erichtang/mainboard/hardware/foras-promineo-revB-em/images/mainboard-brd-bot.jpg

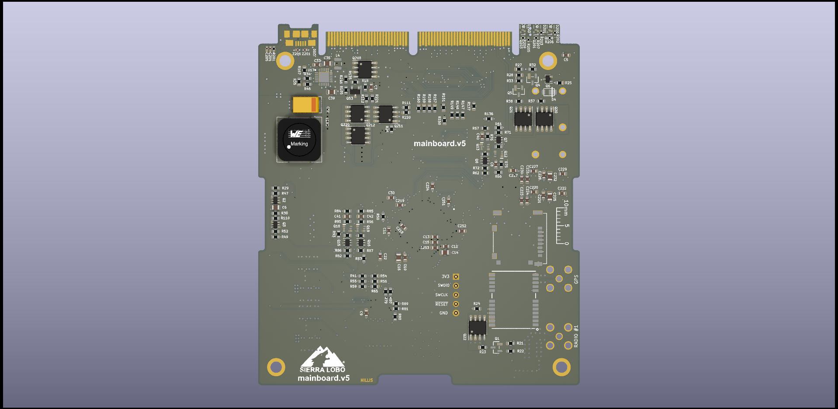
hardware/foras-promineo-revB-em/images/mainboard-brd-bot.jpg
