erichtang/mainboard/hardware/foras-promineo-revA-proto/images/mainboard.jpg

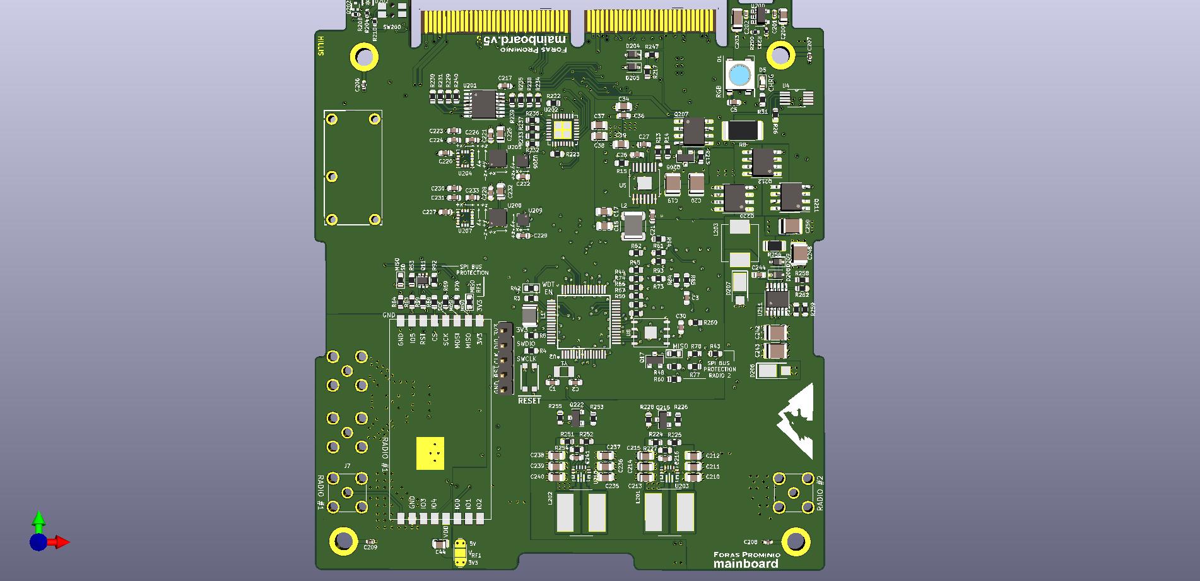
hardware/foras-promineo-revA-proto/images/mainboard.jpg
