erichtang/mainboard/software/foras-promineo/Foras Promineo Software Primer.pptx

## Foras Promineo Software

## Helpful References

- https://pycubed.org/
  - Site for all things pycubed. Very good Documentation by Max Holliday
- https://github.com/pycubed/forums/discussions
  - Forms where a lot of people have asked relevant questions

## Preferred IDE for Satellite Coding

- Visual Studio Code
  - With Python extension and PyLint extension
    - Pylint needs to be played with a little bit

## Using GitHub for code sharing

- Installing GitHub desktop
- Making a folder on your Z-drive
- Forking the repository
- Pushing changes to the master branch

## What is a Cubesat / Foras Promineo

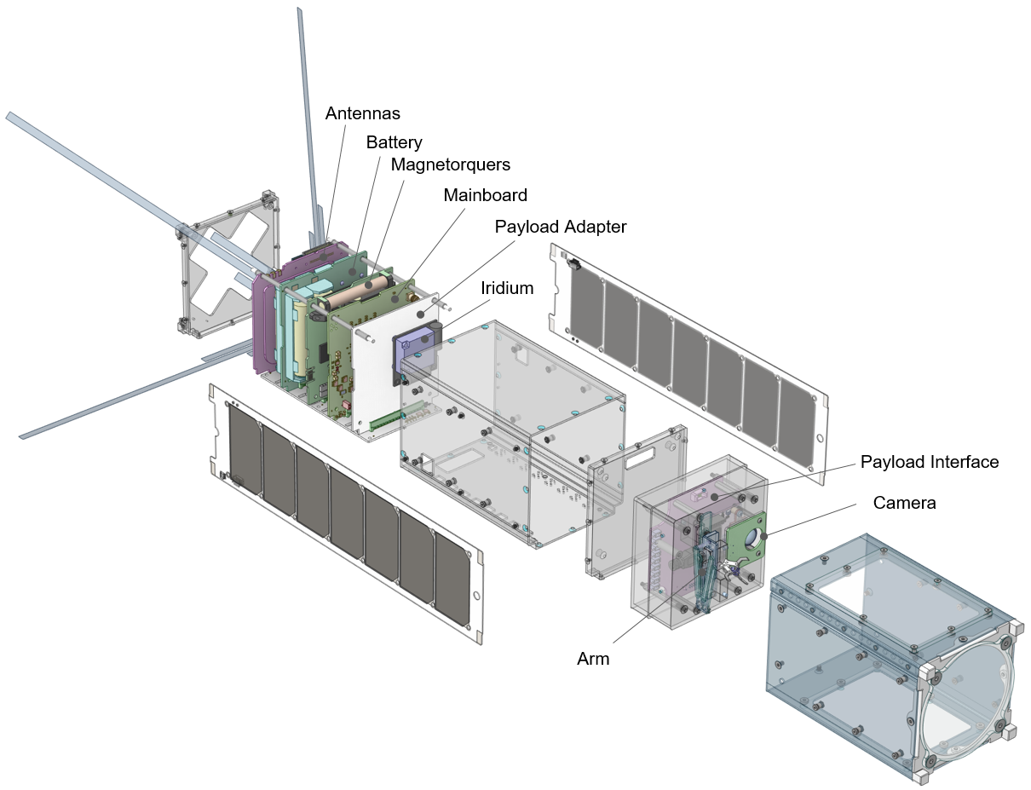
[picture p3: figure]

## Space Operation

Satellite Software
- Controls sat
- Manages radio comms
- Handles commands from Ground Station

LoRa Ground Station
- Sends and receives radio comms to/from satellite and ground station computer
- Points ground station antenna at sat during flyover

Website
- Shows “live” camera data
- Allows user keyboard inputs

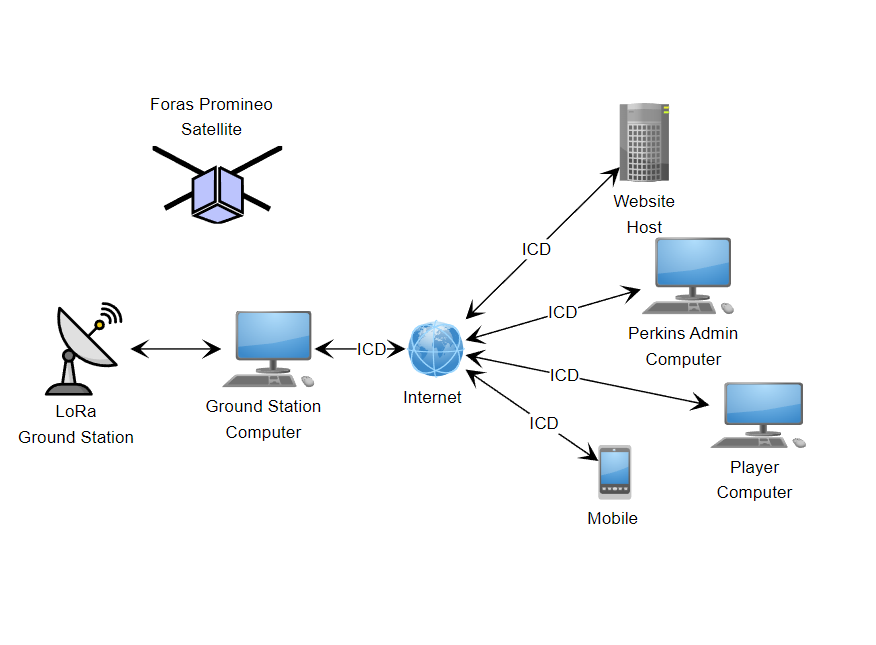
[picture p4: figure]

Ground Station Computer
- Send/Receive radio data from ground station
- Sends payload data to website
- Receives player input from Website

## Con-ops

- Host PC software (for debugging and testing on the ground)
- Ground Station PC Software
- Ground Station LoRa software
- Satellite Software
- Website

## Satellite Software Preface

- Satellite programming is mostly in CircuitPython. Firmware is written in C.
- Satellite programming is for a MICROCONTROLLER, so it is MUCH less powerful and fast than a PC!!
  - during normal execution there is <1MByte of RAM available for task execution.
  - Floating point is MUCH slower than integer operations
  - Data transactions over the radio are limited to 256 byte packets.
  - UART interface to payload is running at ~115600 baud
- Good practice is to just be mindful of what resources / typing your code is using.
  - Since python is dynamically typed, type casting in this application is quite important!
    - i.e. differences between a bool, int, float, char, and string object.
    - Also be aware of various decorations like the 0x (hex) or b’’ (binary) prefix, or @property.setters

## Satellite Software Preface (cont.)

- A lot of the background lower-level libs have been written by Max Alvarez (guy who developed PyCubed architecture) and Caden (me)

## Project File Structure

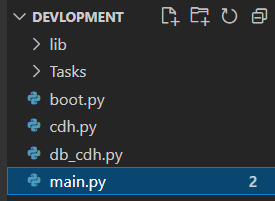
[picture p5: figure]

Top Level:
cdh, boot, and main files

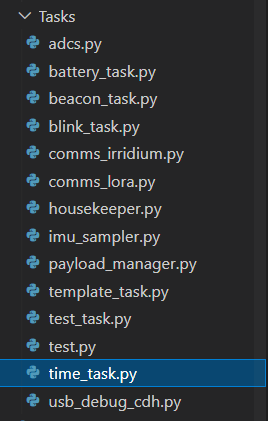
[picture p6: figure]

Task Directory:
Tasks

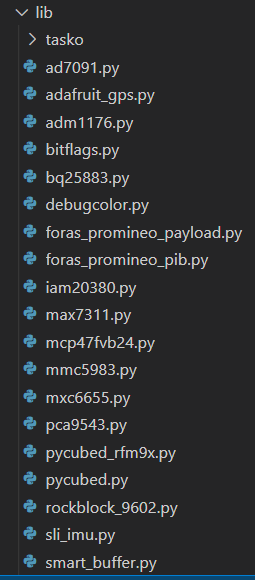
[picture p7: figure]

Lib Directory:
All lib files for usage.

## Slide 11

Master Library

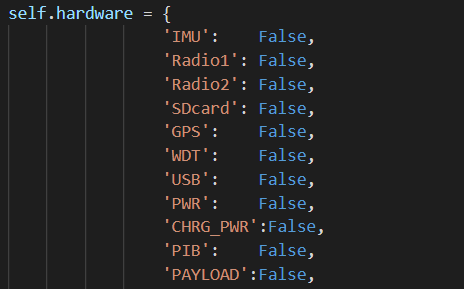
[picture p8: figure]

Hardware dictionary for each device in this library

Init routine initializes each device in self.hardware
Each initialization for the devices is within its own try – except clause.

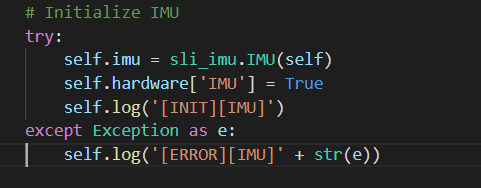
[picture p9: figure]

Example device init.

## Slide 12

Master Library (cont.)

Reinit (very important)

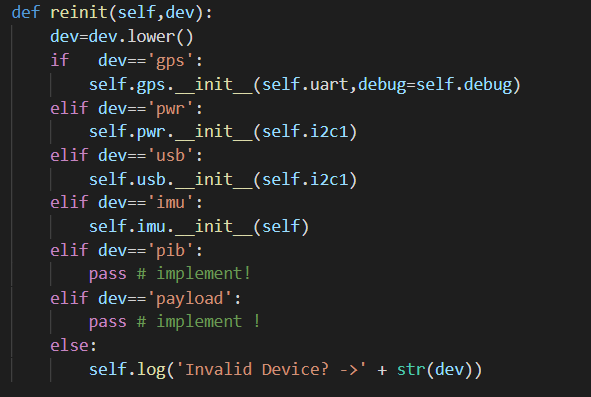
[picture p10: figure]

Example of a property, i.e. class variable

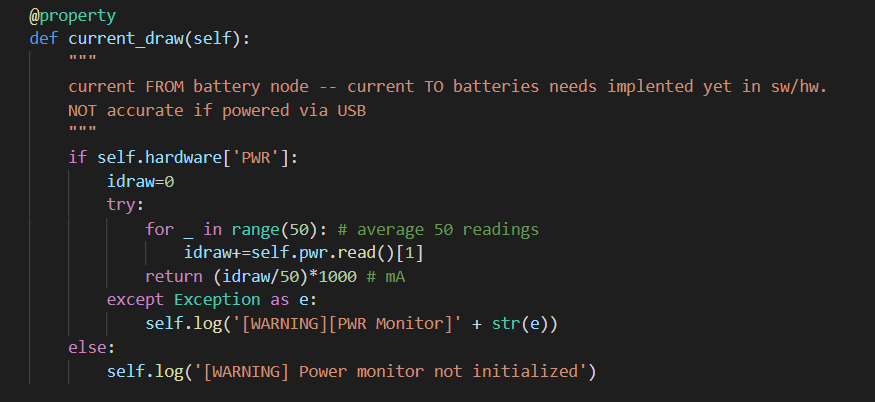
[picture p11: figure]

## Slide 13

Master Library

Power mode setting

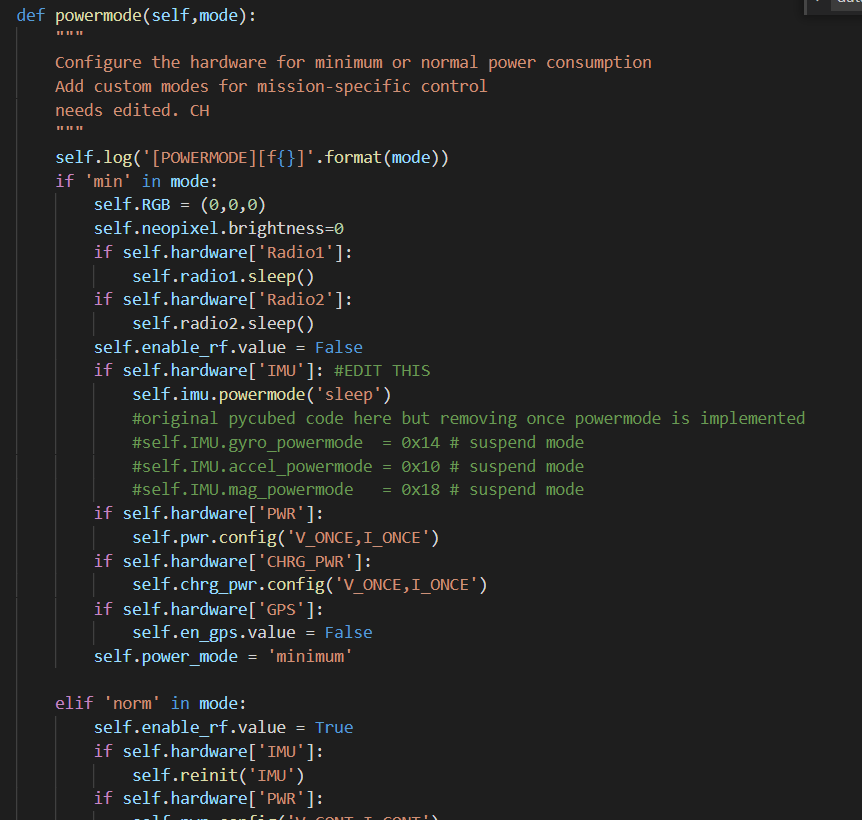
[picture p12: figure]

## Slide 14

Sub library example

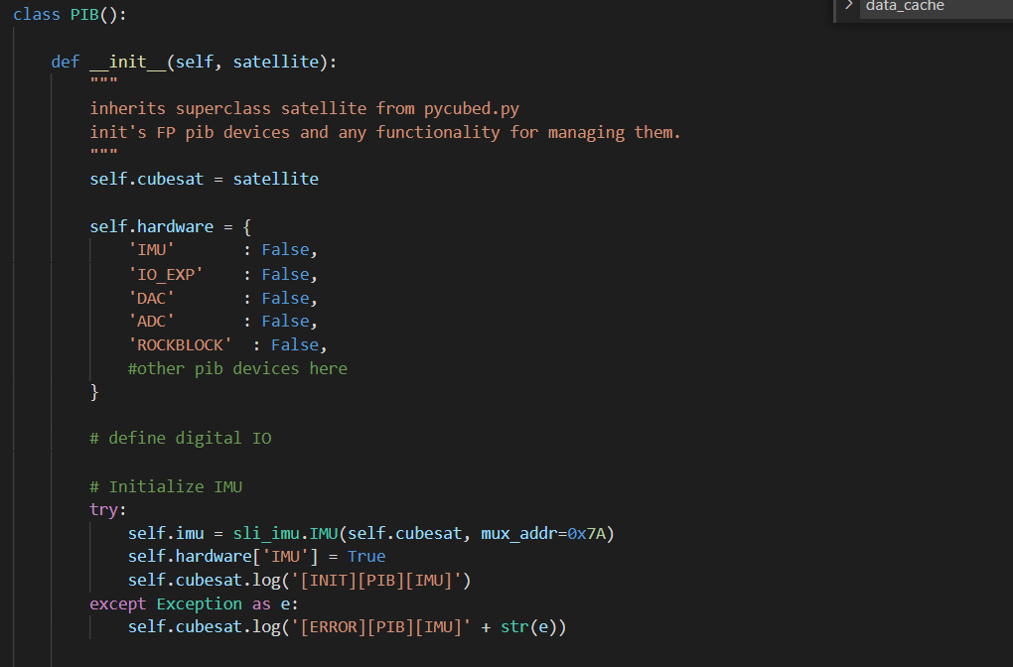
[picture p13: figure]

## Slide 15

Anatomy of a Task

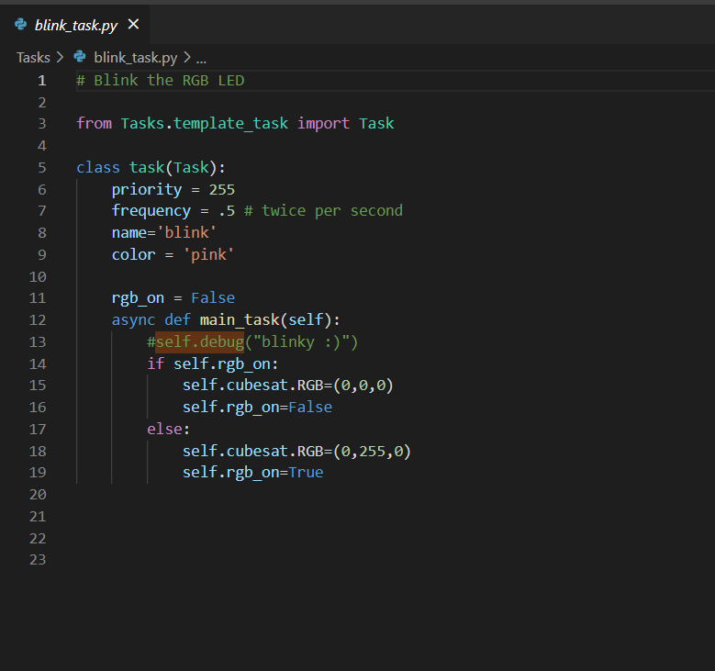
[picture p14: figure]

The mainboard executes tasks via a task scheduler

This is a task that blinks the led.
It is a subclass of task from template_task.py
When the task is executed, it runs the code within main_task.
Pycubed.py is self.cubesat
See priority and frequency for setting when a task will run.
To change priority and frequnency methods change_priority() and change_rate() must be called.

## template_task.py: the parent class to all tasks.

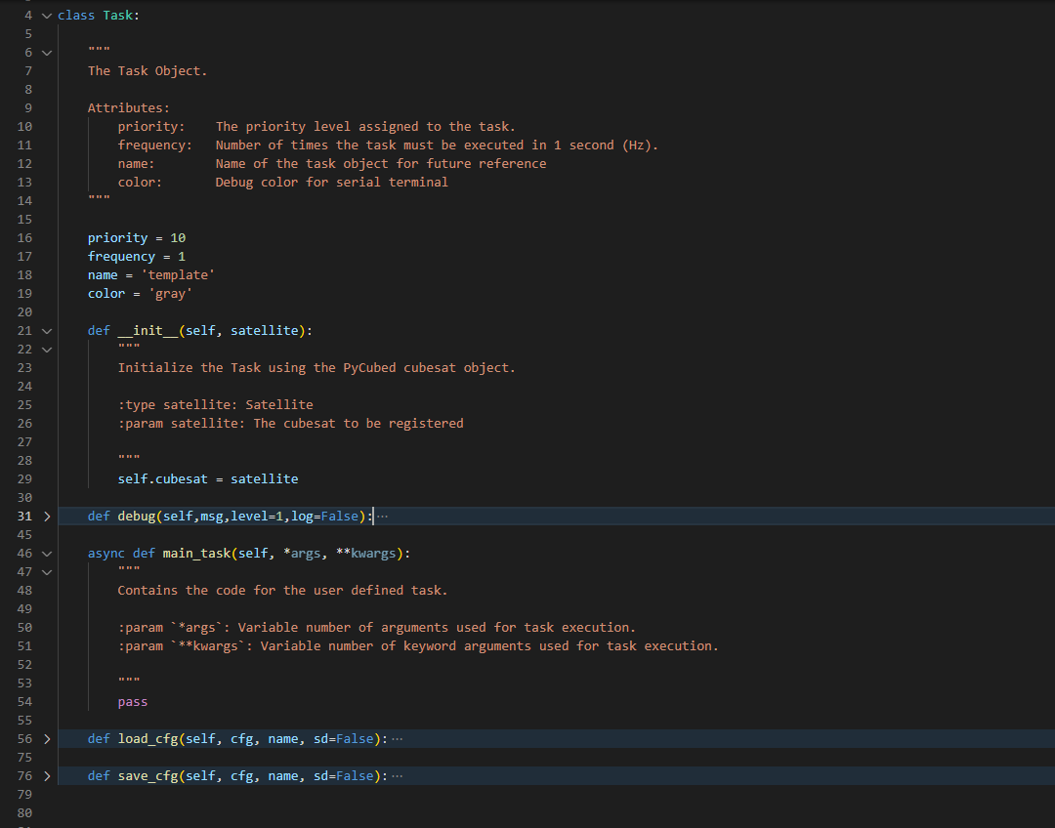
[picture p15: figure]

Some tasks may need a custom __init__ procedure
Every class can call debug() to print data to the terminal and optionally log it.
Load and save config are currently being tested. Not implemented for most tasks. These can be used for the cubesat to change task options mid-flight.

## Current Progress (as of 6/1/21)

- Mainboard is functional and all peripherals are coded in.
  - A new design revision will be made soon with some new features and some pinout changes.
- Payload interface board libraries in progress
  - ~90% complete, waiting on some parts and another design rev for the final design
- Tasks have been started, but nothing of true substance there just trying to get a good background set up
- Some PC/website software has been written.

## Things to Do:

- Define operating states and what tasks should run at what times
- Code high-level functionality
  - i.e. all the tasks, commands, data handling
- Define radio>mainboard>payload data exchange for target bitrate
- Test it for extended periods extensively
- Make sure all code written is executed successfully on ground
  - Fault handling is EXTREMELY important in this application
- Code pc host software to display live telemetry and simulate operations
- Code PC ground station software

## Phase 1 Plan

- Pair 1 will define and code simulation and data interface to host PC (main priority #2)
  - We image a python program with a gui and real-time telemetry data updating, Marek started something like this but it really only uploaded new code to the device
- Pair 2 will define and start to code the payload operation (main priority # 1)
  - Will be discussed in a moment
- Once host software is in a good state, it can start to be tested by Pair 1 Implementing the ADCS (main priority #3)
- Prioritize a minimum-functional implementation before coding in more sophisticated functionality:
  - For example, we would like to receive a stream of data from the openMV before there is error handling for dropped packets on the radio.

## USB Interface

Mainboard

Host PC

Circuitpython REPL
All debug data is also printed here

Circuitpython REPL terminal
Read debug data to display on GUI

USB

Usb_cdc.terminal

Usb_cdc.data

Db_cdh and simulation handling

Read/send cb_cdh and simulation commands

## Top Level Simulation / Debug Interface Flowchart

Phase 1 Goal

Usb connected?

Mainboard
Debug/ Host Interface

Send db_cdh commands to device from user GUI and/or terminal

Host PC

No

Yes

Set all simulation flags to 0

Look at usb_cdc.data port for new command

Execute command if detected

Value simulation flag True?

Query host for simulation data

Send queried simulation value over

Gather data from Debug data stream and display on GUI nicely

Mainboard
Simulation Interface

Debug Data Stream Output

## REPL terminal and data stream

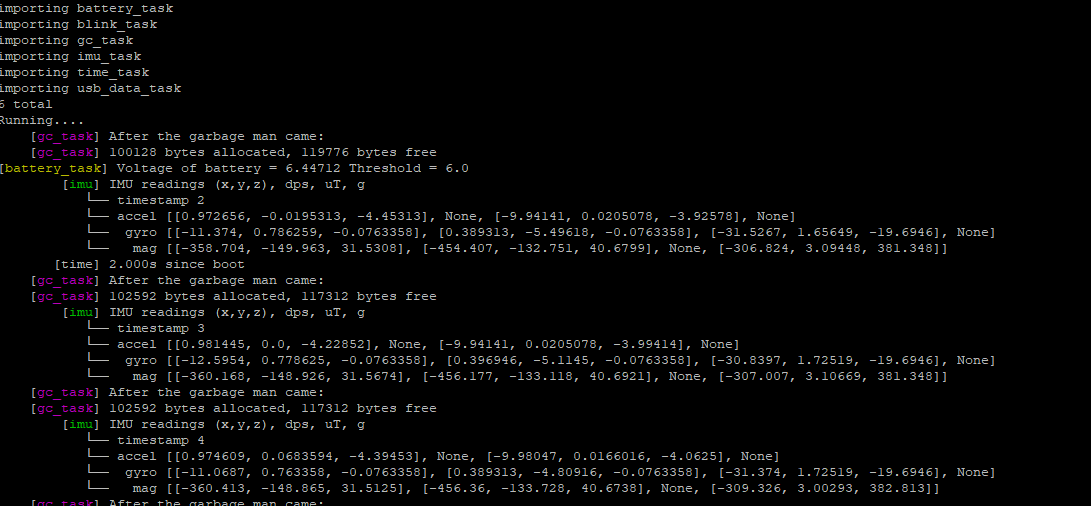
[picture p16: figure]

Regular circuitpython terminal.
Cubesat.debug prints data here
Print() command also prints here
Ctrl-C to end and ctrl-D to reload

## Debug command terminal

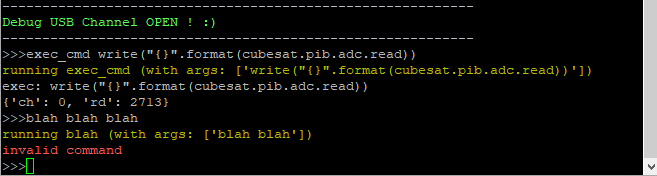
[picture p17: figure]

First asci encoded word “exec_cmd” is the keyphrase for the command to run
Then “ “ space for arguments passed
All arguments are separated by “arg0,arg1” comma right now, not “arg0, arg1“ comma space
Not implemented yet, but this is where the device will also ask for simulation data

## Main Operation Modes of Satellite

Each mode will have several substates.
Each mode/state will probably have specific tasks/ change task settings on the fly.

STARTUP MODE

- Runs once, x amount of time after initial deployment
- Deploys deployables
- Initial system checkout and startup
  - i.e. ADCS detumble,
  - ADCS calibrate,
  - ETC.

SAFE MODE

- Turns everything off, sleeps for x amount of time when it will re-check everything and try to re-enter idle mode.
- Probably will beacon once for help during this. An override function may be implemented

IDLE MODE

- Device in this mode most of time.
- Will beacon over LoRa looking for commands from ground.
- Payload will be powered off.
- ADCS in point mode

PAYLOAD MODE

- Initiated from idle mode to start payload experiment.
- Recieves data stream over LoRa for next arm/exec command
- Sends data stream down of payload camera, arm, and important telemetry.
- ADCS in payload_comp() mode, where it will hold and try to ignore arm torque exerted. (Low priority)
  - If time, implement where cubesat will point at ground for better data transmission and reception.
- I have a baseline experiment with a few free-running tasks right now, but this may need to be moved to a more discrete “frame”-like interface…

## STARTUP Mode

1. Wait x amount of time
2. Deploy antenna
3. Preform initial ADCS calibration
4. Do initial device checkout
5. Initiate first downlink

## Safe Mode

- Turns all non-critical devices off.
- Checks periodically for exit criteria to return to idle mode.
- Will beacon SOS as a last resort

## Idle Mode

- Will spend most time here.
- ADCS will be running
- Beaconing every so often to try to initiate contact with ground station

## Payload Mode

- Checks Rx port for latest command data.
  - Mostly user inputs from website
- Sends data to payload and executes commands
- When a photo is requested from GS, the sat will burst down a photo

## Over the Air (OTA)(Radio) Commands

- Separate packet structures for 2 modes, beacon and connected.
- RadioHead is the background library used by the GS and the sat. It does most of the handling for a header and ACK response.
- The Satellite will receive commands from the ground-station less than 240bytes.

## Default “Beacon Mode” Radio Mode

Satellite

Ground Station

Transmit Beacon

Recieve response?

Receive Data?

No

No

Yes

Yes

Send Command

Execute Command

Transmit Response

## Default “Beacon Mode” Radio Packet Structure

Transmit / Receive both sides

Super Secret Code
X bytes

RadioHead Header
4 Bytes

Our Header
2 bytes

Command / response code
2 bytes

Args

Command
2 bytes

…..

## High-Speed “Connected” Radio Mode

Runs at frequency passed by start connected mode cmd

Satellite

Connected Mode START

Burst Mode?

Listen

Heard? Some-thing?

Buffer Ready?

Yes

Yes

Send Buffer

Increment Timeout Counter

No

Last Byte?

Yes

End burst mode

No

Connected mode will often be terminated by a command.

Yes

Execute CMD

Timeout Trigger?

Yes

End Connected Mode

## “Connected Mode” Radio Packet Structure

Burst Transmit

RadioHead Header
4 Bytes

Super Secret Code
X bytes

Header
6 bytes

Data

Args

Command
2 bytes

…..

Receiver will not respond until the burst is over!

## Our Header Structure

- Bytes 1-2 : Flags (i.e. listen again, last transmission, etc…)
  - Idea: have a multi-packet flag for the radio to listen again and look for packet number bytes?
- Bytes 3-4 : packet number
- Bytes 5-6 : number of packets to send

## Minimum Functionality (Payload)

Phase 1 goal overview

Send Payload Init command

Tx control data at x freq

Yes

Rx image data

GS

Send response (yes/no)

Rx command/control data

Tx burst image data down

Sat

Rx done?

img cmd Rx?

No

No

Yes

## adcs_task.py

- Consult CryoCube code, Dr. Walker’s Dissertation, and Dr. Walker for details

## payload_task.py

- Initated by command payload_start:
- This only gets camera data from the openMV if the img_burst flag is true. Otherwise, it will do nothing.
  - Other payload management tasks can go here

Img burst flag?

Send_buf flag?

Place next chunk in buffer

Set send_buf flag

Start

Yes

No

## db_cdh.py / usb_data_task.py

- Debug commands sent via host PC
- implement ability to run regular flight cdh.py commands with normal output over radio and debug info via USB.

## cdh.py

- All of the “in flight” commands will go here.
- setting persistent settings, imitating payload, printing log, printing telemetry, etc.
- Some commands like exec, query, and hreset will probably have to be password-protected in addition?

## Radio tasks

- Radios beacon unless they are “connected”
  - Connection is a command sent where the GS specifies a frequency to check for new messages
  - During this, they will explicitly listen unless prompted to burst data down by GS

## Telemetry gathering tasks

- Imu_task.py
  - Reads IMU data and overwrites data in cubesat.data_buffer{“imu”}.
- GPS_task.py
  - Reads GPS data and overwrites data in cubesat.data_buffer{“gps"}
- Temperature_task.py
  - Reads various temperatures and overwrites data in cubesat.data_buffer{“temp”}
  - Turns overheating devices off.
- Time_task.py
  - Prints time data.
- Battery_task.py
  - Gathers battery information and power readings. Initiates safe mode if low battery is detected.

## Housekeeper task

- Detects errors on satellite and attempts to fix them.
- Preforms a daily hard reset to the satellite
- Other housekeeping tasks?
  - gc_collect is already its own thing running at 2Hz
- Maybe separate this into its own error handling tasks
- I’ve yet to decide if this should be one or many tasks…
