erichtang/mainboard/hardware/design/inhibit_sim/inhibit states.xlsx

INPUT |  |  |  |  |  |  | OUTPUT |  |  |  | SEP4 is not a sep sw, only used for gnd debug. Will be open during flight.
 | sep1 | sep2 | sep3 | sep4 | RBF | 5Vusb | low inhibit | high inhibits | vchrg_usb | vbus_usb | note
 | closed | closed | closed | open | open | x | closed | closed | open | open | flight
 | open | x | x | x | x | no | open | x | x | x | low side is closed when sep
 | x | open | x | x | x | x | x | open | x | x
 | x | x | open | x | x | x | x | open | x | x
 | x | x | x | closed | x | x | s | open | s | s
 |  |  |  |  | closed | x | s | open | s | s
 | x | x | x | open | low | yes | closed | open | closed | open | ground charge
 | x | x | x | low | low | yes | closed | open | closed | closed | debug w/ charge
 | x | x | x | low | open | yes | closed | open | open | closed | debug
