erichtang/mainboard/hardware/design/stackup/stackup.PNG

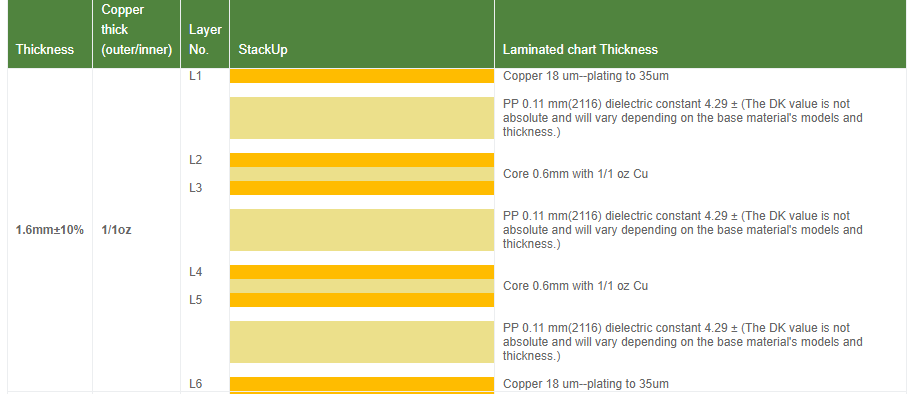
hardware/design/stackup/stackup.PNG
