erichtang/mainboard/hardware/foras-promineo-revA-proto/images/mainboard_original.jpg

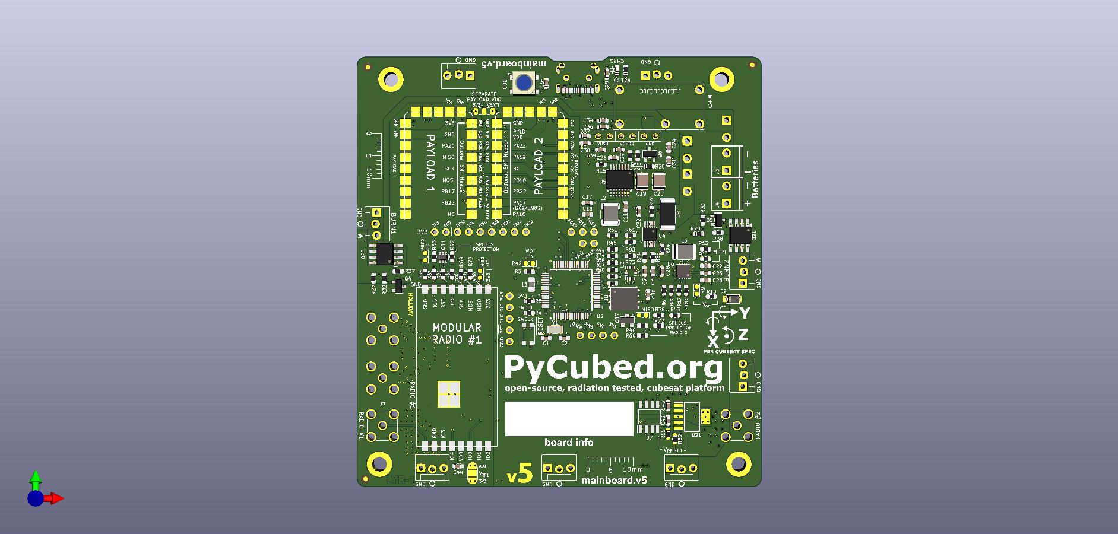
hardware/foras-promineo-revA-proto/images/mainboard_original.jpg
