erichtang/mainboard/hardware/foras-promineo-revB-em/images/mainboard-brd-top.jpg

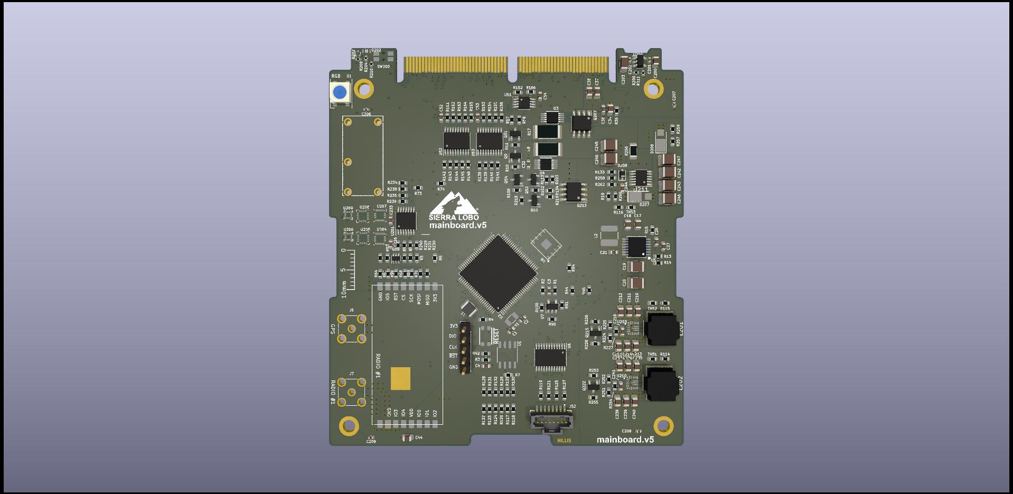
hardware/foras-promineo-revB-em/images/mainboard-brd-top.jpg
