erichtang/mainboard/hardware/foras-promineo-revB-em/bom/mainboard.xlsx

Item | Qty | Reference(s) | Value | Footprint | Mfr. P/N | DNI
1 | 2 | C1, C2 | 8pF | Capacitor_SMD:C_0603_1608Metric | ~
2 | 21 | C3, C5, C9, C10, C11, C21, C22, C30, C52, C53, C216, C217, C218, C219, C224, C231, C234, C241, C251, C252, C253 | 0.1uF | Capacitor_SMD:C_0603_1608Metric | ~
3 | 11 | C4, C12, C13, C15, C27, C33, C221, C222, C228, C229, C244 | 1uF | Capacitor_SMD:C_0603_1608Metric | ~
4 | 4 | C6, C35, C44, C46 | 10uF | Capacitor_SMD:C_0805_2012Metric | ~
5 | 3 | C7, C26, C32 | 3.3nF | Capacitor_SMD:C_0603_1608Metric | ~
6 | 6 | C8, C40, C41, C42, C220, C227 | 10nF | Capacitor_SMD:C_0603_1608Metric | ~
7 | 12 | C14, C16, C39, C200, C210, C211, C212, C225, C232, C235, C236, C237 | 10uF | Capacitor_SMD:C_0805_2012Metric | ~
8 | 10 | C17, C18, C37, C38, C213, C214, C215, C238, C239, C240 | 22uF | Capacitor_SMD:C_0805_2012Metric | ~
9 | 2 | C19, C20 | 100uF | Capacitor_SMD:C_1210_3225Metric | ~
11 | 1 | C34 | 4.7uF | Capacitor_SMD:C_0805_2012Metric | ~
12 | 1 | C36 | 47nF | Capacitor_SMD:C_0603_1608Metric | ~
13 | 1 | C51 | 100uF | Capacitor_Tantalum_SMD:CP_EIA-7343-43_Kemet-X | T498X107K016ATE075
14 | 1 | C54 | 0.01uF | Capacitor_SMD:C_0603_1608Metric | ~
15 | 7 | C201, C202, C204, C206, C207, C208, C209 | 0.1uF | Capacitor_SMD:C_0402_1005Metric | ~
16 | 1 | C203 | 47uF | Capacitor_SMD:C_1206_3216Metric | GRT31CR61A476KE13L
17 | 1 | C205 | 1nF | Capacitor_SMD:C_0402_1005Metric | ~
18 | 2 | C223, C230 | 2.2uF | Capacitor_SMD:C_0603_1608Metric | ~
19 | 2 | C226, C233 | 0.47uF | Capacitor_SMD:C_0603_1608Metric | ~
20 | 6 | C242, C243, C245, C246, C247, C248 | 10uF | Capacitor_SMD:C_1210_3225Metric | CNA6P1X7R1H106K250AE
21 | 1 | D1 | WS2812B | LED_SMD:LED_WS2812B_PLCC4_5.0x5.0mm_P3.2mm | WS2812B-B
22 | 1 | D4 | DFLS130L | mainboard:PWRDI-123 | DFLS130L-7
23 | 1 | D200 | RED | SLI-Blank-Card:APA2107x | APA2107LSECK/J3-PRV
24 | 1 | D201 | YELLOW | SLI-Blank-Card:APA2107x | APA2107SYCK/J3-PRV
25 | 1 | D202 | GREEN | SLI-Blank-Card:APA2107x | APA2107CGCK
26 | 1 | D203 | ORANGE | SLI-Blank-Card:APA2107x | APA2107SECK/J4-PRV
27 | 2 | D206, D207 | V4PAL45HM3_A/I | mainboard-SLI:SMPA | V4PAL45HM3_A/I
28 | 1 | D208 | 1N4148WSTR | Diode_SMD:D_SOD-323 | 1N4148WSTR
31 | 1 | J1 | 503182-1852 | mainboard:MOLEX_503182-1852 | 5031821852
32 | 1 | J2 | Conn_01x05 | Connector_PinHeader_2.54mm:PinHeader_1x05_P2.54mm_Vertical
33 | 3 | J5, J7, J12 | Amphenol_901-144 | Connector_Coaxial:SMA_Amphenol_901-144_Vertical | 901-144
34 | 1 | J52 | T1M-08-F-SV-L | mainboard-SLI:SAMTEC_T1M-08-F-SV-L | T1M-08-F-SV-L
35 | 1 | J200 | ZX62-AB-5PA(31) | SLI-Backplane-Blank-Card-KiCad:ZX62-AB-5PA(31) | ZX62-AB-5PA(31)
36 | 1 | L1 | 10uH | Inductor_SMD:L_1210_3225Metric | BCL322520RT-100M-D
37 | 1 | L2 | 3.3uH | mainboard:L_2141 | SPM5030T-3R3M-HZ
38 | 1 | L4 | 1uH | mainboard:L_2510 | DFE252012F-1R0M
39 | 2 | L201, L202 | 1.5uH | mainboard-SLI:L_Bourns_SRN8040TA | SRN8040TA-1R5Y
40 | 1 | L203 | 22uH | mainboard-SLI:L_Wuerth_WE-PD-1260 | 7447709220
42 | 3 | Q1, Q4, Q5 | DMN100-7-F | mainboard:SOT-23 | DMN100-7-F
43 | 6 | Q2, Q3, Q7, Q8, Q15, Q16 | MMDT5551-7-F | Package_TO_SOT_SMD:SOT-363_SC-70-6 | MMDT5551-7-F
44 | 1 | Q6 | SMMBT2222AWT1G | Package_TO_SOT_SMD:SOT-323_SC-70
45 | 8 | Q9, Q10, Q17, Q52, Q53, Q54, Q215, Q222 | MMBT3906-7-F | Package_TO_SOT_SMD:SOT-23 | MMBT3906-7-F
46 | 1 | Q11 | MMDT2907AQ-7-F | Package_TO_SOT_SMD:SOT-363_SC-70-6 | BSS138DWQ-7 or MMDT2907AQ-7-F
47 | 4 | Q12, Q13, Q18, Q19 | BSS138DWQ-7 | mainboard:BSS138DWQ-7 | FJV992FMTF
49 | 8 | Q20, Q21, Q22, Q207, Q211, Q212, Q213, Q220 | IRF7404TRPBF | Package_SO:SOIC-8_3.9x4.9mm_P1.27mm | IRF7404TRPBF
50 | 1 | Q51 | MMBT4401-7-F | Package_TO_SOT_SMD:SOT-23 | MMBT4401-7-F
51 | 4 | Q200, Q201, Q202, Q203 | BC847BM3T5G | Package_TO_SOT_SMD:SOT-723
53 | 1 | Q208 | IRF7458 | Package_SO:SOIC-8_3.9x4.9mm_P1.27mm | IRF7458
54 | 1 | R1 | 316k | Resistor_SMD:R_0603_1608Metric | ~
55 | 1 | R2 | 110k | Resistor_SMD:R_0603_1608Metric | ~
56 | 40 | R3, R4, R5, R7, R21, R24, R25, R27, R28, R42, R43, R44, R45, R46, R50, R51, R52, R57, R61, R62, R65, R66, R67, R82, R83, R84, R85, R105, R114, R115, R116, R119, R121, R125, R127, R218, R230, R231, R235, R238 | 10k | Resistor_SMD:R_0603_1608Metric | ~
57 | 40 | R6, R10, R15, R19, R30, R37, R38, R41, R49, R54, R55, R56, R59, R73, R74, R90, R91, R93, R94, R102, R106, R117, R118, R123, R124, R129, R130, R131, R132, R167, R225, R227, R229, R234, R239, R240, R252, R254, R259, R260 | 100k | Resistor_SMD:R_0603_1608Metric | ~
58 | 2 | R8, R17 | 0.1 | Resistor_SMD:R_2512_6332Metric | ~
59 | 6 | R11, R103, R216, R219, R220, R221 | 1Meg | Resistor_SMD:R_0603_1608Metric | ~
60 | 2 | R13, R29 | 73.2k | Resistor_SMD:R_0603_1608Metric | ~
61 | 1 | R14 | 22.1k | Resistor_SMD:R_0603_1608Metric | ~
62 | 12 | R18, R26, R63, R64, R69, R70, R77, R78, R120, R122, R126, R128 | 1k | Resistor_SMD:R_0603_1608Metric | ~
63 | 6 | R22, R32, R33, R60, R68, R92 | 4.7k | Resistor_SMD:R_0603_1608Metric | ~
64 | 3 | R23, R226, R253 | 3.3k | Resistor_SMD:R_0603_1608Metric | ~
65 | 1 | R34 | 5.23k | Resistor_SMD:R_0603_1608Metric | ~
66 | 1 | R35 | 30.1k | Resistor_SMD:R_0603_1608Metric | ~
67 | 1 | R36 | 3.16k | Resistor_SMD:R_0603_1608Metric | ~
68 | 5 | R47, R75, R76, R95, R96 | 200k | Resistor_SMD:R_0603_1608Metric | ~
69 | 10 | R48, R53, R97, R98, R99, R101, R104, R107, R108, R109 | 0 | Resistor_SMD:R_0603_1608Metric | ~
70 | 12 | R58, R79, R80, R81, R88, R89, R100, R111, R112, R113, R134, R135 | 100 | Resistor_SMD:R_0603_1608Metric | ~
71 | 4 | R71, R72, R86, R87 | 680 | Resistor_SMD:R_0603_1608Metric | ~
72 | 1 | R110 | 20k | Resistor_SMD:R_0603_1608Metric | ~
73 | 2 | R133, R262 | 412k | Resistor_SMD:R_0603_1608Metric | ~
74 | 29 | R136, R137, R138, R139, R140, R141, R142, R143, R144, R145, R146, R147, R148, R149, R150, R151, R153, R154, R155, R156, R157, R158, R159, R160, R161, R162, R163, R164, R165 | 330 | Resistor_SMD:R_0603_1608Metric | ~
75 | 2 | R152, R166 | 2.7k | Resistor_SMD:R_0603_1608Metric | ~
76 | 2 | R200, R211 | 10k | Resistor_SMD:R_0402_1005Metric | ~
77 | 1 | R201 | 1Meg | Resistor_SMD:R_0402_1005Metric | ~
78 | 8 | R202, R203, R204, R205, R206, R207, R208, R209 | 1.5k | Resistor_SMD:R_0402_1005Metric | ~
79 | 1 | R210 | DNP | Resistor_SMD:R_0402_1005Metric | ~
80 | 2 | R224, R251 | 523k | Resistor_SMD:R_0603_1608Metric | ~
81 | 2 | R228, R255 | 330k | Resistor_SMD:R_0603_1608Metric | ~
82 | 1 | R256 | 0.05 | Resistor_SMD:R_1206_3216Metric | WSLP1206R0500DEA
83 | 1 | R257 | 121k | Resistor_SMD:R_0603_1608Metric | ~
84 | 1 | R258 | 634k | Resistor_SMD:R_0603_1608Metric | ~
85 | 1 | SW1 | KMR231NG LFS | mainboard:BTN_KMR2_4.6X2.8 | KMR231NG LFS
86 | 1 | SW200 | SW_Push_SPST | SLI-Blank-Card:EVQP7C01P | EVQP7C01P
87 | 3 | TH51, TH52, TH53 | 10k | Resistor_SMD:R_0603_1608Metric | ~
88 | 1 | U1 | MAX706RESA | Package_SO:SO-8_3.9x4.9mm_P1.27mm | MAX706RESA
89 | 1 | U2 | ATSAMD51N20A-AUT | Package_QFP:TQFP-100_14x14mm_P0.5mm | ATSAMD51N20A-AUT
90 | 2 | U3, U4 | ADM1176-1ARMZ-R7 | mainboard:ADM1176-1ARMZ-R7 | ADM1176-1ARMZ-R7
91 | 1 | U5 | TPS54226PWPRPWP14_2P31X2P46-L | mainboard:PWP14_2P31X2P46-L | TPS54226PWPR
92 | 1 | U6 | 74HC4067PW,118 | Package_SO:TSSOP-24_4.4x7.8mm_P0.65mm | 74HC4067PW,118
93 | 1 | U7 | OPA340MDBVTEP | Package_TO_SOT_SMD:SOT-23-5 | OPA340MDBVTEP
94 | 1 | U8 | MR25H40MDF | mainboard:SON127P600X500X90-9N | MR25H40MDF
95 | 1 | U14 | Orion GPS | mainboard:S1216_24PIN_PACKAGE | S1216V8 | DNI
97 | 1 | U16 | PE014006 | mainboard:RELAY_PE014006 | PE014006 TE
98 | 1 | U17 | BQ25883RGER | mainboard:QFN50P400X400X100-25N-D | BQ25883RGER
99 | 2 | U23, U24 | RFM98PW | mainboard:RFM95PW | RFM98PW | DNI
100 | 1 | U51 | LTC4307 | Package_SO:MSOP-8_3x3mm_P0.65mm | LTC4307IMS8#TRPBF
101 | 2 | U52, U53 | SN74LVCH245APWR | Package_SO:TSSOP-20_4.4x6.5mm_P0.65mm | SN74LVCH245APWR
102 | 1 | U200 | AP2161W | Package_TO_SOT_SMD:SOT-23-5 | AP2161W
103 | 1 | U201 | PCA9543APW,118 | Package_SO:TSSOP-14_4.4x5mm_P0.65mm | PCA9543APW,118
104 | 2 | U203, U210 | TPS63070 | mainboard-SLI:TPS63070RNMR | TPS63070
105 | 2 | U204, U207 | IAM-20380 | mainboard-SLI:IAM-20380 | IAM-20380
106 | 2 | U205, U208 | MMC5983MA | mainboard-SLI:MMC5983MA | MMC5983MA
107 | 2 | U206, U209 | MXC6655XA | mainboard-SLI:MXC6655XA | MXC6655XA
108 | 1 | U211 | ‎LT3652HVEMSE#TRPBF‎ | mainboard-SLI:MSOP-12-1EP_3x4mm_P0.65mm_EP1.65x2.85mm_ThermalVias | ‎LT3652HVEMSE#TRPBF‎
109 | 1 | Y1 | 32.768kHz | Crystal:Crystal_SMD_3215-2Pin_3.2x1.5mm | ABS07-32.768KHZ-T
110 | 2 | Z200, Z201 | CG0402MLU-05G | Capacitor_SMD:C_0402_1005Metric | CG0402MLU-05G
