erichtang/mainboard/hardware/foras-promineo-revA-proto/fabrication-data/mainboard_log.xlsx

Sheet: Design Changes
Make manufacturer put no solder on unused pads
Make manufacturer assemble all parts even if we have to cosign them, these boards are challenging to assemble

Sheet: FP-P-01
Board Location: | SLI TDEC in Foras Promineo ESD tote
Date | Action | Comment | Date | Todo | Comment
2022-02-16 | Received |  | 2022-02-17 | Place C201 C202 C204 C206 C207 C208 C209, They were accidently labeled as 0603 parts in the BOM. p/n rom backplane
2022-02-17 | Removed all unused pads’ solder |  | 2022-02-17 | Place R8
2022-02-17 | Placed U4, U5, U8, U203, U210, U211, | U210 looked a little sketchy | 2022-02-17 | Verify R13, 29 are placed
 |  |  | 2022-02-17 | Verify Q221 and Q209
 |  |  | 2022-02-17 | Place L1
 |  |  | 2022-02-17 | Verify C242, C243, C245, C246, C247, C248 placement
 |  |  | 2022-02-17 | Place U2
 |  |  | 2022-02-17 | Place U4
 |  |  | 2022-02-17 | Place U5
 |  |  | 2022-02-17 | Place U8
 |  |  | 2022-02-17 | Place U13 ?
 |  |  | 2022-02-17 | Place U14 ?
 |  |  | 2022-02-17 | Place U16
 |  |  | 2022-02-17 | Place U17
 |  |  | 2022-02-17 | Place U23, 24 ?
 |  |  | 2022-02-17 | Place U203, U210
 |  |  | 2022-02-17 | Place U204, U207
 |  |  | 2022-02-17 | Place U211
 |  |  | 2022-02-17 | L1, R8 buy | done

Sheet: FP-P-02
Board Location: | Caden
Date | Action | Comment | Date | Todo | Comment
2022-02-16 | Received |  | 2022-02-17 | Place C201 C202 C204 C206 C207 C208 C209, They were accidently labeled as 0603 parts in the BOM. p/n rom backplane
2022-02-17 | Removed all unused pads’ solder |  | 2021-02-27 | buy rf connectors
2022-02-17 | Placed U2, U4, U5, U8, U203, U204, U207, U210, U211, |  |  | load test regulators to rated maximums
2021-02-27 | Placed all 0.1uF 0603 caps |  |  | test burn wire circuit
2021-02-27 | Placed L1, R8 |  |  | add rf connectors
2021-02-27 | Verified no shorts to ground exist on any power rails |  |  | replace leds w neopixels
2021-02-27 | verified no shorts to ground exist on any output lines |  |  | replace debug inibit ckt
3/?/21 | firmware loaded successfully
2021-03-13 | board runs basic_eval program, not all systems interfaced but no noticeable errors found.
2021-03-13 | verified comms I2C devices(besides USB battery charger)
2021-03-14 | added ground GPS and LoRa units
2021-03-14 | USB Battery charger IC is wrong P/N, needs changed, replacement ordered from alibaba
2021-03-15 | 5V_debug current draw when idle = 82mA
2021-03-15 | V_RF and V_PYLD measured at 5.04V @ no load
2021-03-15 | 7V applied to VBATT +/-'s and idle draw was 22mA, V_RF and V_PYLD at 5.04V
2021-03-15 | breakout +y solar pwr LEF fet caused malfunction of solar charge regulator, fixed
2021-03-16 | verified / debugged / editied inhibit ckt, need to edit these for FM, notes made in BP and MB files
2021-03-16 | debug inhibit circuits should b replaced with jumpers, removed this circuit on EM
