erichtang/mainboard/hardware/foras-promineo-revA-proto/fabrication-data/pcbway-run-2112/hands-on fab that needs to be done.xlsx

Sheet: Export Summary
This document was exported from Numbers. Each table was converted to an Excel worksheet. All other objects on each Numbers sheet were placed on separate worksheets. Please be aware that formula calculations may differ in Excel.
Numbers Sheet Name | Numbers Table Name | Excel Worksheet Name
Sheet1
 | Table 1 | Sheet1
Changes
 | Table 1 | Changes
FP-P-01
 | Table 1 | FP-P-01
FP-P-02
 | Table 1 | FP-P-02

Sheet: Sheet1
No. | Action | Complete?
1 | Place C201 C202 C204 C206 C207 C208 C209, They were accidently labeled as 0603 parts in the BOM. p/n rom backplane
2 | Place R8
3 | Verify R13, 29 are placed
4 | Verify Q221 and Q209
5 | Place L1
6 | Verify C242, C243, C245, C246, C247, C248 placement
7 | Place U2
8 | Place U4
9 | Place U5
10 | Place U8
11 | Place U13 ?
12 | Place U14 ?
13 | Place U16
14 | Place U17
15 | Place U23, 24 ?
16 | Place U203, U210
17 | Place U204, U207
18 | Place U211

Sheet: Changes
Table 1
Make manufacturer put

Sheet: FP-P-01
Table 1

Sheet: FP-P-02
Table 1
