erichtang/mainboard/hardware/design/WBDesign15.pdf

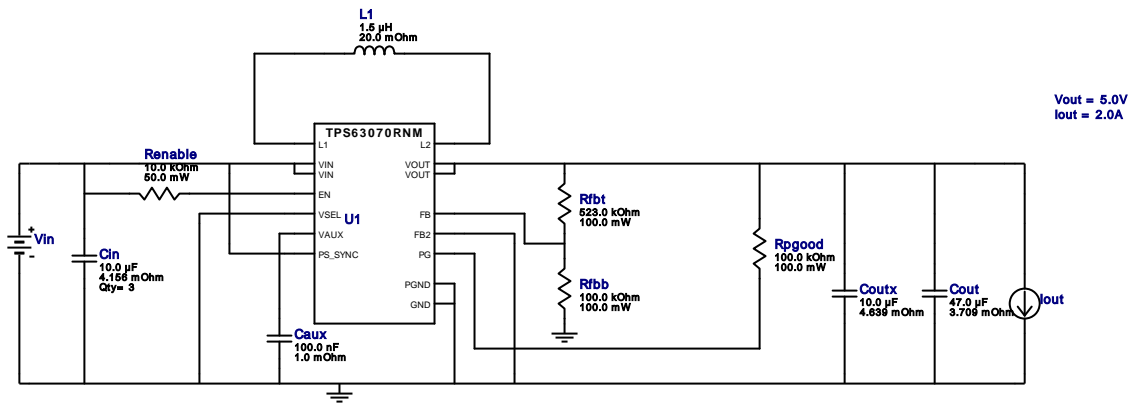
[picture p23: figure]
Rfbt 523.0 kOhm 100.0 m W; Cout 47.0 µF 3.709 m Ohm; L1 1.5 µH 20.0 m Ohm; Cin 10.0 µF 4.156 m Ohm Qty= 3; TPS6 3 0 7 0 RNM; PS_SYNC; VAUX; GND; VOUT; PGND; VIN VIN; VSEL U1; Caux 100.0 nF 1.0 m Ohm; Rfbb 100.0 kOhm 100.0 m W; Renable 10.0 kOhm 50.0 m W; Vout = 5.0V Iout = 2.0A; Rpgood 100.0 kOhm 100.0 m W; Coutx 10.0 µF 4.639 m Ohm; Vin; Iout

Copyright © 2021, Texas Instruments Incorporated | 1 | ti.com/webench

WEBENCH®
Design Report TPS63070RNMR : TPS63070RNMR 5V-10V to 5.00V @ 2A December 9, 2021 11:47:06 GMT-06:00

## WEBENCH ® Design Report

Design : 15 TPS63070RNMR
TPS63070RNMR 5V-10V to 5.00V @ 2A

VinMin = 5.0V
VinMax = 10.0V
Vout = 5.0V
Iout = 2.0A

Device = TPS63070RNMR
Topology = Buck_Boost
Created = 2021-12-09 11:46:40.713 BOM Cost = $2.75
BOM Count = 12
Total Pd = 0.61W

## Electrical BOM

Name | Manufacturer | Part Number | Properties | Qty Price | Footprint
Caux | MuRata | GRM155R71C104KA88D (http://search.murata.co.jp/Ceramy/PnsearchViewAction.do) Series= X7R | Cap= 100.0 nF ESR= 1.0 mOhm VDC= 16.0 V IRMS= 0.0 A
1 | $0.01
| | | | | 0402 3 mm²
Cin | MuRata | GRM31CR71C106KAC7L (http://psearch.en.murata.com/capacitor/result/smd/?status%3Dall%26pid%3DGRM31CR71C106KAC7L) Series= X7R

Cap= 10.0 uF
ESR= 4.156 mOhm
VDC= 16.0 V
IRMS= 2.59073 A

3 $0.35
1206_190 11 mm²
Cout | MuRata | GRM31CR61A476KE15L (http://psearch.en.murata.com/capacitor/result/smd/?status%3Dall%26pid%3DGRM31CR61A476KE15L) Series= X5R

Cap= 47.0 uF
ESR= 3.709 mOhm
VDC= 10.0 V
IRMS= 4.2862 A

1 $0.26
1206_190 11 mm²
Coutx | TDK | C1608X5R1A106K080AC (https://product.tdk.com/en/search/capacitor/ceramic/mlcc/info?part%5Fno%3DC1608X5R1A106K080AC) Series= X5R

Cap= 10.0 uF
ESR= 4.639 mOhm
VDC= 10.0 V
IRMS= 2.4141 A

1 $0.11
0603 5 mm²
L1 | Bourns | SDR0805-1R5ML (http://www.bourns.com/data/global/pdfs/SDR0805.pdf) | L= 1.5 µH 20.0 mOhm
1 | $0.27

SDR0805 96 mm²
Renable | Yageo | RC0201FR-0710KL (http://www.yageo.com/exep/pages/download/literatures/PYu%2DR%5FMarking%5F2.pdf) Series= ? | Res= 10.0 kOhm Power= 50.0 mW Tolerance= 1.0% | 1 | $0.01
0201 2 mm²
Rfbb | Vishay-Dale | CRCW0603100KFKEA (http://www.vishay.com/docs/20035/dcrcwe3.pdf) Series= CRCW..e3 | Res= 100.0 kOhm Power= 100.0 mW Tolerance= 1.0% | 1 | $0.01
0603 5 mm²
Rfbt | Yageo | RC0603FR-07523KL (http://www.yageo.com/documents/recent/PYu%2DRC0603%5F51%5FRoHS%5FL%5F7.pdf) Series= ? | Res= 523.0 kOhm Power= 100.0 mW Tolerance= 1.0% | 1 | $0.01
0603 5 mm²
Rpgood | Vishay-Dale | CRCW0603100KFKEA (http://www.vishay.com/docs/20035/dcrcwe3.pdf) Series= CRCW..e3 | Res= 100.0 kOhm Power= 100.0 mW Tolerance= 1.0% | 1 | $0.01
0603 5 mm²
U1 | Texas Instruments | TPS63070RNMR (http://www.ti.com/product/TPS63070) | Switcher | 1 | $1.01

RNM0015A 14 mm²

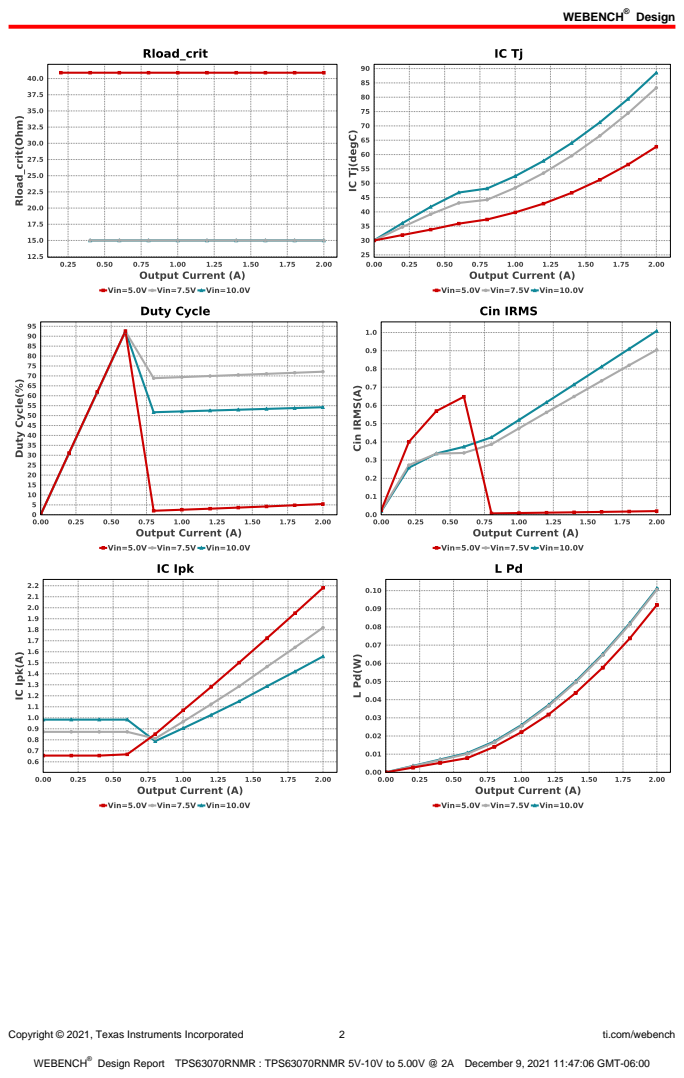
[picture p24: page 2]
Design; Copyright © 2021, Texas Instruments Incorporated; ti.com/webench

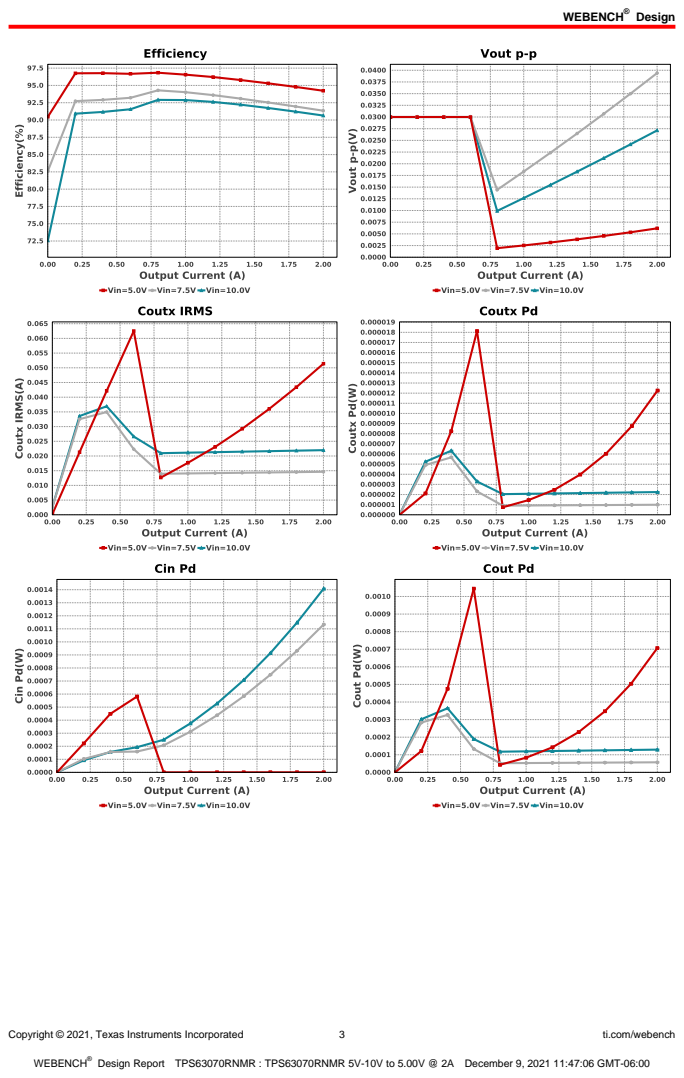
[picture p25: page 3]
Copyright © 2021, Texas Instruments Incorporated; ti.com/webench

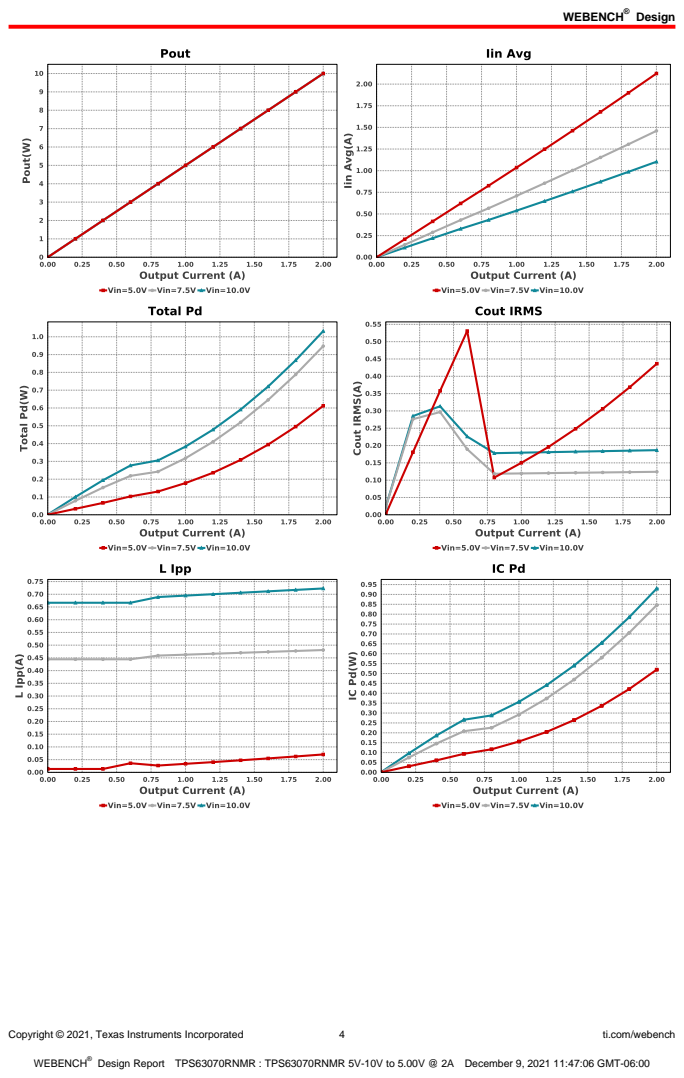
[picture p26: page 4]
Copyright © 2021, Texas Instruments Incorporated; ti.com/webench

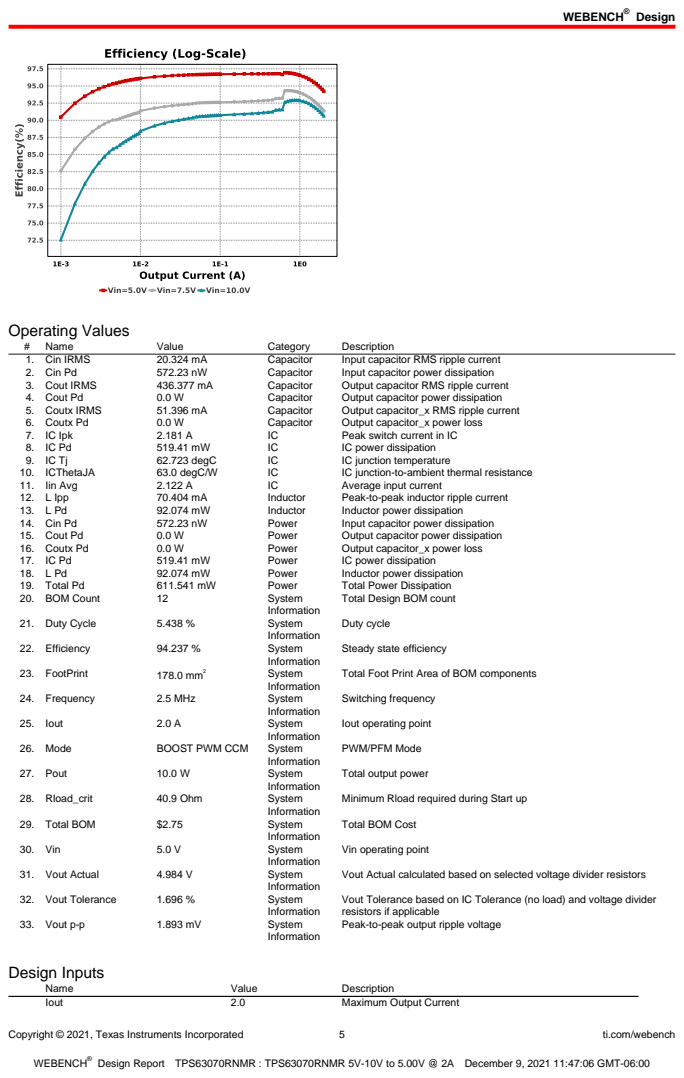
[picture p27: page 5]
Copyright © 2021, Texas Instruments Incorporated; ti.com/webench; Operating Values; Name; Value; Category; Description; 1. Cin IRMS; Capacitor; Input capacitor RMS ripple current; 2. Cin Pd; Input capacitor power dissipation; 3. Cout IRMS; Output capacitor RMS ripple current; 4. Cout Pd; Output capacitor power dissipation; 5. Coutx IRMS; Output capacitor_x RMS ripple current; 6. Coutx Pd; Output capacitor_x power loss; 7. IC Ipk; Peak switch current in IC; IC power dissipation; 62.723 degC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

Total Design BOM count

Steady state efficiency

Total Foot Print Area of BOM components

Iout operating point

PWM/PFM Mode

Total output power

Minimum Rload required during Start up

Total BOM Cost

Vin operating point

Vout Actual calculated based on selected voltage divider resistors

Vout Tolerance based on IC Tolerance (no load) and voltage divider
resistors if applicable
Peak-to-peak output ripple voltage

Copyright © 2021, Texas Instruments Incorporated | 6 | ti.com/webench
Name | Value | Description
VinMax | 10.0 | Maximum input voltage
VinMin | 5.0 | Minimum input voltage
Vout | 5.0 | Output Voltage
base_pn | TPS63070 | Base Product Number
source | DC | Input Source Type
Ta | 30.0 | Ambient temperature


Copyright © 2021, Texas Instruments Incorporated | 7 | ti.com/webench

## Assembly

## Component Testing

Some published data on components in datasheets such as Capacitor ESR and Inductor DC resistance is based on conservative values that will guarantee that the components always exceed the specification. For design purposes it is usually better to work with typical values. Since this data is not always available it is a good practice to measure the Capacitance and ESR values of Cin and Cout, and the inductance and DC resistance of L1 before assembly of the board. Any large discrepancies in values should be electrically simulated in WEBENCH to check for instabilities and thermally simulated in WebTHERM to make sure critical temperatures are not exceeded.

## Soldering Component to Board

If board assembly is done in house it is best to tack down one terminal of a component on the board then solder the other terminal. For surface mount parts with large tabs, such as the DPAK, the tab on the back of the package should be pre-tinned with solder, then tacked into place by one of the pins. To solder the tab town to the board place the iron down on the board while resting against the tab, heating both surfaces simultaneously. Apply light pressure to the top of the plastic case until the solder flows around the part and the part is flush with the PCB. If the solder is not flowing around the board you may need a higher wattage iron (generally 25W to 30W is enough).

## Initial Startup of Circuit

It is best to initially power up the board by setting the input supply voltage to the lowest operating input voltage 5.0V and set the input supply's current limit to zero. With the input supply off connect up the input supply to Vin and GND. Connect a digital volt meter and a load if needed to set the minimum Iout of the design from Vout and GND. Turn on the input supply and slowly turn up the current limit on the input supply. If the voltage starts to rise on the input supply continue increasing the input supply current limit while watching the output voltage. If the current increases on the input supply, but the voltage remains near zero, then there may be a short or a component misplaced on the board. Power down the board and visually inspect for solder bridges and recheck the diode and capacitor polarities. Once the power supply circuit is operational then more extensive testing may include full load testing, transient load and line tests to compare with simulation results.

## Load Testing

The setup is the same as the initial startup, except that an additional digital voltmeter is connected between Vin and GND, a load is connected between Vout and GND and a current meter is connected in series between Vout and the load. The load must be able to handle at least rated output power + 50% ( 7.5 watts for this design). Ideally the load is supplied in the form of a variable load test unit. It can also be done in the form of suitably large power resistors. When using an oscilloscope to measure waveforms on the prototype board, the ground leads of the oscilloscope probes should be as short as possible and the area of the loop formed by the ground lead should be kept to a minimum. This will help reduce ground lead inductance and eliminate EMI noise that is not actually present in the circuit.

## Design Assistance

1. Master key : 060754C25E2895A9[v1]
2. TPS63070 Product Folder : http://www.ti.com/product/TPS63070 : contains the data sheet and other resources.

Copyright © 2021, Texas Instruments Incorporated | 8 | ti.com/webench

Important Notice and Disclaimer

TI provides technical and reliability data (including datasheets), design resources (including reference designs), application or other design advice, web tools, safety information, and other resources AS IS and with all faults, and disclaims all warranties. These resources are intended for skilled developers designing with TI products. You are solely responsible for (1) selecting the appropriate TI products for your application, (2) designing, validating and testing your application, and (3) ensuring your application meets applicable standards, and any other safety, security, or other requirements.

These resources are subject to change without notice. TI grants you permission to use these resources only for development of an application that uses the TI products described in the resource. Other reproduction and display of these resources is prohibited. No license is granted to any other TI intellectual property right or to any third party intellectual property right. TI disclaims responsibility for, and you will fully indemnify TI and its representatives against, any claims, damages, costs, losses, and liabilities arising out of your use of these resources.

Providing these resources does not expand or otherwise alter TI's applicable Terms of Sale or other applicable terms available either on ti.com or provided in conjunction with TI products.
