erichtang/mainboard/hardware/foras-promineo-revB-em/pdf/mainboard-brd.pdf

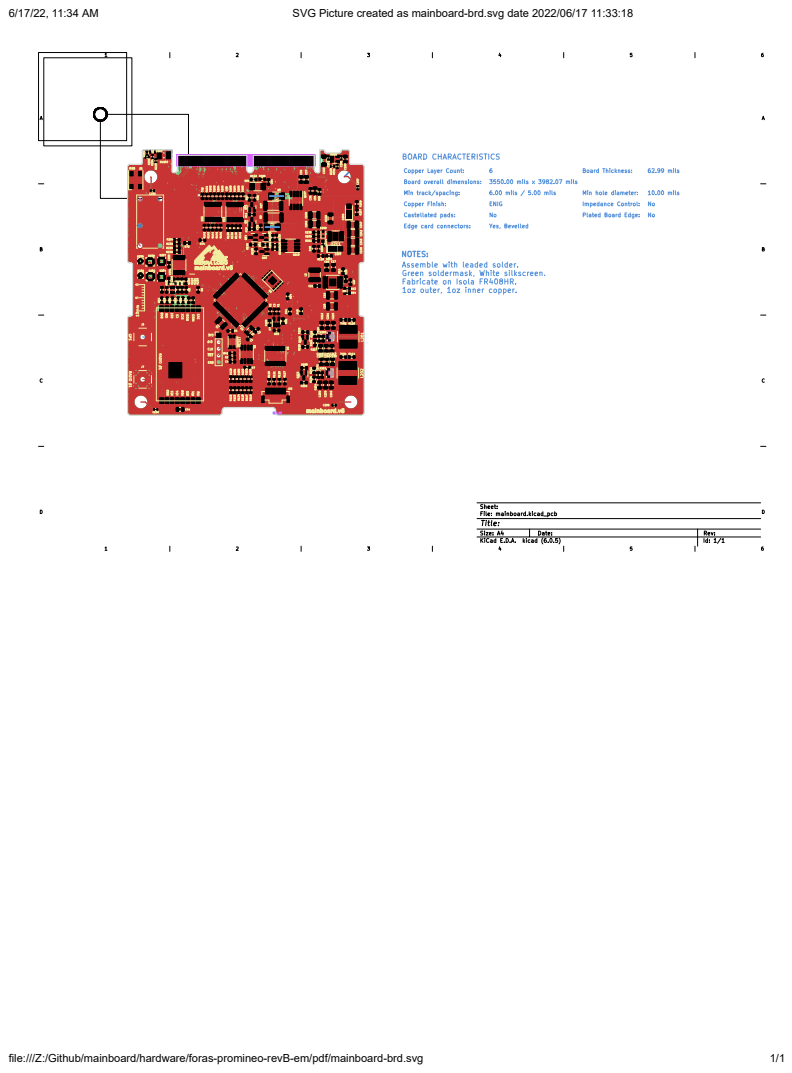
[picture p29: page 1]
SVG Picture created as mainboard-brd.svg date 2022/06/17 11:33:18; file:///Z:/Github/mainboard/hardware/foras-promineo-revB-em/pdf/mainboard-brd.svg
