erichtang/mainboard/hardware/design/inhibit_sim/inhibits.asc

C1: cap; 100µF
M1: nmos; IRFH3702
M2: pmos; IRF7404
M3: pmos; IRF7404
M4: pmos; IRF7404
M5: pmos; IRF7404
M6: pmos; IRF7404
M7: nmos; IRFH3702
Q1: pnp; 2N3906
Q2: pnp; 2N3906
Q3: npn; 2N3904
Q4: pnp; 2N3906
Q5: npn; 2N3904
Q6: npn; 2N3904
R1: res; 100
R2: res; 1Meg
R3: res; 1Meg
R4: res; 1Meg
R5: res; 100k
R6: res; 1Meg
R7: res; 100k
R8: res; {sep1_R}
R9: res; {sep23_R}
R10: res; {sep23_R}
R11: res; {RBF_R}
R12: res; 10k
R13: res; 10k
R14: res; 10k
R15: res; 10k
R16: res; 1Meg
R17: res; 1Meg
R18: res; 100k
R19: res; 100k
R20: res; 10k
R21: res; 50
R22: res; .1
R23: res; 10k
V1: voltage; 5V
V2: voltage; 8.2V
V3: voltage; 7.2V
Named nets: 0, vbus_inhibit, sep2, sep3, vbus_ret, RBF, sep1, vbus, 5vusb, vchrg, vbus_usb, vchrg_usb
Not IRF7458exact but this is really just a sim for PMOS preformance
vbus_ret is GND in the kicad sch
this is GNDREF in the kicad sch
low = on
low = on
highZ = on
low = on
.param sep1_R=1 sep23_R=1 RBF_R=1
.tran .1s uic
