erichtang/mainboard/hardware/foras-promineo-revB-em/5V_regulator.kicad_sch

## KiCad design hardware/foras-promineo-revB-em/5V_regulator.kicad_sch (2022-06-21)

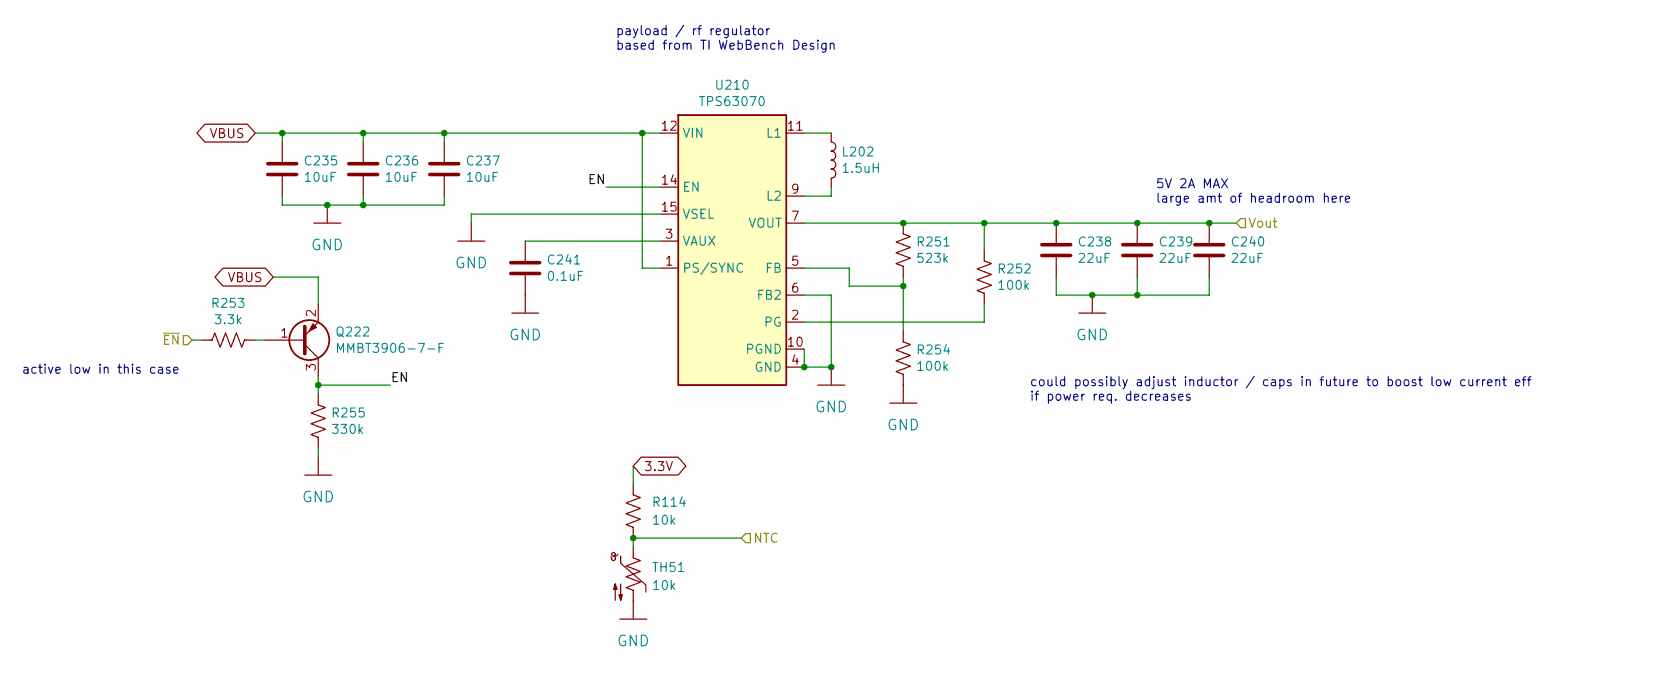
[picture p30: schematic 5V_regulator.kicad_sch]

Parts:
C235, C236, C237: 10uF; C_0805_2012Metric
C238, C239, C240: 22uF; C_0805_2012Metric
C241: 0.1uF; C_0603_1608Metric
L202: 1.5uH; L_Bourns_SRN8040TA
Q222: MMBT3906-7-F; SOT-23
R114: 10k; R_0603_1608Metric
R251: 523k; R_0603_1608Metric
R252, R254: 100k; R_0603_1608Metric
R253: 3.3k; R_0603_1608Metric
R255: 330k; R_0603_1608Metric
TH51: 10k; R_0603_1608Metric
U210: TPS63070; TPS63070RNMR

Connections:
3.3V: R114.1
EN: Q222.3 (C), R255.1, U210.14 (EN)
GND: C235.2, C236.2, C237.2, C238.2, C239.2, C240.2, C241.1, R254.2, R255.2, TH51.2, U210.4 (GND), U210.6 (FB2), U210.10 (PGND), U210.15 (VSEL)
NTC: R114.2, TH51.1
unnamed: C241.2, U210.3 (VAUX)
unnamed: L202.1, U210.11 (L1)
unnamed: L202.2, U210.9 (L2)
unnamed: Q222.1 (B), R253.1
unnamed: R251.2, R254.1, U210.5 (FB)
unnamed: R252.2, U210.2 (PG)
VBUS: C235.1, C236.1, C237.1, Q222.2 (E), U210.1 (PS/SYNC), U210.12 (VIN)
Vout: C238.1, C239.1, C240.1, R251.1, R252.1, U210.7 (VOUT)
~EN: R253.2

Notes on the sheet:
active low in this case
payload / rf regulator based from TI WebBench Design
5V 2A MAX large amt of headroom here
could possibly adjust inductor / caps in future to boost low current eff if power req. decreases
