erichtang/mainboard/hardware/foras-promineo-revB-em/Avionics.kicad_sch

## KiCad design hardware/foras-promineo-revB-em/Avionics.kicad_sch (2022-06-21)

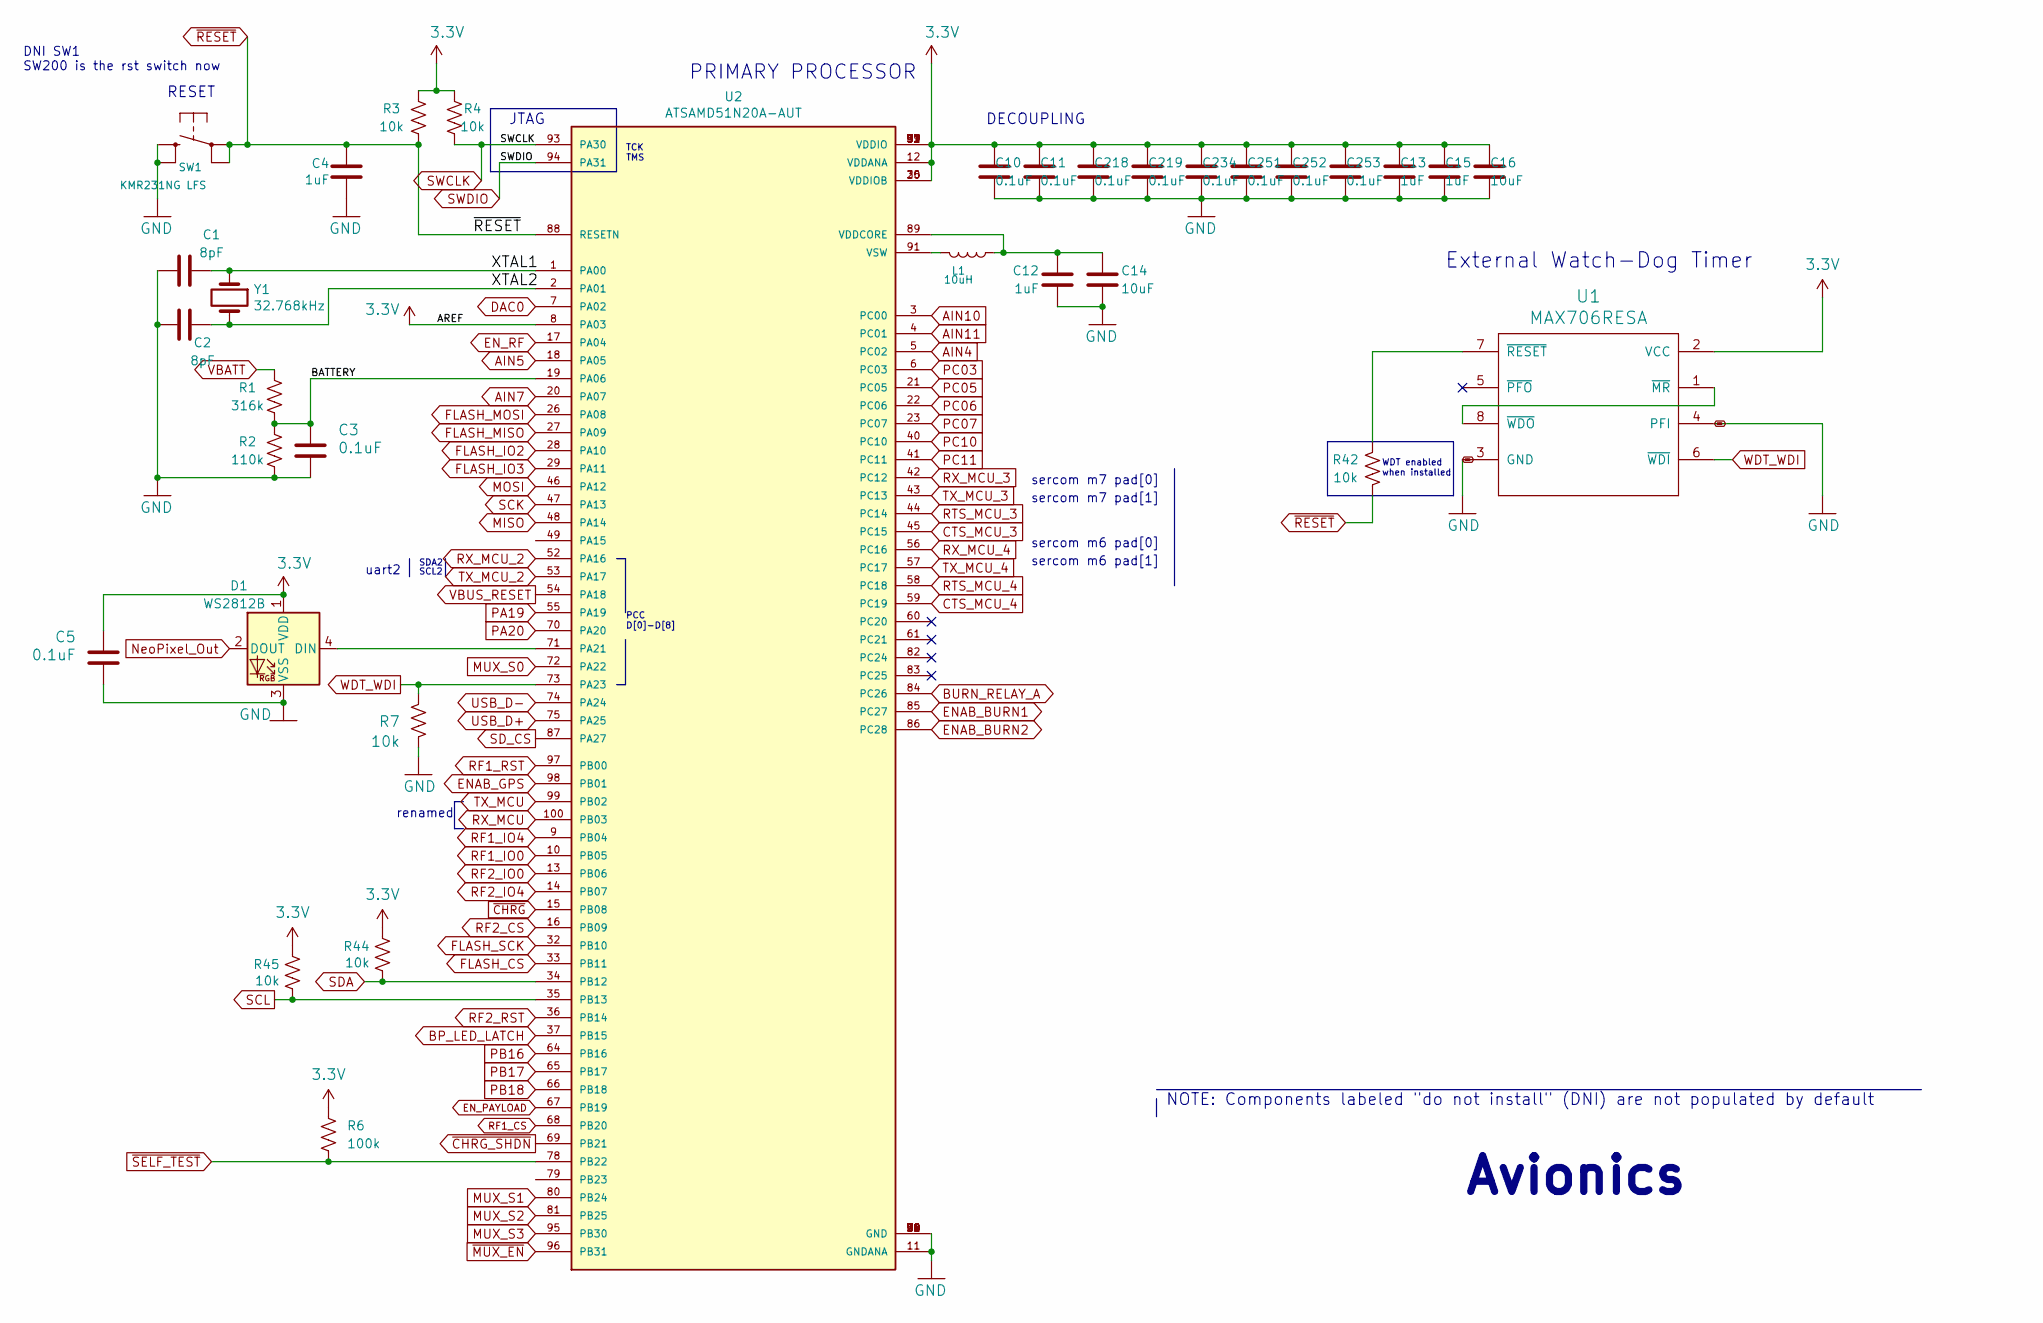
[picture p31: schematic Avionics.kicad_sch]

Parts:
C1, C2: 8pF; C_0603_1608Metric
C3, C5, C10, C11, C218, C219, C234, C251, C252, C253: 0.1uF; C_0603_1608Metric
C4, C12, C13, C15: 1uF; C_0603_1608Metric
C14, C16: 10uF; C_0805_2012Metric
D1: WS2812B; LED_WS2812B_PLCC4_5.0x5.0mm_P3.2mm; Manufacturer_Part_Number WS2812B-B
L1: 10uH; L_1210_3225Metric
R1: 316k; R_0603_1608Metric
R2: 110k; R_0603_1608Metric
R3, R4, R7, R42, R44, R45: 10k; R_0603_1608Metric
R6: 100k; R_0603_1608Metric
SW1: KMR231NG LFS; BTN_KMR2_4.6X2.8; Manufacturer_Part_Number KMR231NG LFS
U1: MAX706RESA; SO-8_3.9x4.9mm_P1.27mm; Manufacturer_Part_Number MAX706RESA
U2: ATSAMD51N20A-AUT; TQFP-100_14x14mm_P0.5mm
Y1: 32.768kHz; Crystal_SMD_3215-2Pin_3.2x1.5mm; Manufacturer_Part_Number SC-32S32.768kHz20PPM7pF

Connections:
3.3V: C5.1, C10.1, C11.1, C13.1, C15.1, C16.1, C218.1, C219.1, C234.1, C251.1, C252.1, C253.1, D1.1 (VDD), R3.1, R4.1, R6.1, R44.1, R45.1, U1.2 (VCC), U2.8 (PA03), U2.12 (VDDANA), U2.25 (VDDIOB), U2.30 (VDDIOB), U2.39 (VDDIO), U2.51 (VDDIO), U2.63 (VDDIO), U2.77 (VDDIO), U2.92 (VDDIO)
AIN4: U2.5 (PC02)
AIN5: U2.18 (PA05)
AIN7: U2.20 (PA07)
AIN10: U2.3 (PC00)
AIN11: U2.4 (PC01)
BATTERY: C3.1, R1.2, R2.2, U2.19 (PA06)
BP_LED_LATCH: U2.37 (PB15)
BURN_RELAY_A: U2.84 (PC26)
CTS_MCU_3: U2.45 (PC15)
CTS_MCU_4: U2.59 (PC19)
DAC0: U2.7 (PA02)
ENAB_BURN1: U2.85 (PC27)
ENAB_BURN2: U2.86 (PC28)
ENAB_GPS: U2.98 (PB01)
EN_PAYLOAD: U2.67 (PB19)
EN_RF: U2.17 (PA04)
FLASH_CS: U2.33 (PB11)
FLASH_IO2: U2.28 (PA10)
FLASH_IO3: U2.29 (PA11)
FLASH_MISO: U2.27 (PA09)
FLASH_MOSI: U2.26 (PA08)
FLASH_SCK: U2.32 (PB10)
GND: C1.2, C2.2, C3.2, C4.1, C5.2, C10.2, C11.2, C12.1, C13.2, C14.2, C15.2, C16.2, C218.2, C219.2, C234.2, C251.2, C252.2, C253.2, D1.3 (VSS), R2.1, R7.2, SW1.B (S), SW1.B' (S1), U1.3 (GND), U1.4 (PFI), U2.11 (GNDANA), U2.24 (GND), U2.31 (GND), U2.38 (GND), U2.50 (GND), U2.62 (GND), U2.76 (GND), U2.90 (GND)
MISO: U2.48 (PA14)
MOSI: U2.46 (PA12)
MUX_S0: U2.72 (PA22)
MUX_S1: U2.80 (PB24)
MUX_S2: U2.81 (PB25)
MUX_S3: U2.95 (PB30)
NeoPixel_Out: D1.2 (DOUT)
unnamed: C12.2, C14.1, L1.2, U2.89 (VDDCORE)
unnamed: D1.4 (DIN), U2.71 (PA21)
unnamed: L1.1, U2.91 (VSW)
unnamed: R42.2, U1.7 (~RESET)
unnamed: U1.1 (~MR), U1.8 (~WDO)
PA19: U2.55 (PA19)
PA20: U2.70 (PA20)
PB16: U2.64 (PB16)
PB17: U2.65 (PB17)
PB18: U2.66 (PB18)
PC03: U2.6 (PC03)
PC05: U2.21 (PC05)
PC06: U2.22 (PC06)
PC07: U2.23 (PC07)
PC10: U2.40 (PC10)
PC11: U2.41 (PC11)
RF1_CS: U2.68 (PB20)
RF1_IO0: U2.10 (PB05)
RF1_IO4: U2.9 (PB04)
RF1_RST: U2.97 (PB00)
RF2_CS: U2.16 (PB09)
RF2_IO0: U2.13 (PB06)
RF2_IO4: U2.14 (PB07)
RF2_RST: U2.36 (PB14)
RTS_MCU_3: U2.44 (PC14)
RTS_MCU_4: U2.58 (PC18)
RX_MCU: U2.100 (PB03)
RX_MCU_2: U2.52 (PA16)
RX_MCU_3: U2.42 (PC12)
RX_MCU_4: U2.56 (PC16)
SCK: U2.47 (PA13)
SCL: R45.2, U2.35 (PB13)
SDA: R44.2, U2.34 (PB12)
SD_CS: U2.87 (PA27)
SWCLK: R4.2, U2.93 (PA30)
SWDIO: U2.94 (PA31)
TX_MCU: U2.99 (PB02)
TX_MCU_2: U2.53 (PA17)
TX_MCU_3: U2.43 (PC13)
TX_MCU_4: U2.57 (PC17)
USB_D+: U2.75 (PA25)
USB_D-: U2.74 (PA24)
VBATT: R1.1
VBUS_RESET: U2.54 (PA18)
WDT_WDI: R7.1, U1.6 (~WDI), U2.73 (PA23)
XTAL1: C1.1, U2.1 (PA00), Y1.1
XTAL2: C2.1, U2.2 (PA01), Y1.2
~CHRG_SHDN: U2.69 (PB21)
~CHRG: U2.15 (PB08)
~MUX_EN: U2.96 (PB31)
~RESET: C4.2, R3.2, R42.1, SW1.A, SW1.A' (P1), U2.88 (RESETN)
~SELF_TEST: R6.2, U2.78 (PB22)

Notes on the sheet:
sercom m7 pad[1]
uart2
SDA2
DNI SW1 SW200 is the rst switch now
sercom m6 pad[0]
TCK TMS
NOTE: Components labeled "do not install" (DNI) are not populated by default
SCL2
DECOUPLING
renamed
Avionics
WDT enabled when installed
JTAG
External Watch-Dog Timer
PRIMARY PROCESSOR
sercom m7 pad[0]
RESET
sercom m6 pad[1]
PCC D[0]-D[8]
