erichtang/mainboard/hardware/foras-promineo-revB-em/Blank-Card-Default.kicad_sch

## KiCad design hardware/foras-promineo-revB-em/Blank-Card-Default.kicad_sch (2022-06-06)

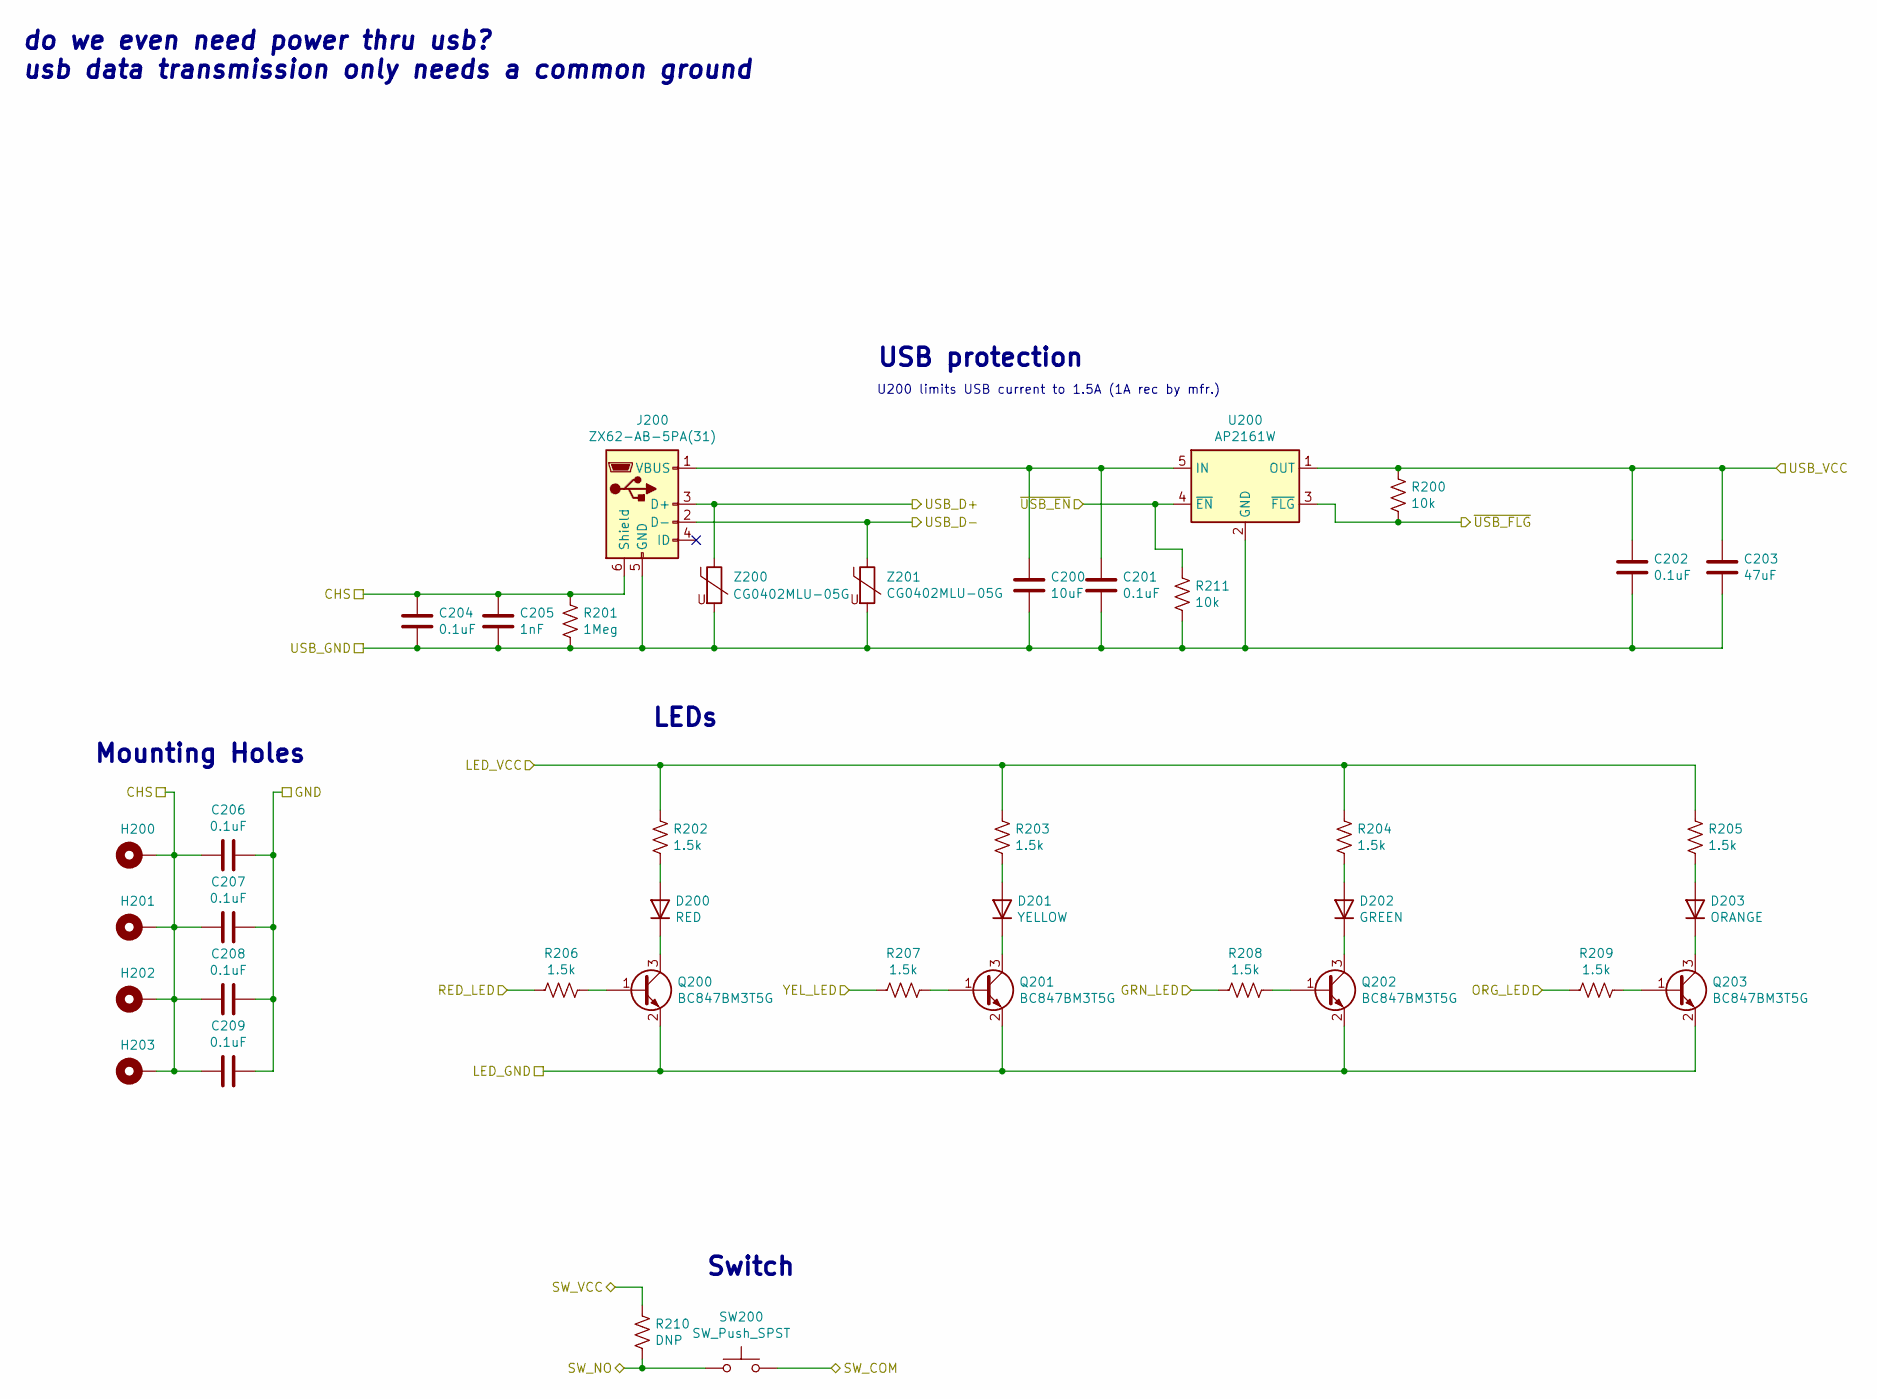
[picture p32: schematic Blank-Card-Default.kicad_sch]

Parts:
C200: 10uF; C_0805_2012Metric
C201, C202, C204, C206, C207, C208, C209: 0.1uF; C_0402_1005Metric
C203: 47uF; C_1206_3216Metric
C205: 1nF; C_0402_1005Metric
D200: RED; APA2107x
D201: YELLOW; APA2107x
D202: GREEN; APA2107x
D203: ORANGE; APA2107x
H200: MountingHole_Pad; 125mil_hole
H201, H202, H203: SLI-Backplane-Blank-Card-KiCad:125mil_hole; 125mil_hole
J200: ZX62-AB-5PA(31)
Q200, Q201, Q202, Q203: BC847BM3T5G; SOT-723
R200, R211: 10k; R_0402_1005Metric
R201: 1Meg; R_0402_1005Metric
R202, R203, R204, R205, R206, R207, R208, R209: 1.5k; R_0402_1005Metric
R210: DNP; R_0402_1005Metric
SW200: SW_Push_SPST; EVQP7C01P
U200: AP2161W; SOT-23-5
Z200, Z201: CG0402MLU-05G; C_0402_1005Metric

Connections:
CHS: C204.1, C205.1, C206.2, C207.2, C208.2, C209.2, H200.1, H201.1, H202.1, H203.1, J200.6 (Shield), R201.1
GND: C206.1, C207.1, C208.1, C209.1
GRN_LED: R208.2
LED_GND: Q200.2 (E), Q201.2 (E), Q202.2 (E), Q203.2 (E)
LED_VCC: R202.1, R203.1, R204.1, R205.1
unnamed: C200.1, C201.1, J200.1 (VBUS), U200.5 (IN)
unnamed: D200.1 (K), Q200.3 (C)
unnamed: D200.2 (A), R202.2
unnamed: D201.1 (K), Q201.3 (C)
unnamed: D201.2 (A), R203.2
unnamed: D202.1 (K), Q202.3 (C)
unnamed: D202.2 (A), R204.2
unnamed: D203.1 (K), Q203.3 (C)
unnamed: D203.2 (A), R205.2
unnamed: Q200.1 (B), R206.1
unnamed: Q201.1 (B), R207.1
unnamed: Q202.1 (B), R208.1
unnamed: Q203.1 (B), R209.1
ORG_LED: R209.2
RED_LED: R206.2
SW_COM: SW200.2
SW_NO: R210.2, SW200.1
SW_VCC: R210.1
USB_D+: J200.3 (D+), Z200.1
USB_D-: J200.2 (D-), Z201.1
USB_GND: C200.2, C201.2, C202.2, C203.2, C204.2, C205.2, J200.5 (GND), R201.2, R211.2, U200.2 (GND), Z200.2, Z201.2
USB_VCC: C202.1, C203.1, R200.1, U200.1 (OUT)
YEL_LED: R207.2
~USB_EN: R211.1, U200.4 (~EN)
~USB_FLG: R200.2, U200.3 (~FLG)

Notes on the sheet:
do we even need power thru usb? usb data transmission only needs a common ground
LEDs
Switch
Mounting Holes
U200 limits USB current to 1.5A (1A rec by mfr.)
USB protection
