erichtang/mainboard/hardware/foras-promineo-revB-em/Burn_Wires.kicad_sch

## KiCad design hardware/foras-promineo-revB-em/Burn_Wires.kicad_sch (2022-06-06)

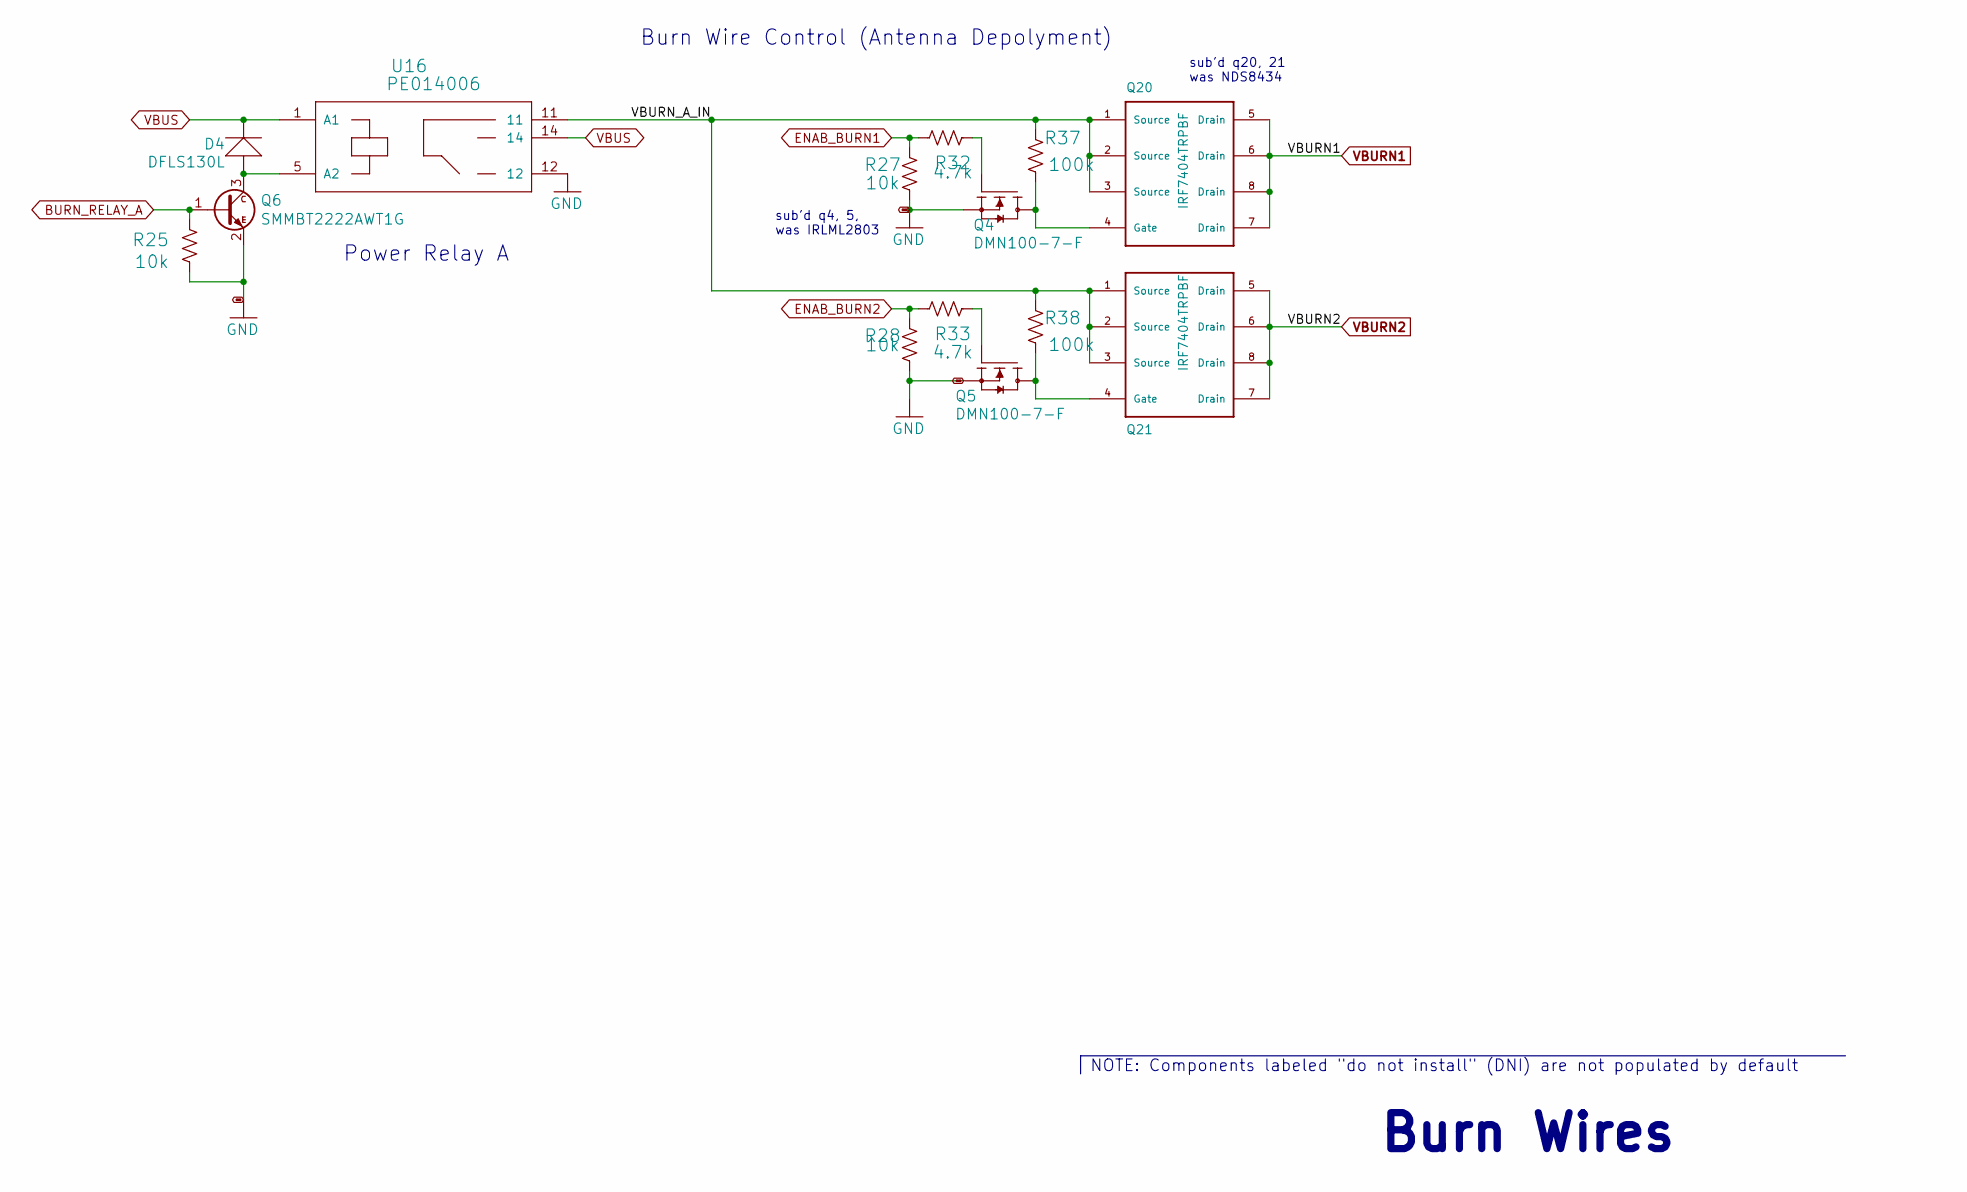
[picture p33: schematic Burn_Wires.kicad_sch]

Parts:
D4: DFLS130L; PWRDI-123; Manufacturer_Part_Number DFLS130L-7
Q4, Q5: DMN100-7-F; SOT-23
Q6: SMMBT2222AWT1G; SOT-323_SC-70
Q20, Q21: IRF7404TRPBF; SOIC-8_3.9x4.9mm_P1.27mm
R25, R27, R28: 10k; R_0603_1608Metric
R32, R33: 4.7k; R_0603_1608Metric
R37, R38: 100k; R_0603_1608Metric
U16: PE014006; RELAY_PE014006; Manufacturer_Part_Number PE014006 TE

Connections:
BURN_RELAY_A: Q6.1 (B), R25.1
ENAB_BURN1: R27.1, R32.2
ENAB_BURN2: R28.1, R33.2
GND: Q4.2 (S), Q5.2 (S), Q6.2 (E), R25.2, R27.2, R28.2, U16.12
unnamed: D4.A, Q6.3 (C), U16.5 (A2)
unnamed: Q4.1 (G), R32.1
unnamed: Q5.1 (G), R33.1
unnamed: Q4.3 (D), Q20.4 (Gate), R37.1
unnamed: Q5.3 (D), Q21.4 (Gate), R38.1
VBURN1: Q20.5 (Drain), Q20.6 (Drain), Q20.7 (Drain), Q20.8 (Drain)
VBURN2: Q21.5 (Drain), Q21.6 (Drain), Q21.7 (Drain), Q21.8 (Drain)
VBURN_A_IN: Q20.1 (Source), Q20.2 (Source), Q20.3 (Source), Q21.1 (Source), Q21.2 (Source), Q21.3 (Source), R37.2, R38.2, U16.11
VBUS: D4.C, U16.1 (A1), U16.14

Notes on the sheet:
Burn Wire Control (Antenna Depolyment)
sub'd q4, 5, was IRLML2803
sub'd q20, 21 was NDS8434
NOTE: Components labeled "do not install" (DNI) are not populated by default
Burn Wires
Power Relay A
