erichtang/mainboard/hardware/foras-promineo-revB-em/Bus_Protection.kicad_sch

## KiCad design hardware/foras-promineo-revB-em/Bus_Protection.kicad_sch (2022-06-24)

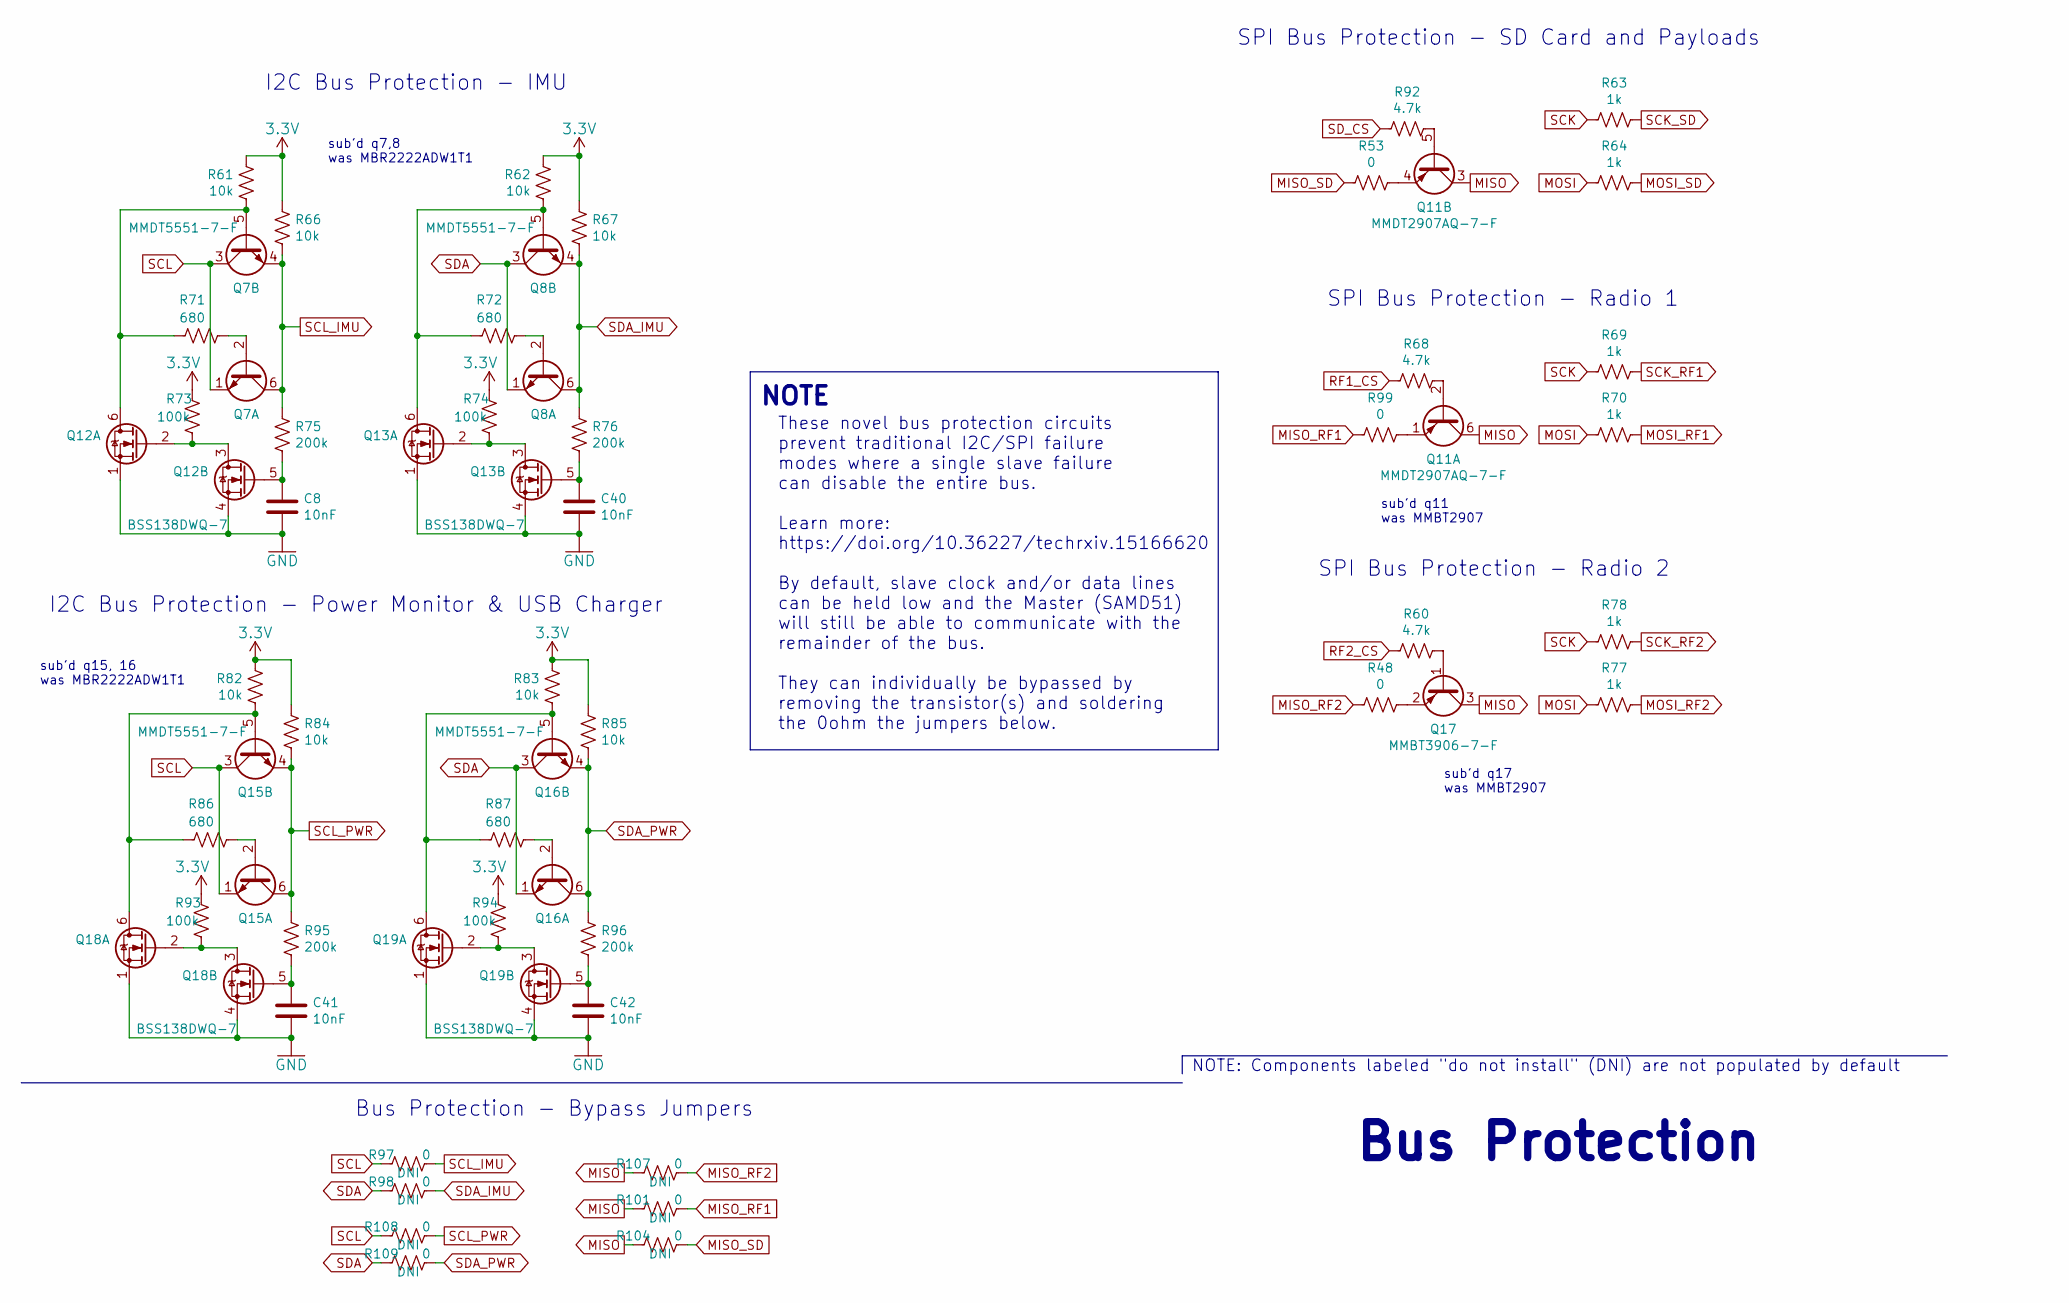
[picture p34: schematic Bus_Protection.kicad_sch]

Parts:
C8, C40, C41, C42: 10nF; C_0603_1608Metric
Q7, Q15, Q16: MMDT5551-7-F; SOT-363_SC-70-6
Q8: MMDT5551-7-F; SOT-363_SC-70-6; Manufacturer_Part_Number MBT2222ADW1T1G
Q11: MMDT2907AQ-7-F; SOT-363_SC-70-6; Manufacturer_Part_Number MMDT2907AQ-7-F
Q12, Q13, Q18, Q19: BSS138DWQ-7; Manufacturer_Part_Number BSS138DWQ-7
Q17: MMBT3906-7-F; SOT-23; Manufacturer_Part_Number MMBT2907ALT1G
R48, R53, R97, R98, R99, R101, R104, R107, R108, R109: 0; R_0603_1608Metric
R60, R68, R92: 4.7k; R_0603_1608Metric
R61, R62, R66, R67, R82, R83, R84, R85: 10k; R_0603_1608Metric
R63, R64, R69, R70, R77, R78: 1k; R_0603_1608Metric
R71, R72, R86, R87: 680; R_0603_1608Metric
R73, R74, R93, R94: 100k; R_0603_1608Metric
R75, R76, R95, R96: 200k; R_0603_1608Metric

Connections:
3.3V: R61.1, R62.1, R66.1, R67.1, R73.1, R74.1, R82.1, R83.1, R84.1, R85.1, R93.1, R94.1
GND: C8.2, C40.2, C41.2, C42.2, Q12.1 (S2), Q12.4 (S1), Q13.1 (S2), Q13.4 (S1), Q18.1 (S2), Q18.4 (S1), Q19.1 (S2), Q19.4 (S1)
MISO: Q11.3 (C2), Q11.6 (C1), Q17.3 (C), R101.2, R104.2, R107.2
MISO_RF1: R99.2, R101.1
MISO_RF2: R48.2, R107.1
MISO_SD: R53.2, R104.1
MOSI: R64.2, R70.1, R77.2
MOSI_RF1: R70.2
MOSI_RF2: R77.1
MOSI_SD: R64.1
unnamed: C8.1, Q12.5 (G1), R75.2
unnamed: C40.1, Q13.5 (G1), R76.2
unnamed: C41.1, Q18.5 (G1), R95.2
unnamed: C42.1, Q19.5 (G1), R96.2
unnamed: Q7.2 (B1), R71.1
unnamed: Q8.2 (B1), R72.1
unnamed: Q11.1 (E1), R99.1
unnamed: Q11.2 (B1), R68.1
unnamed: Q11.4 (E2), R53.1
unnamed: Q11.5 (B2), R92.1
unnamed: Q12.2 (G2), Q12.3 (D2), R73.2
unnamed: Q7.5 (B2), Q12.6 (D1), R61.2, R71.2
unnamed: Q13.2 (G2), Q13.3 (D2), R74.2
unnamed: Q8.5 (B2), Q13.6 (D1), R62.2, R72.2
unnamed: Q15.2 (B1), R86.1
unnamed: Q15.5 (B2), Q18.6 (D1), R82.2, R86.2
unnamed: Q16.2 (B1), R87.1
unnamed: Q16.5 (B2), Q19.6 (D1), R83.2, R87.2
unnamed: Q17.1 (B), R60.1
unnamed: Q17.2 (E), R48.1
unnamed: Q18.2 (G2), Q18.3 (D2), R93.2
unnamed: Q19.2 (G2), Q19.3 (D2), R94.2
RF1_CS: R68.2
RF2_CS: R60.2
SCK: R63.2, R69.2, R78.2
SCK_RF1: R69.1
SCK_RF2: R78.1
SCK_SD: R63.1
SCL: Q7.1 (E1), Q7.3 (C2), Q15.1 (E1), Q15.3 (C2), R97.2, R108.2
SCL_IMU: Q7.4 (E2), Q7.6 (C1), R66.2, R75.1, R97.1
SCL_PWR: Q15.4 (E2), Q15.6 (C1), R84.2, R95.1, R108.1
SDA: Q8.1 (E1), Q8.3 (C2), Q16.1 (E1), Q16.3 (C2), R98.2, R109.2
SDA_IMU: Q8.4 (E2), Q8.6 (C1), R67.2, R76.1, R98.1
SDA_PWR: Q16.4 (E2), Q16.6 (C1), R85.2, R96.1, R109.1
SD_CS: R92.2

Notes on the sheet:
sub'd q17 was MMBT2907
Bus Protection - Bypass Jumpers
SPI Bus Protection - SD Card and Payloads
sub'd q7,8 was MBR2222ADW1T1
SPI Bus Protection - Radio 2
These novel bus protection circuits prevent traditional I2C/SPI failure modes where a single slave failure can disable the entire bus. Learn more: https://doi.org/10.36227/techrxiv.15166620 By default, slave clock and/or data lines can be held low and the Master (SAMD51) will still be able to commu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
Bus Protection
NOTE
I2C Bus Protection - Power Monitor & USB Charger
SPI Bus Protection - Radio 1
NOTE: Components labeled "do not install" (DNI) are not populated by default
sub'd q15, 16 was MBR2222ADW1T1
sub'd q11 was MMBT2907
I2C Bus Protection - IMU
