erichtang/mainboard/hardware/foras-promineo-revB-em/Connectors.kicad_sch

## KiCad design hardware/foras-promineo-revB-em/Connectors.kicad_sch (2022-06-06)

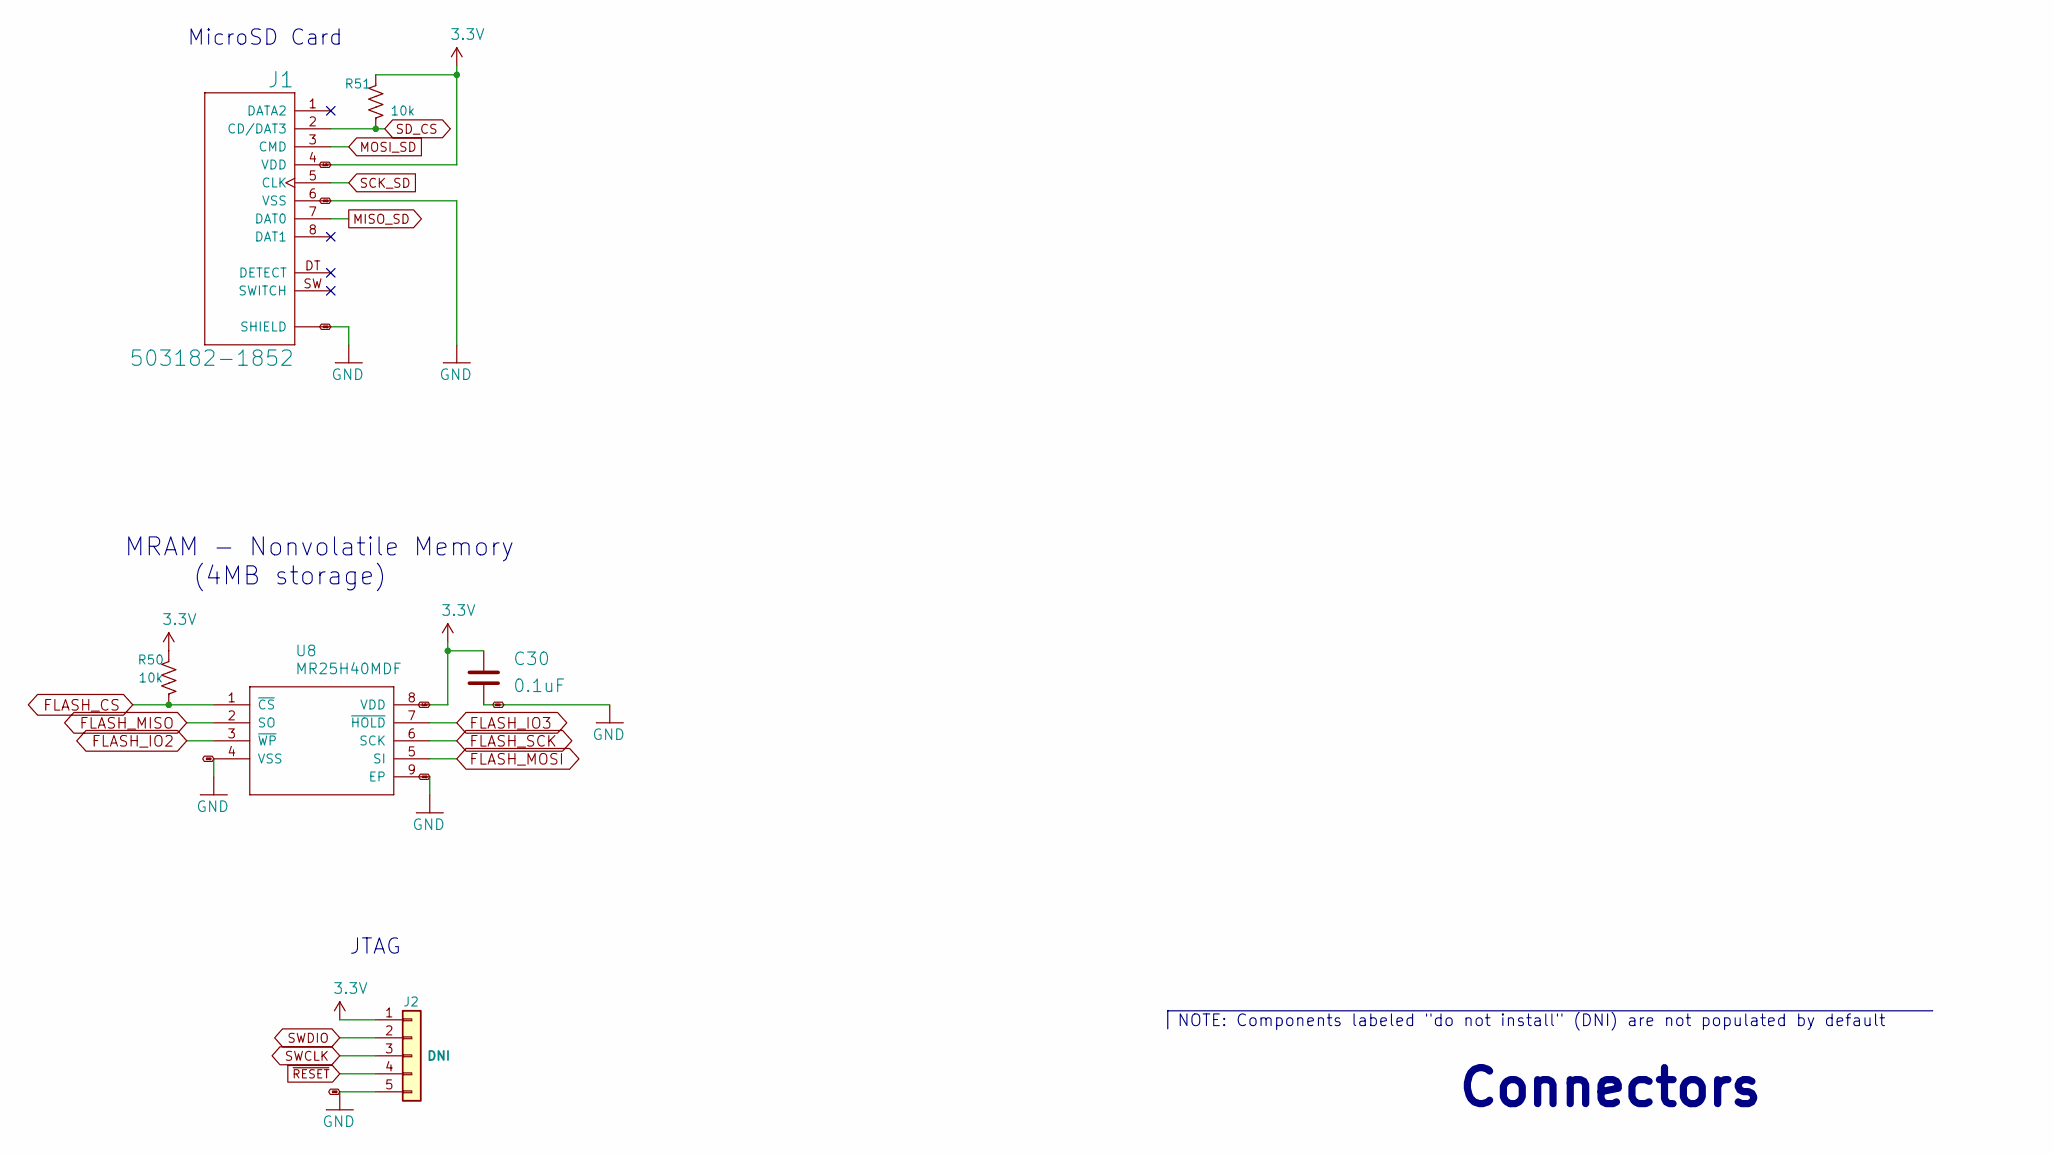
[picture p35: schematic Connectors.kicad_sch]

Parts:
C30: 0.1uF; C_0603_1608Metric
J1: 503182-1852; MOLEX_503182-1852; Manufacturer_Part_Number 5031821852
J2: Conn_01x05; PinHeader_1x05_P2.54mm_Vertical
R50, R51: 10k; R_0603_1608Metric
U8: MR25H40MDF; SON127P600X500X90-9N; Manufacturer_Part_Number W25Q80DVSNIG

Connections:
3.3V: C30.1, J1.4 (VDD), J2.1, R50.2, R51.2, U8.8 (VDD)
FLASH_CS: R50.1, U8.1 (~CS)
FLASH_IO2: U8.3 (~WP)
FLASH_IO3: U8.7 (~HOLD)
FLASH_MISO: U8.2 (SO)
FLASH_MOSI: U8.5 (SI)
FLASH_SCK: U8.6 (SCK)
GND: C30.2, J1.6 (VSS), J1.P1 (SHIELD), J1.P2 (SHIELD), J1.P3 (SHIELD), J1.P4 (SHIELD), J1.P5 (SHIELD), J2.5, U8.4 (VSS), U8.9 (EP)
MISO_SD: J1.7 (DAT0)
MOSI_SD: J1.3 (CMD)
SCK_SD: J1.5 (CLK)
SD_CS: J1.2 (CD/DAT3), R51.1
SWCLK: J2.3
SWDIO: J2.2
~RESET: J2.4

Notes on the sheet:
MicroSD Card
MRAM - Nonvolatile Memory (4MB storage)
NOTE: Components labeled "do not install" (DNI) are not populated by default
JTAG
Connectors
