erichtang/mainboard/hardware/foras-promineo-revB-em/IMU.kicad_sch

## KiCad design hardware/foras-promineo-revB-em/IMU.kicad_sch (2022-06-06)

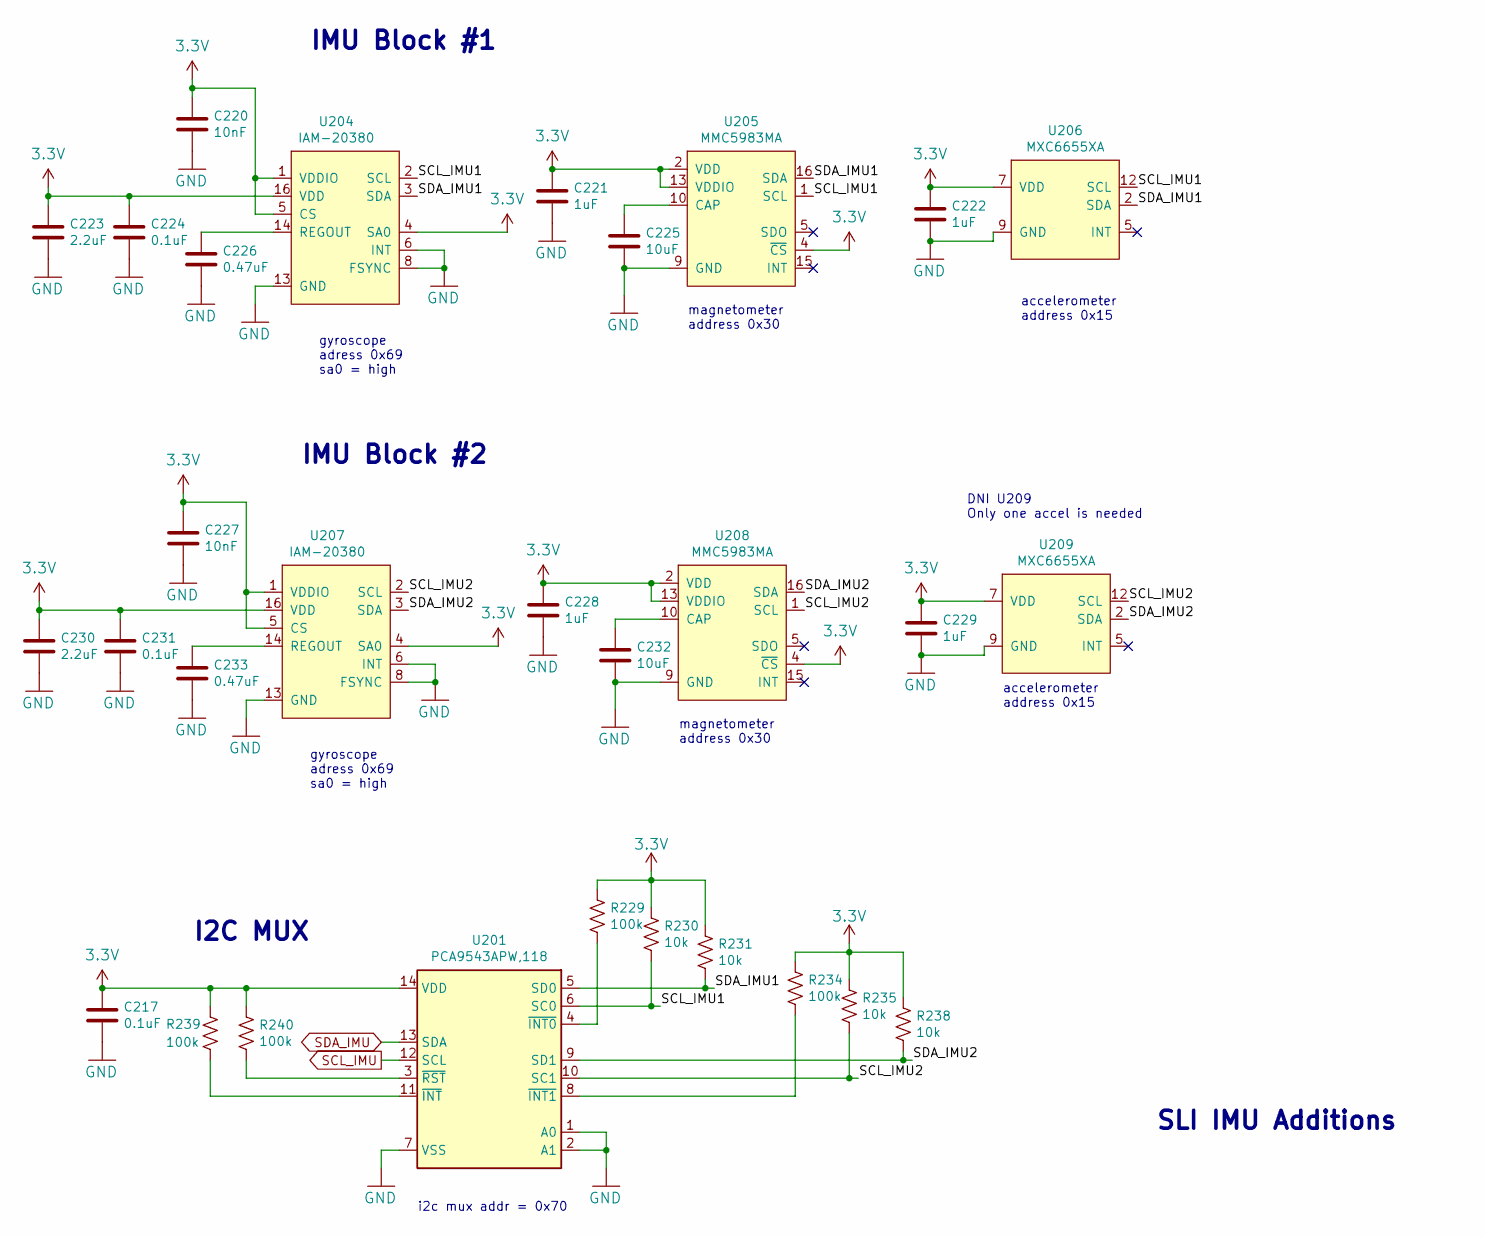
[picture p36: schematic IMU.kicad_sch]

Parts:
C217, C224, C231: 0.1uF; C_0603_1608Metric
C220, C227: 10nF; C_0603_1608Metric
C221, C222, C228, C229: 1uF; C_0603_1608Metric
C223, C230: 2.2uF; C_0603_1608Metric
C225, C232: 10uF; C_0805_2012Metric
C226, C233: 0.47uF; C_0603_1608Metric
R229, R234, R239, R240: 100k; R_0603_1608Metric
R230, R231, R235, R238: 10k; R_0603_1608Metric
U201: PCA9543APW,118; TSSOP-14_4.4x5mm_P0.65mm
U204, U207: IAM-20380
U205, U208: MMC5983MA
U206, U209: MXC6655XA

Connections:
3.3V: C217.1, C220.1, C221.1, C222.1, C223.1, C224.1, C227.1, C228.1, C229.1, C230.1, C231.1, R229.1, R230.1, R231.1, R234.1, R235.1, R238.1, R239.1, R240.1, U201.14 (VDD), U204.1 (VDDIO), U204.4 (SA0), U204.5 (CS), U204.16 (VDD), U205.2 (VDD), U205.4 (~CS), U205.13 (VDDIO), U206.7 (VDD), U207.1 (VDDIO), U207.4 (SA0), U207.5 (CS), U207.16 (VDD), U208.2 (VDD), U208.4 (~CS), U208.13 (VDDIO), U209.7 (VDD)
GND: C217.2, C220.2, C221.2, C222.2, C223.2, C224.2, C225.2, C226.2, C227.2, C228.2, C229.2, C230.2, C231.2, C232.2, C233.2, U201.1 (A0), U201.2 (A1), U201.7 (VSS), U204.6 (INT), U204.8 (FSYNC), U204.9 (RESV_GND), U204.10 (RESV_GND), U204.11 (RESV_GND), U204.12 (RESV_GND), U204.13 (GND), U204.15 (RESV_GND), U205.9 (GND), U205.11 (GND), U206.9 (GND), U207.6 (INT), U207.8 (FSYNC), U207.9 (RESV_GND), U207.10 (RESV_GND), U207.11 (RESV_GND), U207.12 (RESV_GND), U207.13 (GND), U207.15 (RESV_GND), U208.9 (GND), U208.11 (GND), U209.9 (GND)
unnamed: C225.1, U205.10 (CAP)
unnamed: C226.1, U204.14 (REGOUT)
unnamed: C232.1, U208.10 (CAP)
unnamed: C233.1, U207.14 (REGOUT)
unnamed: R229.2, U201.4 (~INT0)
unnamed: R234.2, U201.8 (~INT1)
unnamed: R239.2, U201.11 (~INT)
unnamed: R240.2, U201.3 (~RST)
SCL_IMU: U201.12 (SCL)
SCL_IMU1: R230.2, U201.6 (SC0), U204.2 (SCL), U205.1 (SCL), U206.12 (SCL)
SCL_IMU2: R235.2, U201.10 (SC1), U207.2 (SCL), U208.1 (SCL), U209.12 (SCL)
SDA_IMU: U201.13 (SDA)
SDA_IMU1: R231.2, U201.5 (SD0), U204.3 (SDA), U205.16 (SDA), U206.2 (SDA)
SDA_IMU2: R238.2, U201.9 (SD1), U207.3 (SDA), U208.16 (SDA), U209.2 (SDA)

Notes on the sheet:
i2c mux addr = 0x70
IMU Block #2
IMU Block #1
accelerometer address 0x15
magnetometer address 0x30
SLI IMU Additions
DNI U209 Only one accel is needed
gyroscope adress 0x69 sa0 = high
I2C MUX
