erichtang/mainboard/hardware/foras-promineo-revB-em/Power.kicad_sch

## KiCad design hardware/foras-promineo-revB-em/Power.kicad_sch (2022-06-21)

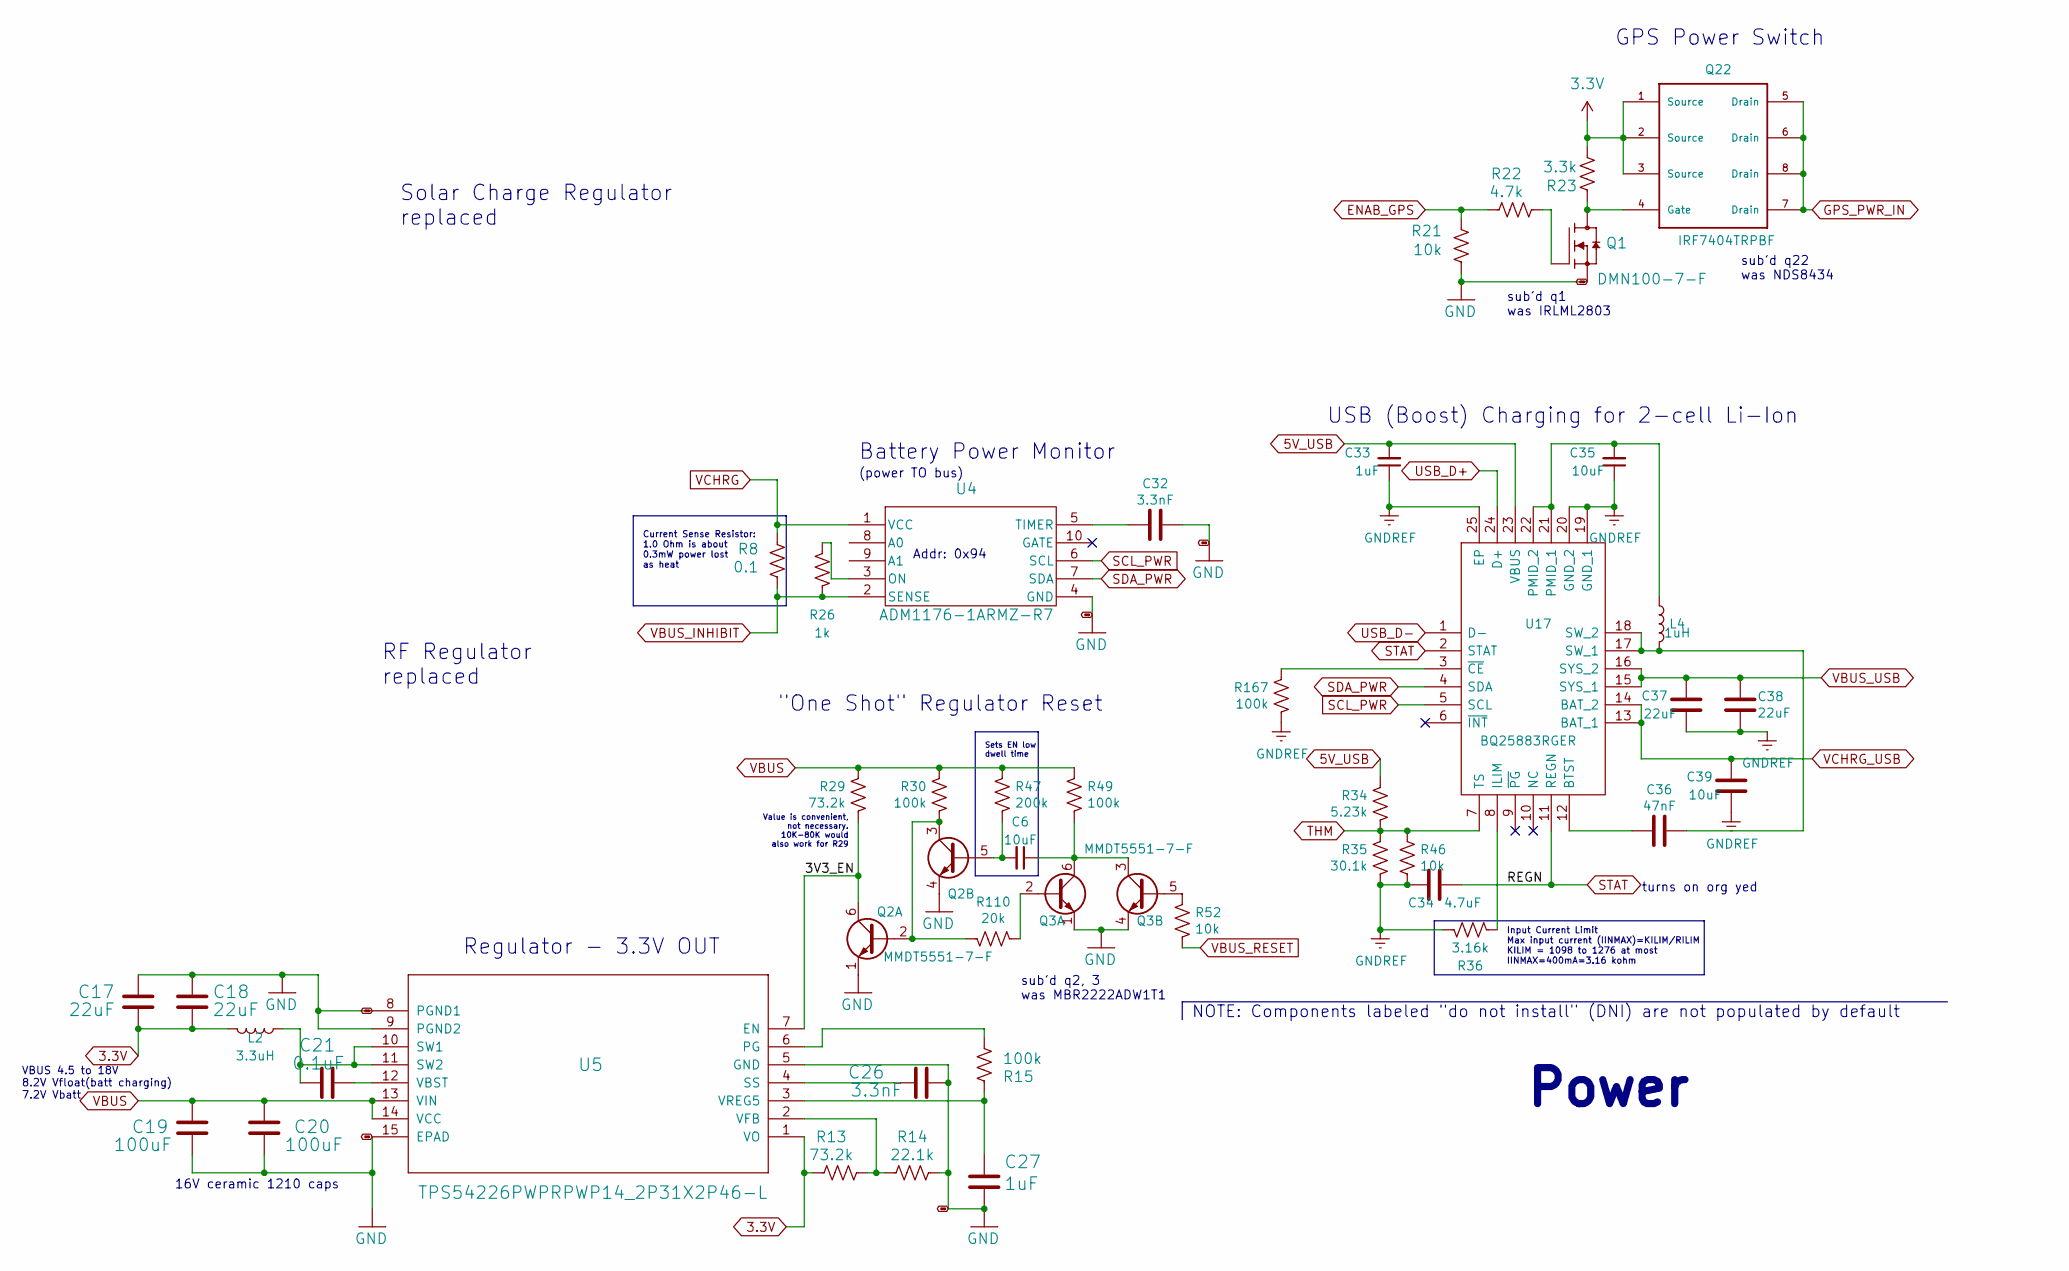
[picture p37: schematic Power.kicad_sch]

Parts:
C6, C35, C39: 10uF; C_0805_2012Metric
C17, C18, C37, C38: 22uF; C_0805_2012Metric
C19, C20: 100uF; C_1210_3225Metric
C21: 0.1uF; C_0603_1608Metric
C26, C32: 3.3nF; C_0603_1608Metric
C27, C33: 1uF; C_0603_1608Metric
C34: 4.7uF; C_0805_2012Metric
C36: 47nF; C_0603_1608Metric
L2: 3.3uH; L_2141; Manufacturer_Part_Number HPC5040NF-3R3MTH
L4: 1uH; L_2510; Manufacturer_Part_Number MCS25GD-1R0MMP
Q1: DMN100-7-F; SOT-23
Q2: MMDT5551-7-F; SOT-363_SC-70-6; Manufacturer_Part_Number MBT2222ADW1T1G
Q3: MMDT5551-7-F; SOT-363_SC-70-6
Q22: IRF7404TRPBF; SOIC-8_3.9x4.9mm_P1.27mm
R8: 0.1; R_2512_6332Metric
R13, R29: 73.2k; R_0603_1608Metric
R14: 22.1k; R_0603_1608Metric
R15, R30, R49, R167: 100k; R_0603_1608Metric
R21, R46, R52: 10k; R_0603_1608Metric
R22: 4.7k; R_0603_1608Metric
R23: 3.3k; R_0603_1608Metric
R26: 1k; R_0603_1608Metric
R34: 5.23k; R_0603_1608Metric
R35: 30.1k; R_0603_1608Metric
R36: 3.16k; R_0603_1608Metric
R47: 200k; R_0603_1608Metric
R110: 20k; R_0603_1608Metric
U4: ADM1176-1ARMZ-R7; Manufacturer_Part_Number ADM1176-1ARMZ-R7
U5: TPS54226PWPRPWP14_2P31X2P46-L; PWP14_2P31X2P46-L; Manufacturer_Part_Number TPS54226PWPR
U17: BQ25883RGER; QFN50P400X400X100-25N-D; Manufacturer_Part_Number BQ25883RGER

Connections:
3.3V: C17.2, C18.2, L2.2, Q22.1 (Source), Q22.2 (Source), Q22.3 (Source), R13.2, R23.1, U5.1 (VO)
3V3_EN: Q2.6 (C1), R29.2, U5.7 (EN)
5V_USB: C33.2, R34.1, U17.23 (VBUS)
ENAB_GPS: R21.1, R22.1
GND: C17.1, C18.1, C19.2, C20.2, C26.2, C27.2, C32.1, Q1.2 (S), Q2.1 (E1), Q2.4 (E2), Q3.1 (E1), Q3.4 (E2), R14.1, R21.2, U4.4 (GND), U5.5 (GND), U5.8 (PGND1), U5.9 (PGND2), U5.15 (EPAD)
GNDREF: C33.1, C34.2, C35.1, C37.1, C38.1, C39.1, R35.1, R36.1, R46.1, R167.2, U17.19 (GND_1), U17.20 (GND_2), U17.25 (EP)
GPS_PWR_IN: Q22.5 (Drain), Q22.6 (Drain), Q22.7 (Drain), Q22.8 (Drain)
unnamed: C6.1, Q3.3 (C2), Q3.6 (C1), R49.2
unnamed: C6.2, Q2.5 (B2), R47.2
unnamed: C21.1, L2.1, U5.10 (SW1), U5.11 (SW2)
unnamed: C21.2, U5.12 (VBST)
unnamed: C26.1, U5.4 (SS)
unnamed: C27.1, R15.2, U5.3 (VREG5)
unnamed: C32.2, U4.5 (TIMER)
unnamed: C35.2, L4.1, U17.21 (PMID_1), U17.22 (PMID_2)
unnamed: C36.1, L4.2, U17.17 (SW_1), U17.18 (SW_2)
unnamed: C36.2, U17.12 (BTST)
unnamed: Q1.1 (G), R22.2
unnamed: Q1.3 (D), Q22.4 (Gate), R23.2
unnamed: Q2.2 (B1), Q2.3 (C2), R30.2, R110.2
unnamed: Q3.2 (B1), R110.1
unnamed: Q3.5 (B2), R52.1
unnamed: R13.1, R14.2, U5.2 (VFB)
unnamed: R15.1, U5.6 (PG)
unnamed: R26.2, U4.3 (ON)
unnamed: R36.2, U17.8 (ILIM)
unnamed: R167.1, U17.3 (~CE)
SCL_PWR: U4.6 (SCL), U17.5 (SCL)
SDA_PWR: U4.7 (SDA), U17.4 (SDA)
STAT: C34.1, U17.2 (STAT), U17.11 (REGN)
THM: R34.2, R35.2, R46.2, U17.7 (TS)
USB_D+: U17.24 (D+)
USB_D-: U17.1 (D-)
VBUS: C19.1, C20.1, R29.1, R30.1, R47.1, R49.1, U5.13 (VIN), U5.14 (VCC)
VBUS_INHIBIT: R8.1, R26.1, U4.2 (SENSE)
VBUS_RESET: R52.2
VBUS_USB: C37.2, C38.2, U17.15 (SYS_1), U17.16 (SYS_2)
VCHRG: R8.2, U4.1 (VCC)
VCHRG_USB: C39.2, U17.13 (BAT_1), U17.14 (BAT_2)

Notes on the sheet:
(power TO bus)
Value is convenient, not necessary. 10K-80K would also work for R29
Input Current Limit Max input current (IINMAX)=KILIM/RILIM KILIM = 1098 to 1276 at most IINMAX=400mA=3.16 kohm
USB (Boost) Charging for 2-cell Li-Ion
Battery Power Monitor
Addr: 0x94
sub'd q2, 3 was MBR2222ADW1T1
"One Shot" Regulator Reset
GPS Power Switch
sub'd q22 was NDS8434
Power
16V ceramic 1210 caps
Sets EN low dwell time
turns on org yed
sub'd q1 was IRLML2803
NOTE: Components labeled "do not install" (DNI) are not populated by default
Current Sense Resistor: 1.0 Ohm is about 0.3mW power lost as heat
VBUS 4.5 to 18V 8.2V Vfloat(batt charging) 7.2V Vbatt
Regulator - 3.3V OUT
Solar Charge Regulator replaced
RF Regulator replaced
