erichtang/mainboard/hardware/foras-promineo-revB-em/RF_and_GPS.kicad_sch

## KiCad design hardware/foras-promineo-revB-em/RF_and_GPS.kicad_sch (2022-06-06)

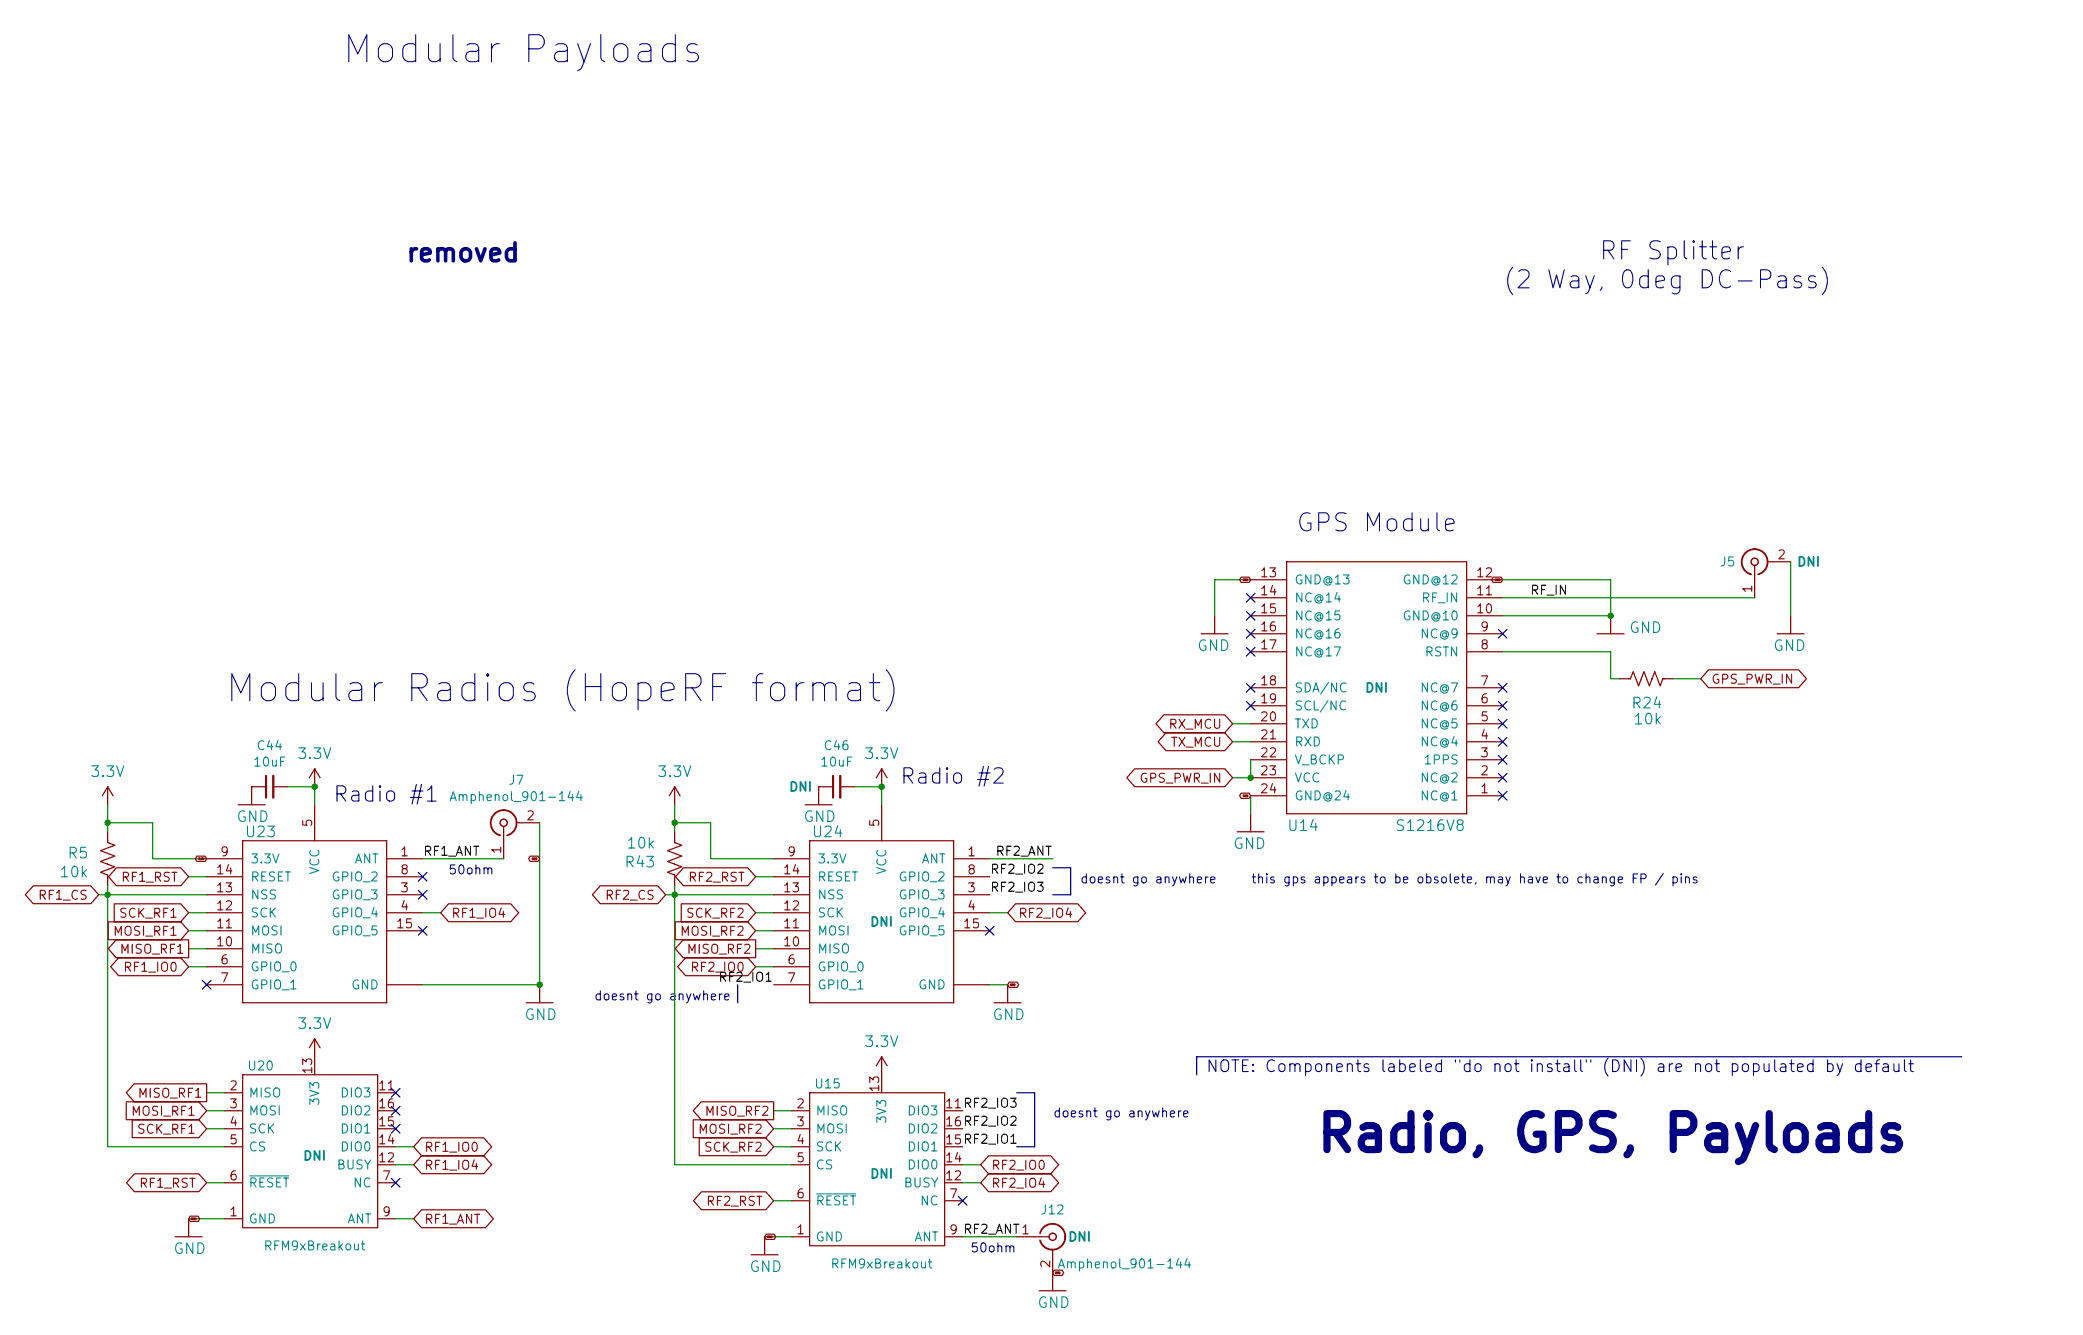
[picture p38: schematic RF_and_GPS.kicad_sch]

Parts:
C44, C46: 10uF; C_0805_2012Metric
J5, J7, J12: Amphenol_901-144; SMA_Amphenol_901-144_Vertical; Manufacturer_Part_Number 901-144
R5, R24, R43: 10k; R_0603_1608Metric
U14: S1216V8; S1216_24PIN_PACKAGE
U15, U20: RFM9xBreakout; HOPERF_RFM9XW_SMD
U23: RFM98PW; RFM95PW; Manufacturer_Part_Number RFM98PW
U24: RFM98PW; RFM95PW

Connections:
3.3V: C44.2, C46.2, R5.1, R43.1, U15.13 (3V3), U20.13 (3V3), U23.5 (VCC), U23.9 (3.3V), U24.5 (VCC), U24.9 (3.3V)
GND: C44.1, C46.1, J5.2 (Ext), J7.2 (Ext), J12.2 (Ext), U14.10 (GND@10), U14.12 (GND@12), U14.13 (GND@13), U14.24 (GND@24), U15.1 (GND), U15.8 (GND), U15.10 (GND), U20.1 (GND), U20.8 (GND), U20.10 (GND), U23.2 (GND), U23.16 (GND), U23.17 (GND), U24.2 (GND), U24.16 (GND), U24.17 (GND)
GPS_PWR_IN: R24.2, U14.22 (V_BCKP), U14.23 (VCC)
MISO_RF1: U20.2 (MISO), U23.10 (MISO)
MISO_RF2: U15.2 (MISO), U24.10 (MISO)
MOSI_RF1: U20.3 (MOSI), U23.11 (MOSI)
MOSI_RF2: U15.3 (MOSI), U24.11 (MOSI)
unnamed: R24.1, U14.8 (RSTN)
RF1_ANT: J7.1 (In), U20.9 (ANT), U23.1 (ANT)
RF1_CS: R5.2, U20.5 (CS), U23.13 (NSS)
RF1_IO0: U20.14 (DIO0), U23.6 (GPIO_0)
RF1_IO4: U20.12 (BUSY), U23.4 (GPIO_4)
RF1_RST: U20.6 (~RESET), U23.14 (RESET)
RF2_ANT: J12.1 (In), U15.9 (ANT), U24.1 (ANT)
RF2_CS: R43.2, U15.5 (CS), U24.13 (NSS)
RF2_IO0: U15.14 (DIO0), U24.6 (GPIO_0)
RF2_IO1: U15.15 (DIO1), U24.7 (GPIO_1)
RF2_IO2: U15.16 (DIO2), U24.8 (GPIO_2)
RF2_IO3: U15.11 (DIO3), U24.3 (GPIO_3)
RF2_IO4: U15.12 (BUSY), U24.4 (GPIO_4)
RF2_RST: U15.6 (~RESET), U24.14 (RESET)
RF_IN: J5.1 (In), U14.11 (RF_IN)
RX_MCU: U14.20 (TXD)
SCK_RF1: U20.4 (SCK), U23.12 (SCK)
SCK_RF2: U15.4 (SCK), U24.12 (SCK)
TX_MCU: U14.21 (RXD)

Notes on the sheet:
Radio #1
Modular Radios (HopeRF format)
50ohm
doesnt go anywhere
Radio #2
this gps appears to be obsolete, may have to change FP / pins
Radio, GPS, Payloads
NOTE: Components labeled "do not install" (DNI) are not populated by default
RF Splitter (2 Way, 0deg DC-Pass)
Modular Payloads
GPS Module
removed
