erichtang/mainboard/hardware/foras-promineo-revB-em/SLI-Backplane-Blank-Card-KiCad.kicad_sch

## KiCad design hardware/foras-promineo-revB-em/SLI-Backplane-Blank-Card-KiCad.kicad_sch (2022-06-21)

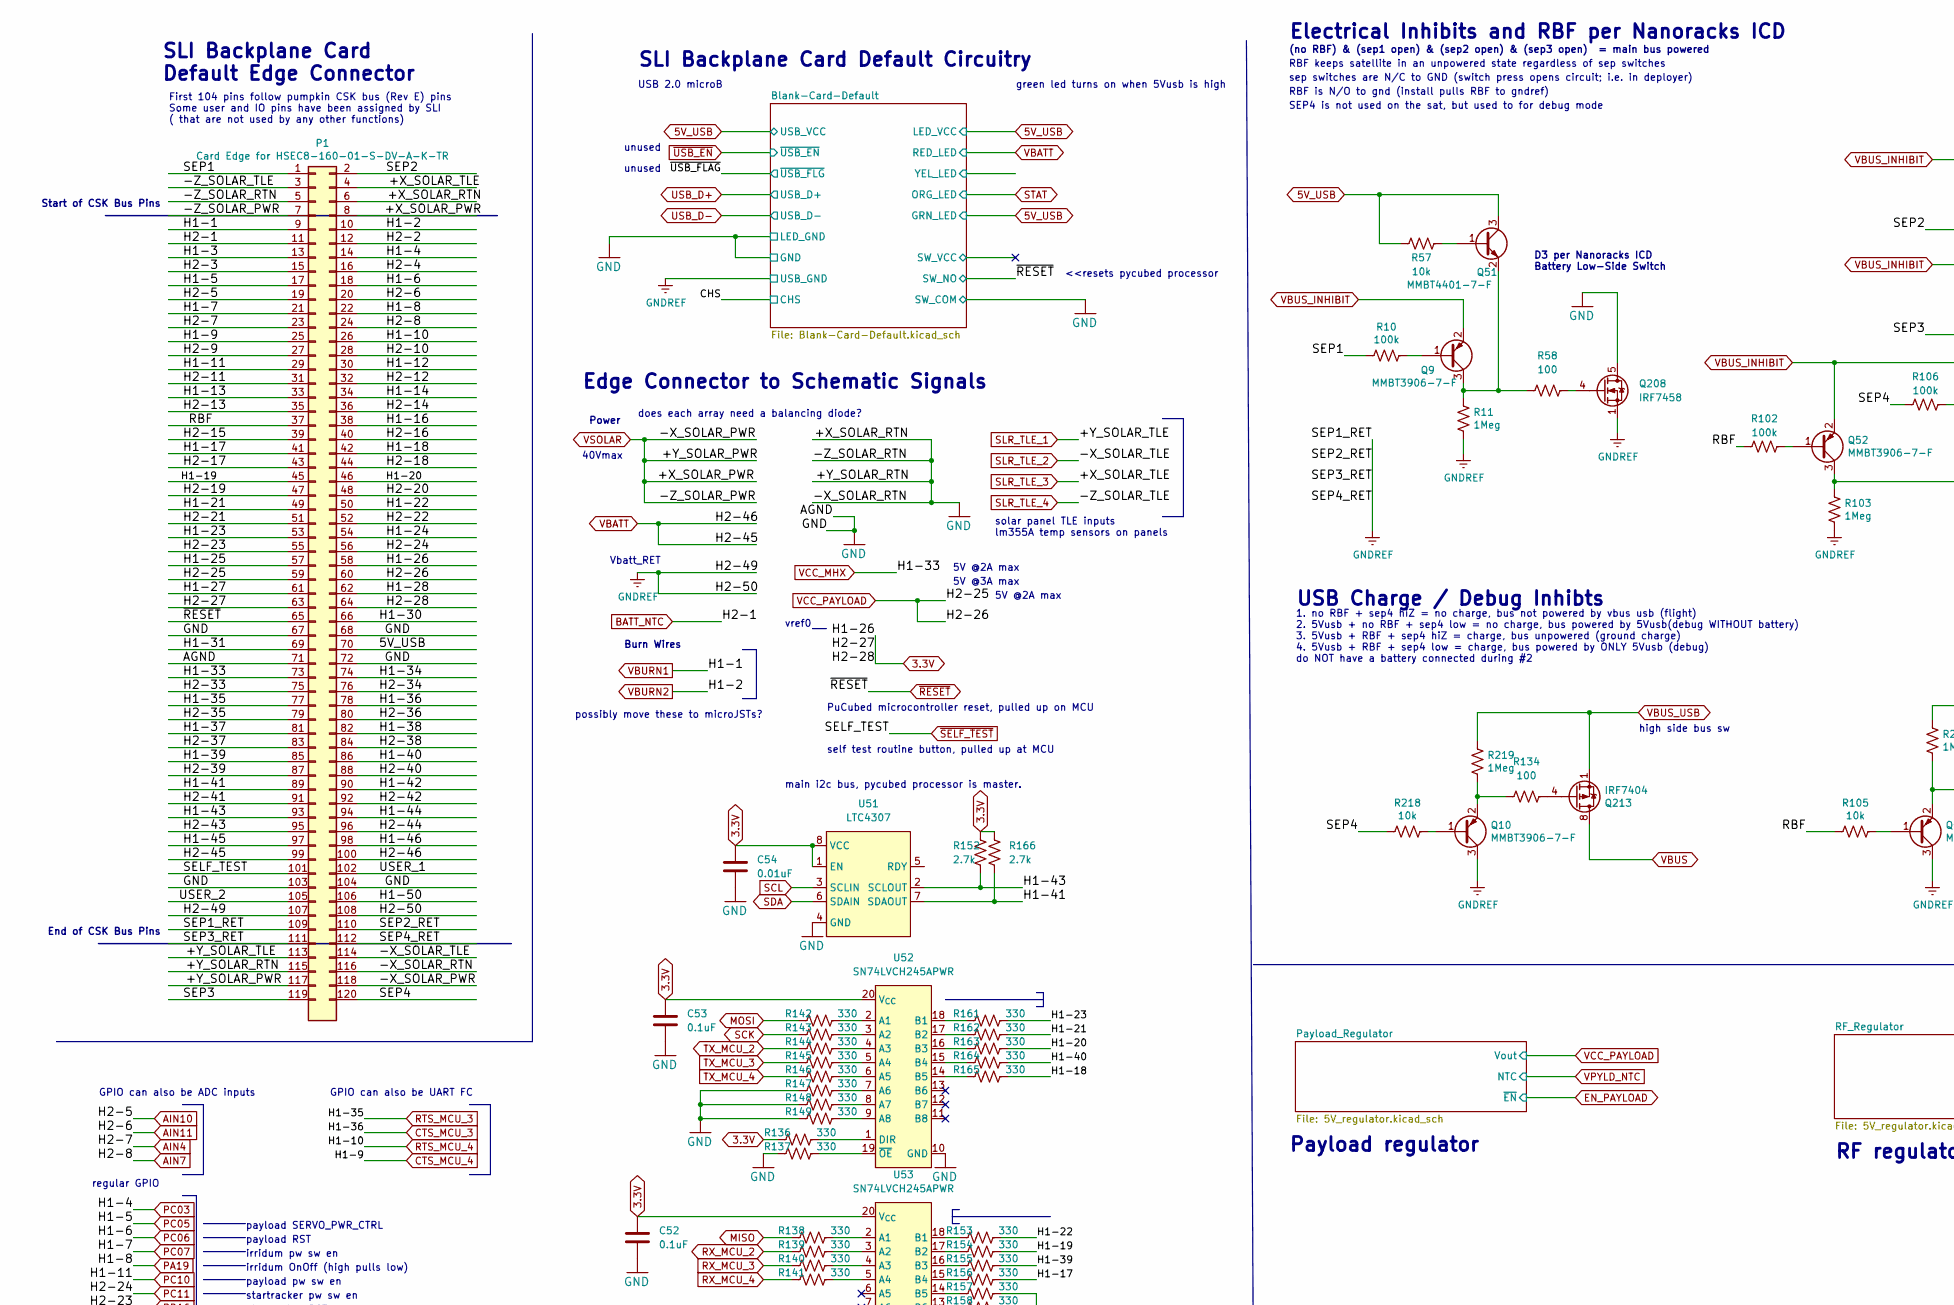
[picture p39: schematic SLI-Backplane-Blank-Card-KiCad.kicad_sch, part in row 1, column 1]

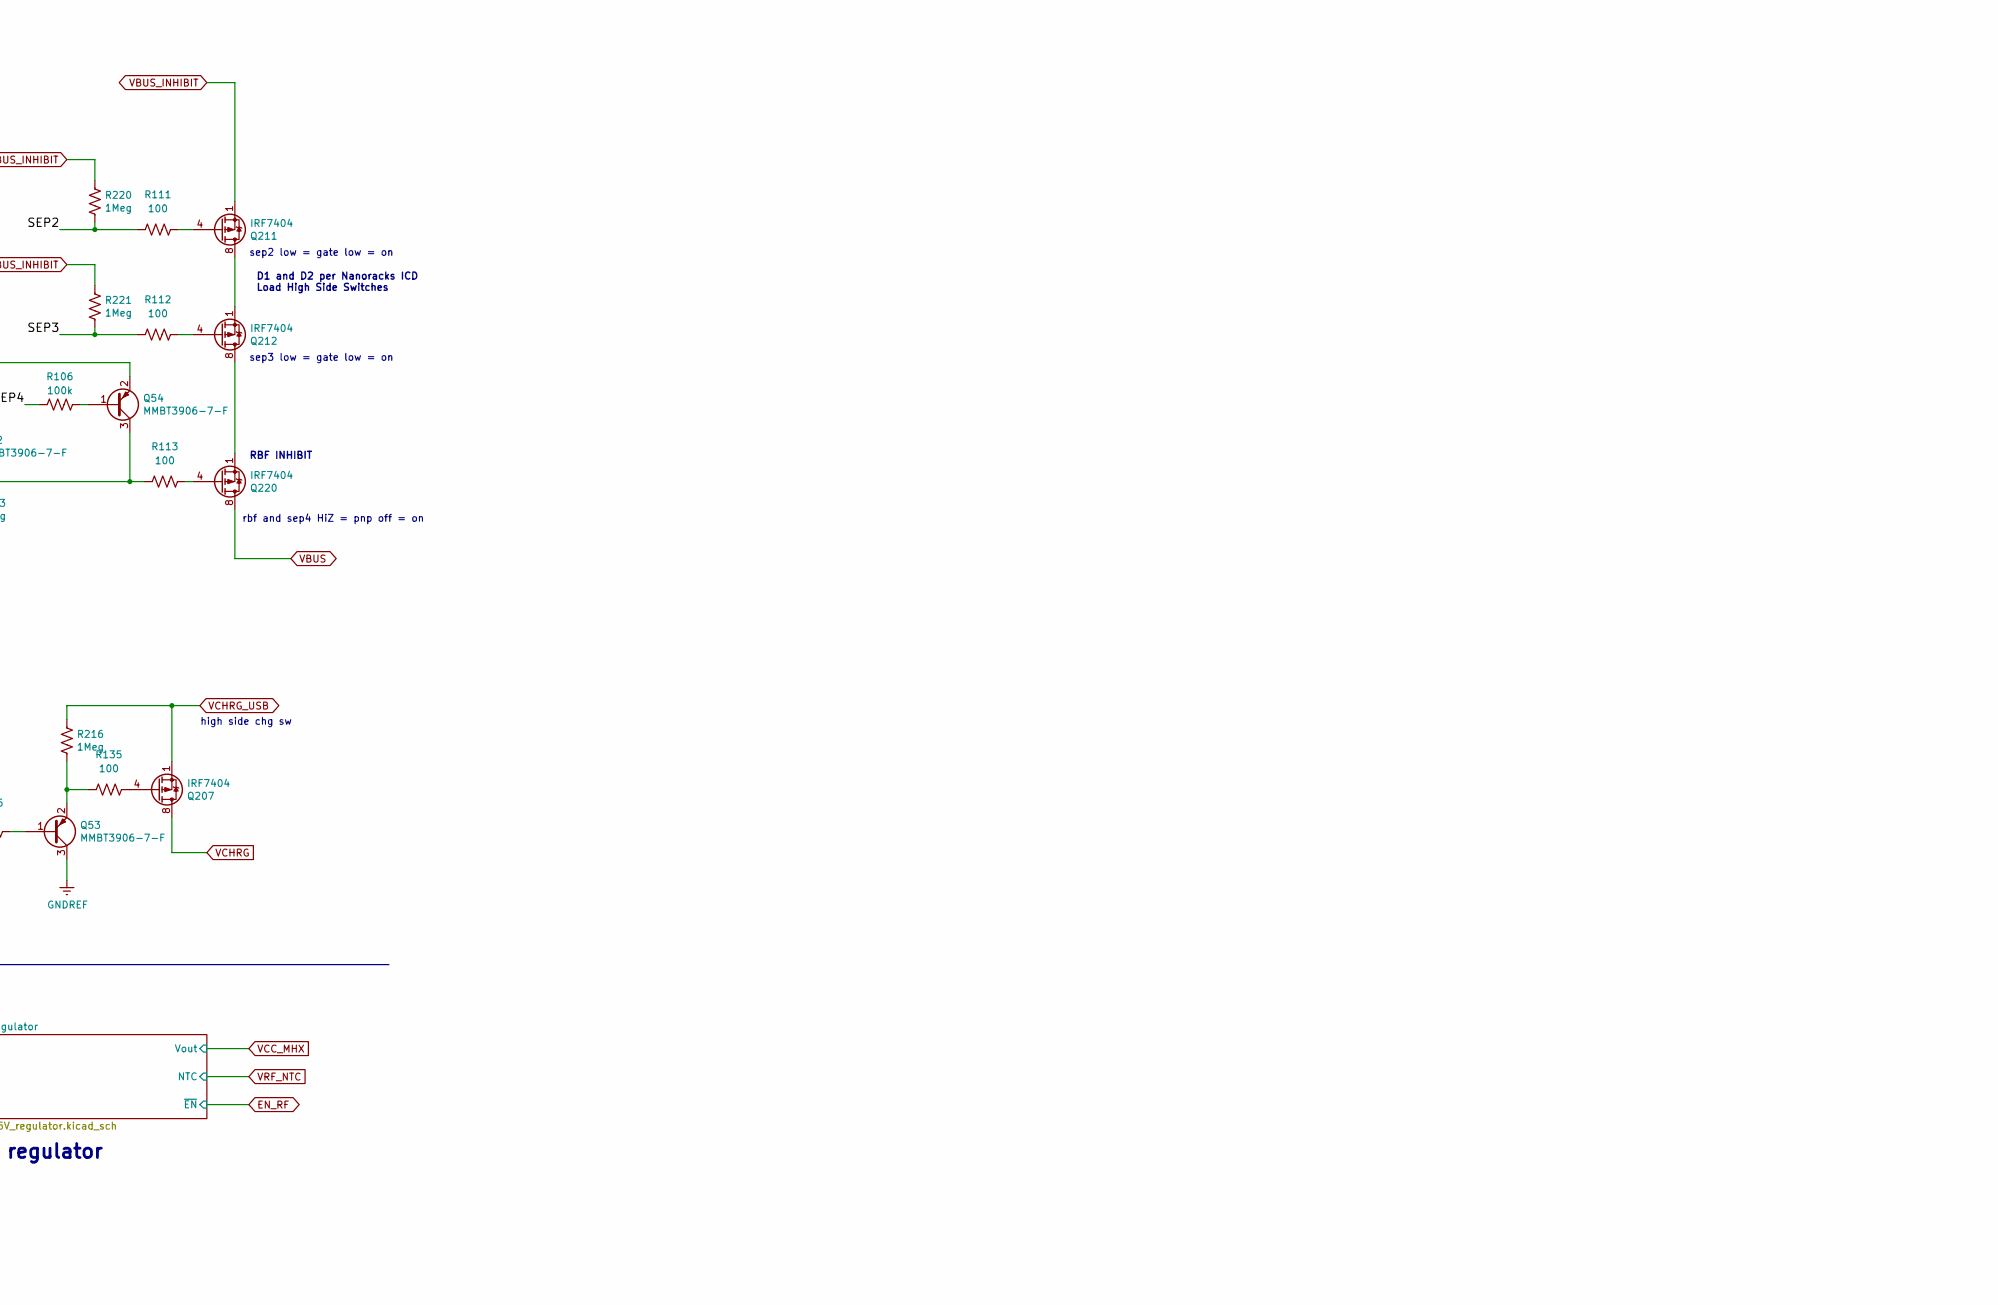
[picture p40: schematic SLI-Backplane-Blank-Card-KiCad.kicad_sch, part in row 1, column 2]

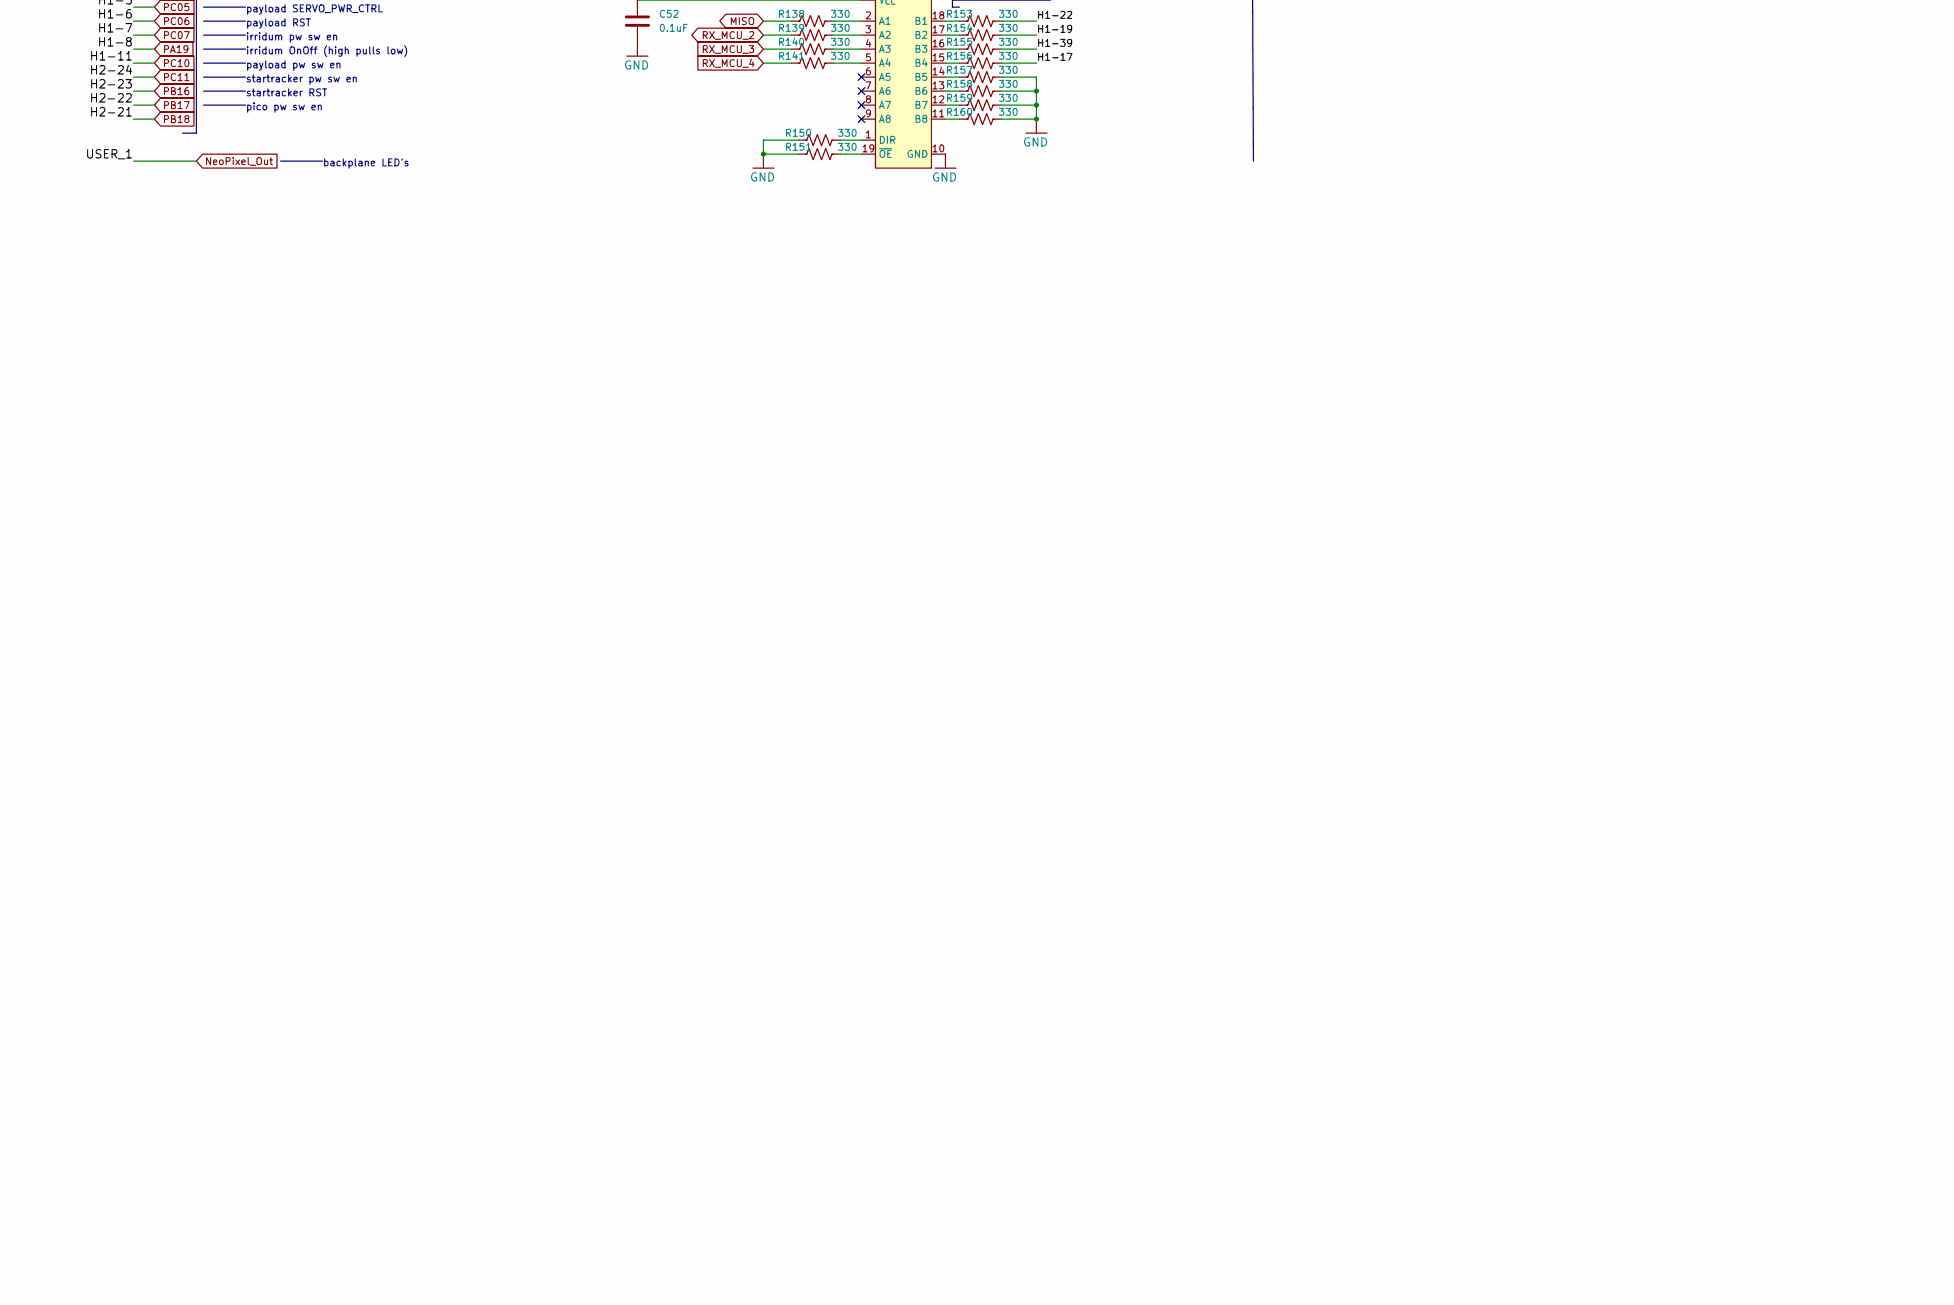
[picture p41: schematic SLI-Backplane-Blank-Card-KiCad.kicad_sch, part in row 2, column 1]

Parts:
C52, C53: 0.1uF; C_0603_1608Metric
C54: 0.01uF; C_0603_1608Metric
P1: Card Edge for HSEC8-160-01-S-DV-A-K-TR; HSEC8-160-CARD-EDGE
Q9, Q10, Q52, Q53, Q54: MMBT3906-7-F; SOT-23
Q51: MMBT4401-7-F; SOT-23
Q207, Q211, Q212, Q213, Q220: IRF7404; SOIC-8_3.9x4.9mm_P1.27mm
Q208: IRF7458; SOIC-8_3.9x4.9mm_P1.27mm
R10, R102, R106: 100k; R_0603_1608Metric
R11, R103, R216, R219, R220, R221: 1Meg; R_0603_1608Metric
R57, R105, R218: 10k; R_0603_1608Metric
R58, R111, R112, R113, R134, R135: 100; R_0603_1608Metric
R136, R137, R138, R139, R140, R141, R142, R143, R144, R145, R146, R147, R148, R149, R150, R151, R153, R154, R155, R156, R157, R158, R159, R160, R161, R162, R163, R164, R165: 330; R_0603_1608Metric
R152, R166: 2.7k; R_0603_1608Metric
U51: LTC4307; MSOP-8_3x3mm_P0.65mm
U52, U53: SN74LVCH245APWR; TSSOP-20_4.4x6.5mm_P0.65mm

Connections:
3.3V: C52.1, C53.1, C54.1, P1.58, P1.63, P1.64, R136.1, R152.1, R166.1, U51.1 (EN), U51.8 (VCC), U52.20 (V_{CC}), U53.20 (V_{CC})
5V_USB: P1.70, Q51.3 (C), R57.2
AIN4: P1.23
AIN7: P1.24
AIN10: P1.19
AIN11: P1.20
BATT_NTC: P1.11
CTS_MCU_3: P1.78
CTS_MCU_4: P1.25
GND: C52.2, C53.2, C54.2, P1.5, P1.6, P1.67, P1.68, P1.71, P1.72, P1.103, P1.104, P1.115, P1.116, Q208.5 (D), Q208.6 (D), Q208.7 (D), Q208.8 (D), R137.1, R147.1, R148.1, R149.1, R150.1, R151.1, R157.2, R158.2, R159.2, R160.2, U51.4 (GND), U52.10 (GND), U53.10 (GND)
GNDREF: P1.107, P1.108, P1.109, P1.110, P1.111, P1.112, Q10.3 (C), Q53.3 (C), Q208.1 (S), Q208.2 (S), Q208.3 (S), R11.2, R103.2
H1-3: P1.13
H1-12: P1.30
H1-13: P1.33
H1-14: P1.34
H1-16: P1.38
H1-17: P1.41, R156.2
H1-18: P1.42, R165.2
H1-19: P1.45, R154.2
H1-20: P1.46, R163.2
H1-21: P1.49, R162.2
H1-22: P1.50, R153.2
H1-23: P1.53, R161.2
H1-24: P1.54
H1-25: P1.57
H1-27: P1.61
H1-28: P1.62
H1-30: P1.66
H1-31: P1.69
H1-34: P1.74
H1-37: P1.81
H1-38: P1.82
H1-39: P1.85, R155.2
H1-40: P1.86, R164.2
H1-41: P1.89, R166.2, U51.7 (SDAOUT)
H1-42: P1.90
H1-43: P1.93 (Pin93), R152.2, U51.2 (SCLOUT)
H1-44: P1.94
H1-45: P1.97
H1-46: P1.98
H1-50: P1.106
H2-2: P1.12
H2-3: P1.15
H2-4: P1.16
H2-9: P1.27
H2-10: P1.28
H2-11: P1.31
H2-12: P1.32
H2-13: P1.35
H2-14: P1.36
H2-15: P1.39
H2-16: P1.40
H2-17: P1.43
H2-18: P1.44
H2-19: P1.47
H2-20: P1.48
H2-33: P1.75
H2-34: P1.76
H2-35: P1.79
H2-36: P1.80
H2-37: P1.83
H2-38: P1.84
H2-39: P1.87
H2-40: P1.88
H2-41: P1.91
H2-42: P1.92
H2-43: P1.95
H2-44: P1.96
MISO: R138.1
MOSI: R142.1
NeoPixel_Out: P1.102
unnamed: Q9.1 (B), R10.1
unnamed: Q10.1 (B), R218.1
unnamed: Q10.2 (E), R134.1, R219.2
unnamed: Q51.1 (B), R57.1
unnamed: Q9.3 (C), Q51.2 (E), R11.1, R58.1
unnamed: Q52.1 (B), R102.1
unnamed: Q52.3 (C), Q54.3 (C), R103.1, R113.1
unnamed: Q53.1 (B), R105.1
unnamed: Q53.2 (E), R135.1, R216.2
unnamed: Q54.1 (B), R106.1
unnamed: Q207.4 (G), R135.2
unnamed: Q208.4 (G), R58.2
unnamed: Q211.4 (G), R111.2
unnamed: Q211.5 (D), Q211.6 (D), Q211.7 (D), Q211.8 (D), Q212.1 (S), Q212.2 (S), Q212.3 (S)
unnamed: Q212.4 (G), R112.2
unnamed: Q212.5 (D), Q212.6 (D), Q212.7 (D), Q212.8 (D), Q220.1 (S), Q220.2 (S), Q220.3 (S)
unnamed: Q213.4 (G), R134.2
unnamed: Q220.4 (G), R113.2
unnamed: R136.2, U52.1 (DIR)
unnamed: R137.2, U52.19 (~OE)
unnamed: R138.2, U53.2 (A1)
unnamed: R139.2, U53.3 (A2)
unnamed: R140.2, U53.4 (A3)
unnamed: R141.2, U53.5 (A4)
unnamed: R142.2, U52.2 (A1)
unnamed: R143.2, U52.3 (A2)
unnamed: R144.2, U52.4 (A3)
unnamed: R145.2, U52.5 (A4)
unnamed: R146.2, U52.6 (A5)
unnamed: R147.2, U52.7 (A6)
unnamed: R148.2, U52.8 (A7)
unnamed: R149.2, U52.9 (A8)
unnamed: R150.2, U53.1 (DIR)
unnamed: R151.2, U53.19 (~OE)
unnamed: R153.1, U53.18 (B1)
unnamed: R154.1, U53.17 (B2)
unnamed: R155.1, U53.16 (B3)
unnamed: R156.1, U53.15 (B4)
unnamed: R157.1, U53.14 (B5)
unnamed: R158.1, U53.13 (B6)
unnamed: R159.1, U53.12 (B7)
unnamed: R160.1, U53.11 (B8)
unnamed: R161.1, U52.18 (B1)
unnamed: R162.1, U52.17 (B2)
unnamed: R163.1, U52.16 (B3)
unnamed: R164.1, U52.15 (B4)
unnamed: R165.1, U52.14 (B5)
PA19: P1.22
PB16: P1.55
PB17: P1.52
PB18: P1.51
PC03: P1.14
PC05: P1.17
PC06: P1.18
PC07: P1.21
PC10: P1.29
PC11: P1.56
RBF: P1.37, R102.2, R105.2
RTS_MCU_3: P1.77
RTS_MCU_4: P1.26
RX_MCU_2: R139.1
RX_MCU_3: R140.1
RX_MCU_4: R141.1
SCK: R143.1
SCL: U51.3 (SCLIN)
SDA: U51.6 (SDAIN)
SEP1: P1.1, R10.2
SEP2: P1.2, R111.1, R220.2
SEP3: P1.119, R112.1, R221.2
SEP4: P1.120, R106.2, R218.2
SLR_TLE_1: P1.113
SLR_TLE_2: P1.114
SLR_TLE_3: P1.4
SLR_TLE_4: P1.3
TX_MCU_2: R144.1
TX_MCU_3: R145.1
TX_MCU_4: R146.1
USER_2: P1.105
VBATT: P1.99, P1.100
VBURN1: P1.9
VBURN2: P1.10
VBUS: Q213.5 (D), Q213.6 (D), Q213.7 (D), Q213.8 (D), Q220.5 (D), Q220.6 (D), Q220.7 (D), Q220.8 (D)
VBUS_INHIBIT: Q9.2 (E), Q52.2 (E), Q54.2 (E), Q211.1 (S), Q211.2 (S), Q211.3 (S), R220.1, R221.1
VBUS_USB: Q213.1 (S), Q213.2 (S), Q213.3 (S), R219.1
VCC_MHX: P1.73
VCC_PAYLOAD: P1.59, P1.60
VCHRG: Q207.5 (D), Q207.6 (D), Q207.7 (D), Q207.8 (D)
VCHRG_USB: Q207.1 (S), Q207.2 (S), Q207.3 (S), R216.1
VSOLAR: P1.7, P1.8, P1.117, P1.118
~RESET: P1.65
~SELF_TEST: P1.101

Notes on the sheet:
rbf and sep4 HiZ = pnp off = on
SEP4 is not used on the sat, but used to for debug mode
pico pw sw en
possibly move these to microJSTs?
high side chg sw
Power
RBF is N/O to gnd (install pulls RBF to gndref)
RBF INHIBIT
irridum OnOff (high pulls low)
GPIO can also be UART FC
SLI Backplane Card Default Edge Connector
solar panel TLE inputs lm355A temp sensors on panels
sep2 low = gate low = on
Start of CSK Bus Pins
PuCubed microcontroller reset, pulled up on MCU
5V @2A max
USB 2.0 microB
regular GPIO
40Vmax
startracker pw sw en
backplane LED's
startracker RST
D3 per Nanoracks ICD Battery Low-Side Switch
D1 and D2 per Nanoracks ICD Load High Side Switches
unused
GPIO can also be ADC inputs
5V @3A max
sep switches are N/C to GND (switch press opens circuit; i.e. in deployer)
sep3 low = gate low = on
payload RST
does each array need a balancing diode?
RF regulator
USB Charge / Debug Inhibts
RBF keeps satellite in an unpowered state regardless of sep switches
vref0
self test routine button, pulled up at MCU
1. no RBF + sep4 hiZ = no charge, bus not powered by vbus usb (flight) 2. 5Vusb + no RBF + sep4 low = no charge, bus powered by 5Vusb(debug WITHOUT battery) 3. 5Vusb + RBF + sep4 hiZ = charge, bus unpowered (ground charge) 4. 5Vusb + RBF + sep4 low = charge, bus powered by ONLY 5Vusb (debug) do NOT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
green led turns on when 5Vusb is high
Burn Wires
Edge Connector to Schematic Signals
high side bus sw
SLI Backplane Card Default Circuitry
main i2c bus, pycubed processor is master.
<<resets pycubed processor
End of CSK Bus Pins
Electrical Inhibits and RBF per Nanoracks ICD
irridum pw sw en
Vbatt_RET
payload pw sw en
(no RBF) & (sep1 open) & (sep2 open) & (sep3 open) = main bus powered
payload SERVO_PWR_CTRL
Payload regulator
First 104 pins follow pumpkin CSK bus (Rev E) pins Some user and IO pins have been assigned by SLI ( that are not used by any other functions)
