erichtang/mainboard/hardware/foras-promineo-revB-em/Solar Charge Regulator.kicad_sch

## KiCad design hardware/foras-promineo-revB-em/Solar Charge Regulator.kicad_sch (2022-06-21)

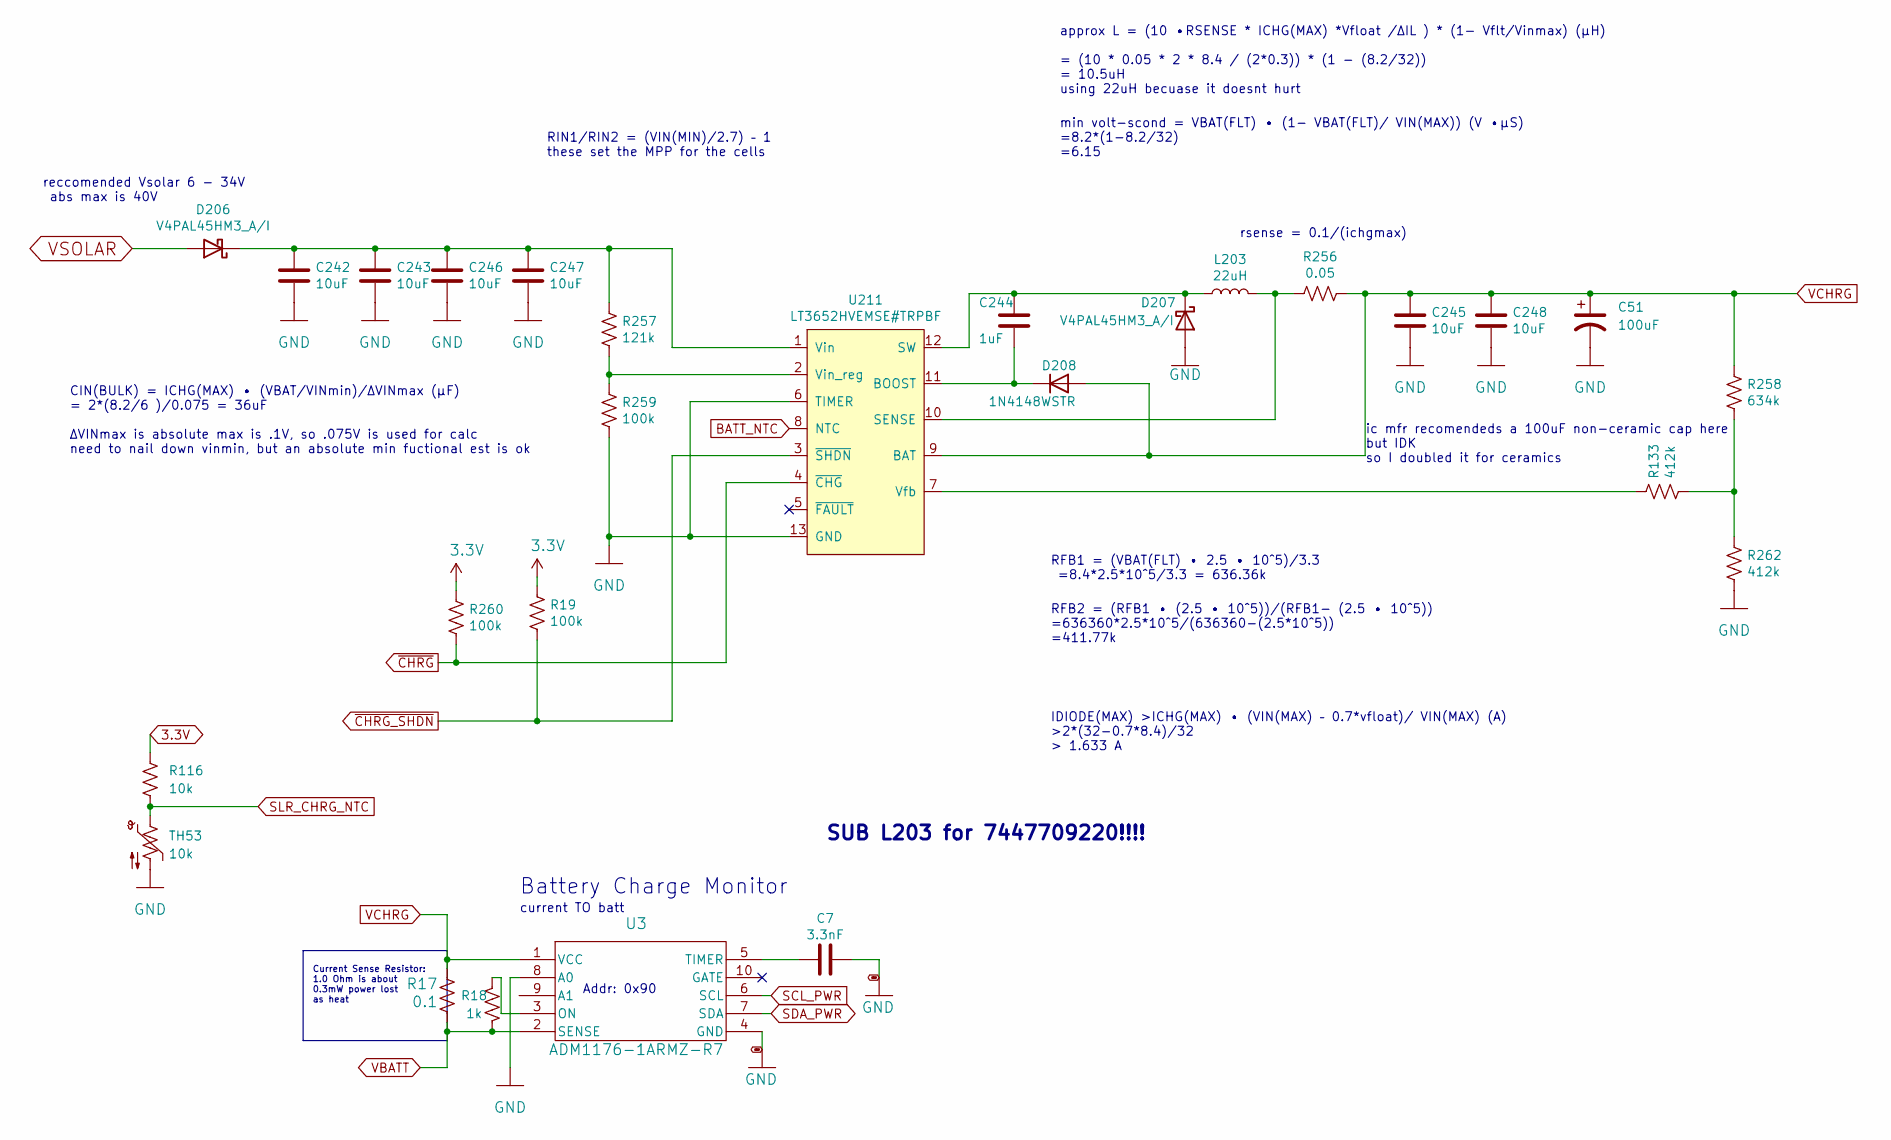
[picture p42: schematic Solar Charge Regulator.kicad_sch]

Parts:
C7: 3.3nF; C_0603_1608Metric
C51: 100uF; CP_EIA-7343-43_Kemet-X
C242, C243, C245, C246, C247, C248: 10uF; C_1210_3225Metric
C244: 1uF; C_0603_1608Metric
D206, D207: V4PAL45HM3_A/I; SMPA
D208: 1N4148WSTR; D_SOD-323
L203: 22uH; L_Wuerth_WE-PD-1260
R17: 0.1; R_2512_6332Metric
R18: 1k; R_0603_1608Metric
R19, R259, R260: 100k; R_0603_1608Metric
R116: 10k; R_0603_1608Metric
R133, R262: 412k; R_0603_1608Metric
R256: 0.05; R_1206_3216Metric
R257: 121k; R_0603_1608Metric
R258: 634k; R_0603_1608Metric
TH53: 10k; R_0603_1608Metric
U3: ADM1176-1ARMZ-R7; Manufacturer_Part_Number ADM1176-1ARMZ-R7
U211: ‎LT3652HVEMSE#TRPBF‎; MSOP-12-1EP_3x4mm_P0.65mm_EP1.65x2.85mm_ThermalVias

Connections:
3.3V: R19.1, R116.1, R260.1
BATT_NTC: U211.8 (NTC)
GND: C7.1, C51.2, C242.2, C243.2, C245.2, C246.2, C247.2, C248.2, D207.2 (A), R259.2, R262.2, TH53.2, U3.4 (GND), U3.8 (A0), U211.6 (TIMER), U211.13 (GND)
unnamed: C7.2, U3.5 (TIMER)
unnamed: C242.1, C243.1, C246.1, C247.1, D206.1 (K), R257.1, U211.1 (Vin)
unnamed: C244.1, D207.1 (K), L203.2, U211.12 (SW)
unnamed: C244.2, D208.1 (K), U211.11 (BOOST)
unnamed: L203.1, R256.2, U211.10 (SENSE)
unnamed: R18.2, U3.3 (ON)
unnamed: R133.1, U211.7 (Vfb)
unnamed: R133.2, R258.2, R262.1
unnamed: R257.2, R259.1, U211.2 (Vin_reg)
SCL_PWR: U3.6 (SCL)
SDA_PWR: U3.7 (SDA)
SLR_CHRG_NTC: R116.2, TH53.1
VBATT: R17.1, R18.1, U3.2 (SENSE)
VCHRG: C51.1, C245.1, C248.1, D208.2 (A), R17.2, R256.1, R258.1, U3.1 (VCC), U211.9 (BAT)
VSOLAR: D206.2 (A)
~CHRG_SHDN: R19.2, U211.3 (~SHDN)
~CHRG: R260.2, U211.4 (~CHG)

Notes on the sheet:
Battery Charge Monitor
RFB2 = (RFB1 • (2.5 • 10^5))/(RFB1- (2.5 • 10^5)) =636360*2.5*10^5/(636360-(2.5*10^5)) =411.77k
reccomended Vsolar 6 - 34V abs max is 40V
ic mfr recomendeds a 100uF non-ceramic cap here but IDK so I doubled it for ceramics
SUB L203 for 7447709220!!!!
current TO batt
CIN(BULK) = ICHG(MAX) • (VBAT/VINmin)/ΔVINmax (µF) = 2*(8.2/6 )/0.075 = 36uF ΔVINmax is absolute max is .1V, so .075V is used for calc need to nail down vinmin, but an absolute min fuctional est is ok
IDIODE(MAX) >ICHG(MAX) • (VIN(MAX) – 0.7*vfloat)/ VIN(MAX) (A) >2*(32-0.7*8.4)/32 > 1.633 A
RFB1 = (VBAT(FLT) • 2.5 • 10^5)/3.3 =8.4*2.5*10^5/3.3 = 636.36k
RIN1/RIN2 = (VIN(MIN)/2.7) – 1 these set the MPP for the cells
approx L = (10 •RSENSE * ICHG(MAX) *Vfloat /ΔIL ) * (1- Vflt/Vinmax) (µH) = (10 * 0.05 * 2 * 8.4 / (2*0.3)) * (1 - (8.2/32)) = 10.5uH using 22uH becuase it doesnt hurt
rsense = 0.1/(ichgmax)
Current Sense Resistor: 1.0 Ohm is about 0.3mW power lost as heat
Addr: 0x90
min volt-scond = VBAT(FLT) • (1− VBAT(FLT)/ VIN(MAX)) (V •µS) =8.2*(1-8.2/32) =6.15
