erichtang/mainboard/hardware/foras-promineo-revB-em/analog_mux.kicad_sch

## KiCad design hardware/foras-promineo-revB-em/analog_mux.kicad_sch (2022-06-06)

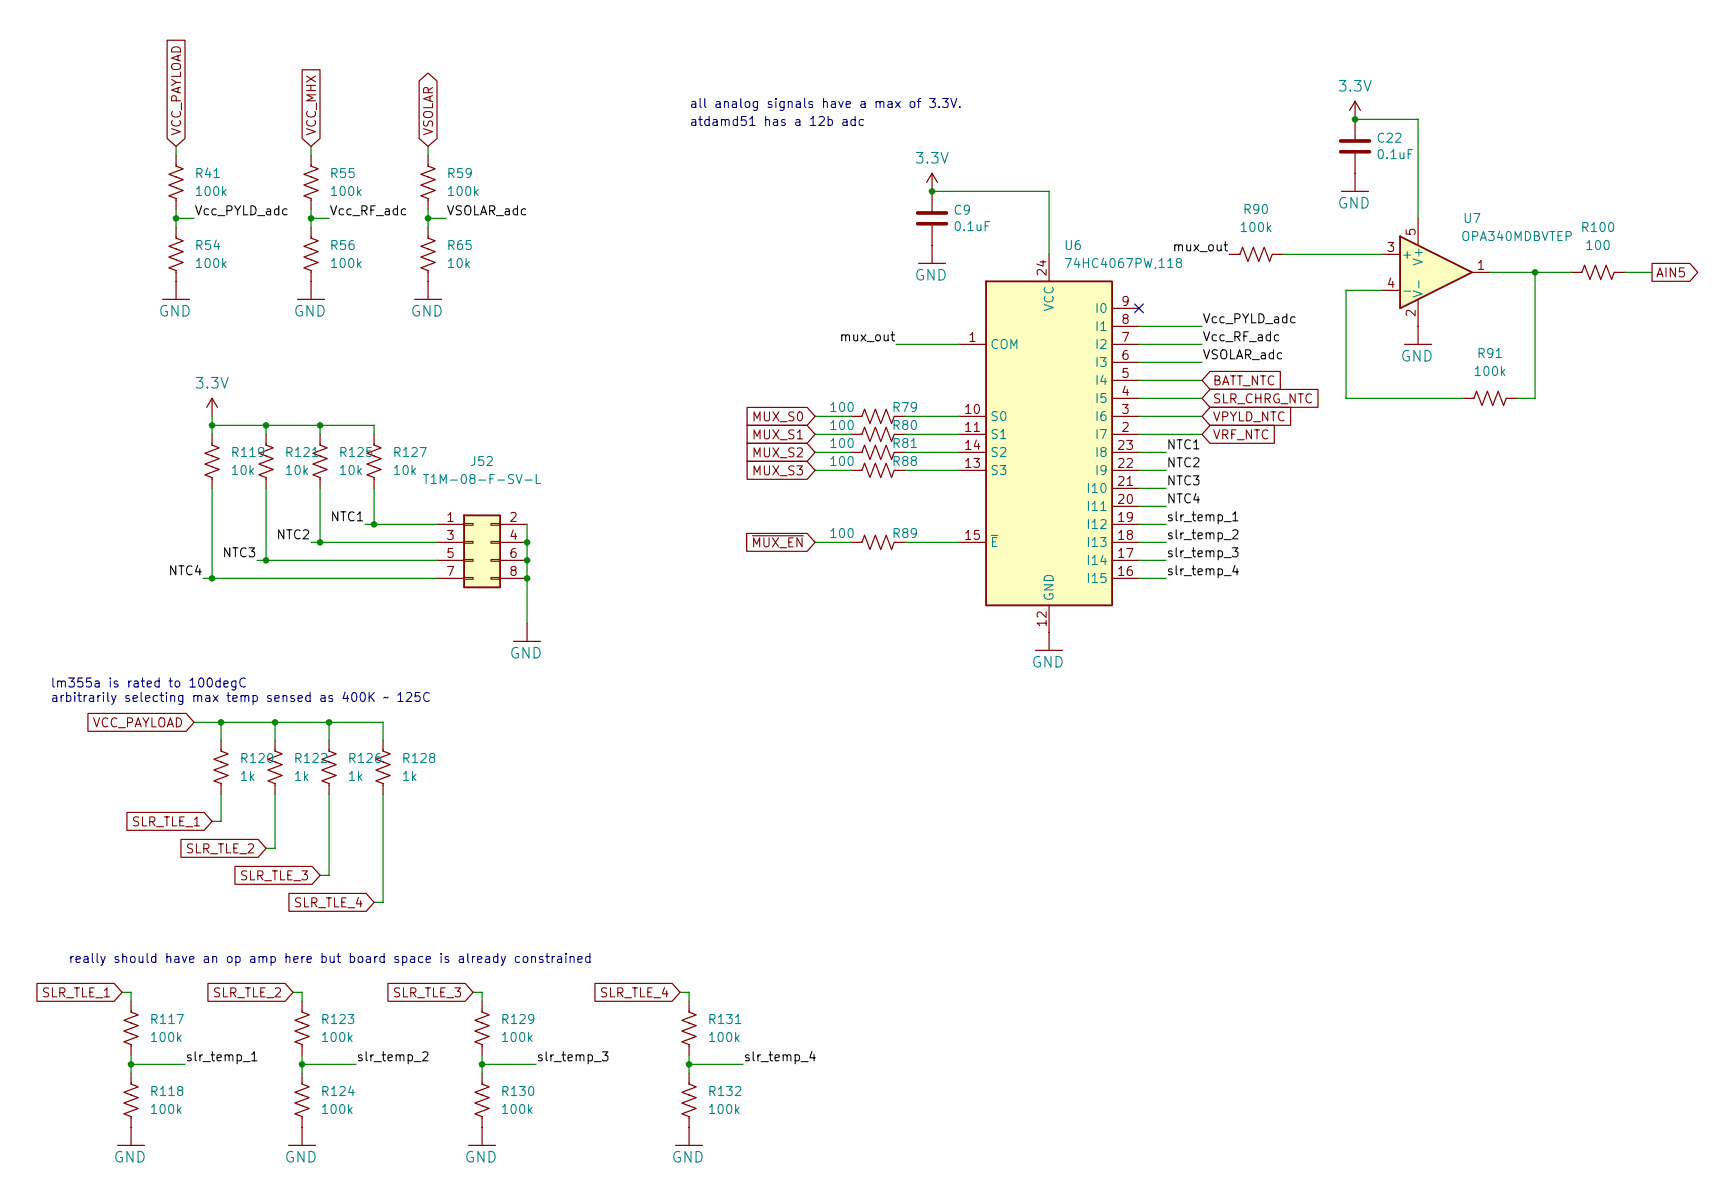
[picture p43: schematic analog_mux.kicad_sch]

Parts:
C9, C22: 0.1uF; C_0603_1608Metric
J52: T1M-08-F-SV-L; SAMTEC_T1M-08-F-SV-L
R41, R54, R55, R56, R59, R90, R91, R117, R118, R123, R124, R129, R130, R131, R132: 100k; R_0603_1608Metric
R65, R119, R121, R125, R127: 10k; R_0603_1608Metric
R79, R80, R81, R88, R89, R100: 100; R_0603_1608Metric
R120, R122, R126, R128: 1k; R_0603_1608Metric
U6: 74HC4067PW,118; TSSOP-24_4.4x7.8mm_P0.65mm
U7: OPA340MDBVTEP; SOT-23-5

Connections:
3.3V: C9.1, C22.1, R119.1, R121.1, R125.1, R127.1, U6.24 (VCC), U7.5 (V+)
AIN5: R100.2
BATT_NTC: U6.5 (I4)
GND: C9.2, C22.2, J52.2, J52.4, J52.6, J52.8, R54.2, R56.2, R65.2, R118.2, R124.2, R130.2, R132.2, U6.12 (GND), U7.2 (V-)
MUX_S0: R79.1
MUX_S1: R80.1
MUX_S2: R81.1
MUX_S3: R88.1
NTC1: J52.1, R127.2, U6.23 (I8)
NTC2: J52.3, R125.2, U6.22 (I9)
NTC3: J52.5, R121.2, U6.21 (I10)
NTC4: J52.7, R119.2, U6.20 (I11)
unnamed: R79.2, U6.10 (S0)
unnamed: R80.2, U6.11 (S1)
unnamed: R81.2, U6.14 (S2)
unnamed: R88.2, U6.13 (S3)
unnamed: R89.2, U6.15 (~E)
unnamed: R90.2, U7.3 (+)
unnamed: R91.1, U7.4 (-)
unnamed: R91.2, R100.1, U7.1
SLR_CHRG_NTC: U6.4 (I5)
SLR_TLE_1: R117.1, R120.2
SLR_TLE_2: R122.2, R123.1
SLR_TLE_3: R126.2, R129.1
SLR_TLE_4: R128.2, R131.1
VCC_MHX: R55.1
VCC_PAYLOAD: R41.1, R120.1, R122.1, R126.1, R128.1
VPYLD_NTC: U6.3 (I6)
VRF_NTC: U6.2 (I7)
VSOLAR: R59.1
VSOLAR_adc: R59.2, R65.1, U6.6 (I3)
Vcc_PYLD_adc: R41.2, R54.1, U6.8 (I1)
Vcc_RF_adc: R55.2, R56.1, U6.7 (I2)
mux_out: R90.1, U6.1 (COM)
slr_temp_1: R117.2, R118.1, U6.19 (I12)
slr_temp_2: R123.2, R124.1, U6.18 (I13)
slr_temp_3: R129.2, R130.1, U6.17 (I14)
slr_temp_4: R131.2, R132.1, U6.16 (I15)
~MUX_EN: R89.1

Notes on the sheet:
lm355a is rated to 100degC arbitrarily selecting max temp sensed as 400K ~ 125C
atdamd51 has a 12b adc
really should have an op amp here but board space is already constrained
all analog signals have a max of 3.3V.
