erichtang/mainboard/firmware/1.0-foras-promineo-proto/firmware_build/mpconfigboard.h

#define MICROPY_HW_BOARD_NAME "PyCubed_SLI"
#define MICROPY_HW_MCU_NAME "samd51n20"
#define CIRCUITPY_MCU_FAMILY samd51

#define MICROPY_HW_NEOPIXEL   (&pin_PA21)

// External flash MR2xH40 MRAM
#define EXTERNAL_FLASH_QSPI_SINGLE
#define EXTERNAL_FLASH_NO_JEDEC

#define AUTORESET_DELAY_MS 500

#define CIRCUITPY_INTERNAL_NVM_SIZE 8192

#define BOARD_FLASH_SIZE (FLASH_SIZE - 0x4000 - CIRCUITPY_INTERNAL_NVM_SIZE)

#define CIRCUITPY_DRIVE_LABEL "PYCUBED"
#define CIRCUITPY_BOOT_COUNTER 1

#define BOARD_HAS_CRYSTAL 1

#define DEFAULT_I2C_BUS_SCL  (&pin_PB13)
#define DEFAULT_I2C_BUS_SDA  (&pin_PB12)

#define DEFAULT_SPI_BUS_SCK  (&pin_PA13)
#define DEFAULT_SPI_BUS_MOSI (&pin_PA12)
#define DEFAULT_SPI_BUS_MISO (&pin_PA14)

#define DEFAULT_UART_BUS_TX  (&pin_PB02)
#define DEFAULT_UART_BUS_RX  (&pin_PB03)

#define IGNORE_PIN_PA24     1
#define IGNORE_PIN_PA25     1
