erichtang/mainboard/firmware/1.0-foras-promineo-proto/firmware_build/board.c

/*
 * This file is part of the MicroPython project, http://micropython.org/
 *
 * The MIT License (MIT)
 *
 * Copyright (c) 2017 Scott Shawcroft for Adafruit Industries
 *
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
 * THE SOFTWARE IS PROVIDED "AS IS", WITHOUT WARRANTY OF ANY KIND, EXPRESS OR
 * IMPLIED, INCLUDING BUT NOT LIMITED TO THE WARRANTIES OF MERCHANTABILITY,
 * FITNESS FOR A PARTICULAR PURPOSE AND NONINFRINGEMENT. IN NO EVENT SHALL THE
 * AUTHORS OR COPYRIGHT HOLDERS BE LIABLE FOR ANY CLAIM, DAMAGES OR OTHER
 * LIABILITY, WHETHER IN AN ACTION OF CONTRACT, TORT OR OTHERWISE, ARISING FROM,
 * OUT OF OR IN CONNECTION WITH THE SOFTWARE OR THE USE OR OTHER DEALINGS IN
 * THE SOFTWARE.
 */

#include "supervisor/board.h"
#include "mpconfigboard.h"
#include "common-hal/microcontroller/Pin.h"
#include "hal/include/hal_gpio.h"
#include "shared-bindings/pwmio/PWMOut.h"

void board_init(void) {
    pwmio_pwmout_obj_t pwm;
    common_hal_pwmio_pwmout_construct(&pwm, &pin_PA23, 4096, 2, false);
    common_hal_pwmio_pwmout_never_reset(&pwm);
}

bool board_requests_safe_mode(void) {
    return false;
}

void reset_board(void) {
}

void board_deinit(void) {
}
