erichtang/mainboard/(commit log)

2022-02-23 moving things around
    [5V_regulator.sch, Avionics.sch, Blank-Card-Default.sch, Burn_Wires.sch, Bus_Protection.sch, Connectors.sch, IMU.sch, Power.sch]
2022-02-23 renamed parent folder
    [5V_regulator.sch, Avionics.sch, Blank-Card-Default.sch, Burn_Wires.sch, Bus_Protection.sch, Connectors.sch, IMU.sch, Power.sch]
2022-02-23 moved log here
    [hands-on fab that needs to be done.xlsx, mainboard_bom_to_PCBway_121921 - Copy.xlsx, mainboard_log.xlsx]
2022-02-24 started updating BOM
    [mainboard-updated-bom-inprogress.xlsx, mainboard_bom_need_work.csv]
2022-02-27 added folder for FM
    [5V_regulator.sch, Avionics.sch, Blank-Card-Default.sch, Burn_Wires.sch, Bus_Protection.sch, Connectors.sch, IMU.sch, Power.sch]
2022-03-03 working on a circuitpython sketch to test board
2022-03-03 updated pins.c in firmware
    [5V_regulator.kicad_sch, Avionics.kicad_sch, Blank-Card-Default.kicad_sch, Burn_Wires.kicad_sch, Bus_Protection.kicad_sch, Connectors.kicad_sch, IMU.kicad_sch, Power.kicad_sch]
2022-03-13 imu libs
2022-03-17 started editing mainboard FM
    [5V_regulator.kicad_sch, Avionics.kicad_sch, Blank-Card-Default.kicad_sch, Burn_Wires.kicad_sch, Bus_Protection.kicad_sch, Connectors.kicad_sch, IMU.kicad_sch, Power.kicad_sch]
2022-03-20 lots of stuff
    [Avionics.kicad_sch, Blank-Card-Default.kicad_sch, Burn_Wires.kicad_sch, Connectors.kicad_sch, IMU.kicad_sch, Power.kicad_sch, RF_and_GPS.kicad_sch, SLI-Backplane-Blank-Card-KiCad.kicad_sch]
2022-03-20 changed folder names
    [5V_regulator.kicad_sch, 5V_regulator.sch, Avionics.kicad_sch, Avionics.sch, Blank-Card-Default.kicad_sch, Blank-Card-Default.sch, Burn_Wires.kicad_sch, Burn_Wires.sch]
2022-03-23 imu individual part libs working, onto IMU lib
2022-03-28 more testing
    [SLI-Backplane-Blank-Card-KiCad.kicad_sch]
2022-03-28 more rearranging
    [mainboard-updated-bom-inprogress.xlsx]
2022-04-01 more tweaking
    [5V_regulator.kicad_sch, mainboard.kicad_sch]
2022-04-05 got basic friendly IMU lib working on pycubed
2022-04-12 trying to get code working
    [5V_regulator.kicad_sch, Bus_Protection.kicad_sch, Power.kicad_sch]
2022-04-19 added charge current monitor
    [5V_regulator.kicad_sch, Avionics.kicad_sch, Bus_Protection.kicad_sch, Power.kicad_sch, Solar Charge Regulator.kicad_sch, mainboard.kicad_sch]
2022-04-27 raw imu things
    [task_breakdown.xlsx]
2022-05-12 updating FM
    [5V_regulator.kicad_sch, Avionics.kicad_sch, Bus_Protection.kicad_sch, Power.kicad_sch, SLI-Backplane-Blank-Card-KiCad.kicad_sch, mainboard.kicad_sch]
2022-05-13 friday updates
    [Avionics.kicad_sch, Power.kicad_sch, SLI-Backplane-Blank-Card-KiCad.kicad_sch, Solar Charge Regulator.kicad_sch, analog_mux.kicad_sch, mainboard.kicad_sch]
2022-05-15 preparing for battery testing
    [analog_mux.kicad_sch, mainboard.kicad_sch]
2022-05-16 text changes
    [SLI-Backplane-Blank-Card-KiCad.kicad_sch, Solar Charge Regulator.kicad_sch]
2022-05-19 Create Foras Promineo Software Flowcharts.pptx
2022-05-23 fm sch changes
    [5V_regulator.kicad_sch, Avionics.kicad_sch, Blank-Card-Default.kicad_sch, Burn_Wires.kicad_sch, Bus_Protection.kicad_sch, Connectors.kicad_sch, IMU.kicad_sch, Power.kicad_sch]
2022-05-24 fm layout work
    [Avionics.kicad_sch, Power.kicad_sch, SLI-Backplane-Blank-Card-KiCad.kicad_sch, Solar Charge Regulator.kicad_sch, analog_mux.kicad_sch, mainboard.kicad_sch]
2022-05-24 more fm layout
    [Avionics.kicad_sch, SLI-Backplane-Blank-Card-KiCad.kicad_sch, analog_mux.kicad_sch, mainboard.kicad_sch]
2022-05-31 fm board nearing completion
    [mainboard.xlsx, mainboard_log.xlsx]
2022-06-02 em2 stuff
    [5V_regulator.kicad_sch, 5V_regulator.sch, Avionics.kicad_sch, Avionics.sch, Blank-Card-Default.kicad_sch, Blank-Card-Default.sch, Burn_Wires.kicad_sch, Burn_Wires.sch]
2022-06-06 swapped sda and scl output to bus :(
    [SLI-Backplane-Blank-Card-KiCad.kicad_sch, foras software.xlsx]
2022-06-14 preping for interns
    [foras software.xlsx]
2022-06-17 em design complete
    todo: update BOM
    [5V_regulator.kicad_sch, Avionics.kicad_sch, Power.kicad_sch, SLI-Backplane-Blank-Card-KiCad.kicad_sch, Solar Charge Regulator.kicad_sch, foras software.xlsx, inhibit states.xlsx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]
2022-06-17 real em commit
    [SLI-Backplane-Blank-Card-KiCad.kicad_sch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]
2022-06-21 updated gerbers for stencils
    [mainboard-B_Cu.gbl, mainboard-B_Paste.gbp, mainboard-B_Silkscreen.gbo, mainboard-Edge_Cuts.gm1, mainboard-F_Cu.gtl, mainboard-F_Paste.gtp, mainboard-F_Silkscreen.gto, mainboard-job.gbrjob]
2022-06-24 updated BOM
    [mainboard.xlsx, mainboard_2.xlsx]
2022-06-24 updated em board for pcbway 6-layer tu-862 fabrication
    [Bus_Protection.kicad_sch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]
2022-07-11 battery and temp monitor task
2022-07-19 fixed bugs, filled functions
    [db_cmds.py, payload_cmds.py]
